richese/aeris/doc/presentations/presentation_q_learning.pdf

# Q learning - aproximácia funkcie ohodnotení neurónovou sieťou

# Michal CHOVANEC Fakulta riadenia a informatiky

# Jún 2015

Michal CHOVANEC Fakulta riadenia a informatiky | Q learning - aproximácia funkcie ohodnotení neurónovou sieťou

# Úvod

# Cieľom je nájsť optimálnu stratégiu - maximalizácia odmeny (účelovej funckie)

# - Vopred nie je známa hodnota odmeny vykonanej akcie

# - Vopred nie je známi ani stav do ktorého sa systém dostane

# - Je možné určiť v akom stave sa systém nachádza

# - Je presne daná množina akcií v každom stave

# - Aspoň pre cieľový stav je daná výška odmeny

# Úvod

# Aplikácie zo sveta robotických sytémov

# - Učenie sa pohybu, s ohľadom na techické prostriedky a terén - Multirobotické plánovanie - hľadanie optimálneho rozhodnutia pre celú skupinu

## - Mapovanie - Hľadanie cieľa - Robotický futbal - Capture the flag

# - Optimalizácia v automatických dopravných systémov

## - Dať prednosť, alebo predbehnúť - Kedy ísť zobrať náklad, predikcia

# - Všetky problémy kde : ako niečo urobiť je zložité popísať

## - Systém si učením sám nájde postup ako niečo robiť - Vyžaduje sa adativita a samostatnosť

# Q learning

# - Q(s, a) - funkcia ohodnotení

# - s - stav

# - a - akcia v stave s

# - R(s, a) - funkcia okamžitých odmien, za vykonanie a v stave s

s | ∈ S
as | ∈ As

# Q learning - prechod stavovým priestorom

# Markovov rozhodovací proces

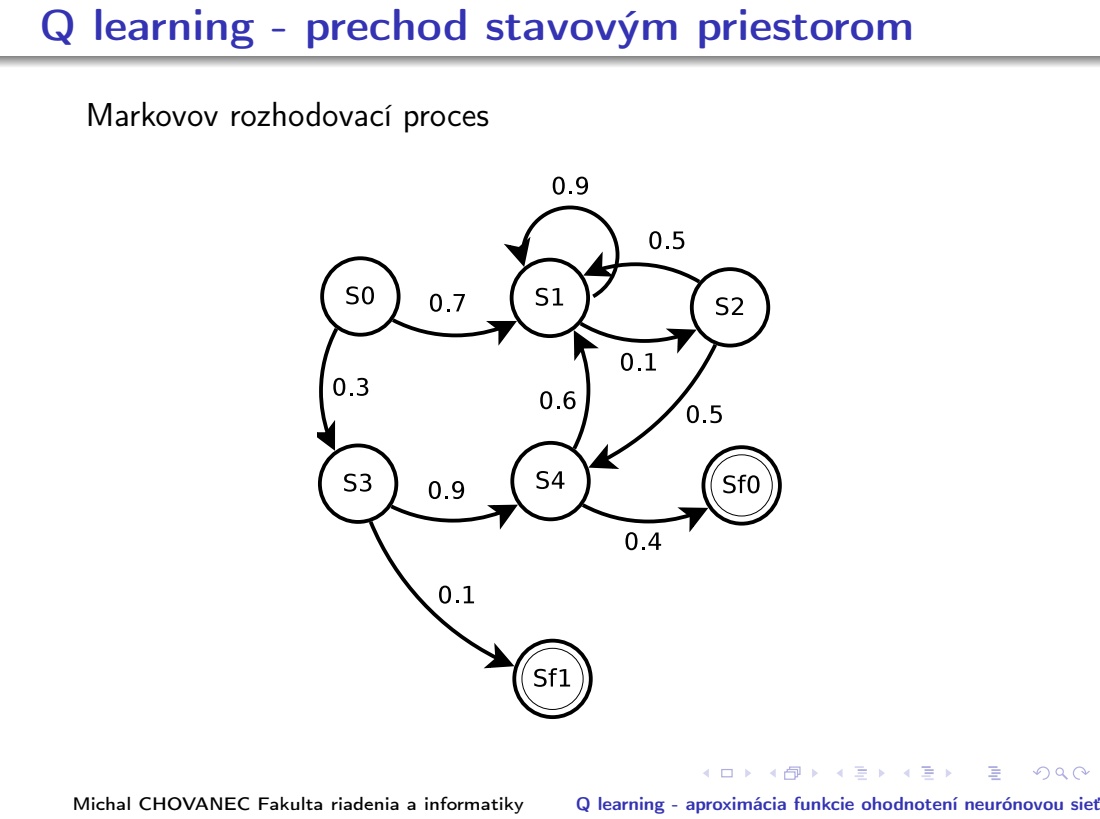
[picture p8: page 5]

# Q learning - ohodnotenie Q(s, a)

# Z Bellmanového princípu optimality

# Qn+1(s, a) = Rn+1(s, a) + γ max

a

0

# Qn(s

0
n+1

, a

0
) | (1)

# Kde Rn+1(s, a) je získaná odmena (reward) za vykonanie akcie a v stave s v čase n + 1

# maxa

# 0 Qn(s

0
n+1

, a

0

# ) je výber akcie v stave sn+1 ktorá má najväčšia odmenu

# γ je podiel z maximálnej odmeny v stave s

0
n+1

# pri vykonaní najlepšej možnej akcie v tomto stave

# Q learning - ohodnotenie Q(s, a)

# Varianty algoritmu Filtrovanie v stochastickom prostredí

# Qn+1(s, a) = αQn(s, a) + (1 − α)(Rn+1(s, a) + γ max

a

0

# Qn(s

0
n+1

, a

0
))

# SARSA algoritmus

# Qn+1(s, a) = αQn(s, a) + (1 − α)(Rn+1(s, a) + γQn(s

0
n+1

, a

0
))

# kde α ∈ h0, 1)

# Q learning - výber akcie

# Boltzmanové rozdelanie

# P(s|ai) = k

### Q(s,ai )

P
| j∈A

k

### Q(s,aj )

# Kde k ∈ h0, ∞) a určuje správanie sa agenta, pre Q(s, a) ∈ h−1, 1i možno pozorovať tieto druhy správania

# - k = 1 prieskumník

# - k = h2, 10i zlatý stred

# - k >> 10 pažravý (greedy) agent

# Q learning - problémy

# - Rosiahly stavový priestor, Q(s, a) je možné nájsť len približne

## - Interpolácia - Transformácia pomocou features a ich lineárna kombinácia - Aproximácia neurónovou sieťou

# - Výber akcie

## - Tak aby neboli prehľadávané akcie ktoré nemajú cenu

# - Zdieľanie a syntéza Q(s, a) medzi viacerími agentami

# Experiment

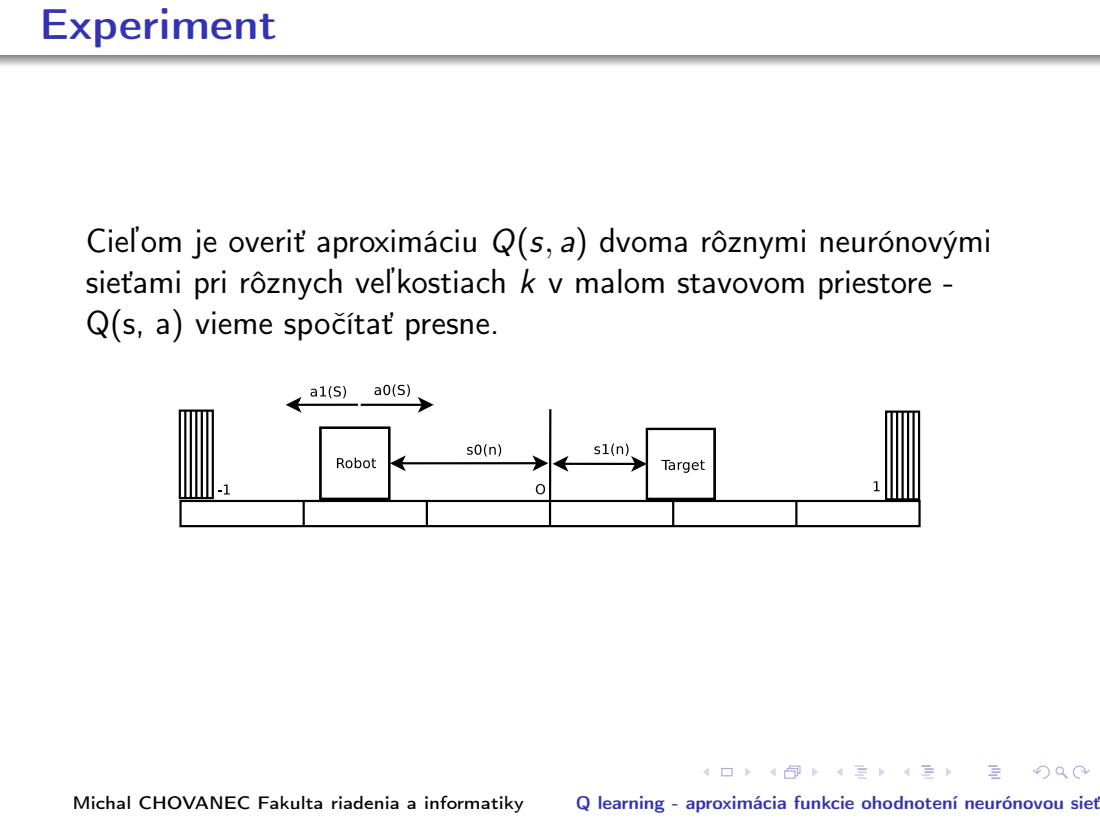
[picture p9: page 10]

Cieľom je overiť aproximáciu Q(s, a) dvoma rôznymi neurónovými
sieťami pri rôznych veľkostiach k v malom stavovom priestore -
Q(s, a) vieme spočítať presne.

# Experiment

# Boli porovnávané dva modely neurónov s optimálnym riešením

# y(n) = ϕ(

N

X⁻¹

i=0

xi(n)wi(n)) | (2)

# y(n) = X∞

j=1

N

X⁻¹

i=0

x

j
i

# (n)wji(n) +

N

X⁻¹

j=0

N

X⁻¹

i=j+1

# xi(n)xj(n)vji(n) (3)

# Prečo by 3 mal byt lepší? Kolmogorov teorém 3 skryté vrstvy !

# Experiment

# Hypotéza :

# Problém aproximácie q = Q(s, a) je pridelenie každému s, a práve jedno q. To vedie na formuláciu : AK je systém v stave s A bola vykonaná akcia a, POTOM výstup je

q.

# Pre jeden stav a dve akcie (ohodnotené ako a0, a1) možno napísať

q = va0 + (1 − v)a1 | (4)

# Kde v je výber akcie a platí v ∈ h0, 1i. Pozn. všetky veličiny sú

premenné. To je ale potom v súlade s 3.

# Experiment - parametre

## iterations = 10000000

## agent :

## state_density = 1/8.0 alpha = 0.98 gamma = 0.7

## neural network :

## hidden layers = 2 neurons in hidden layers = 10 weight range = 4.0 neuron order = 7 init weight range = 0.1 eta = 0.001

# Experiment, k = 1.1, optimálne riešenie

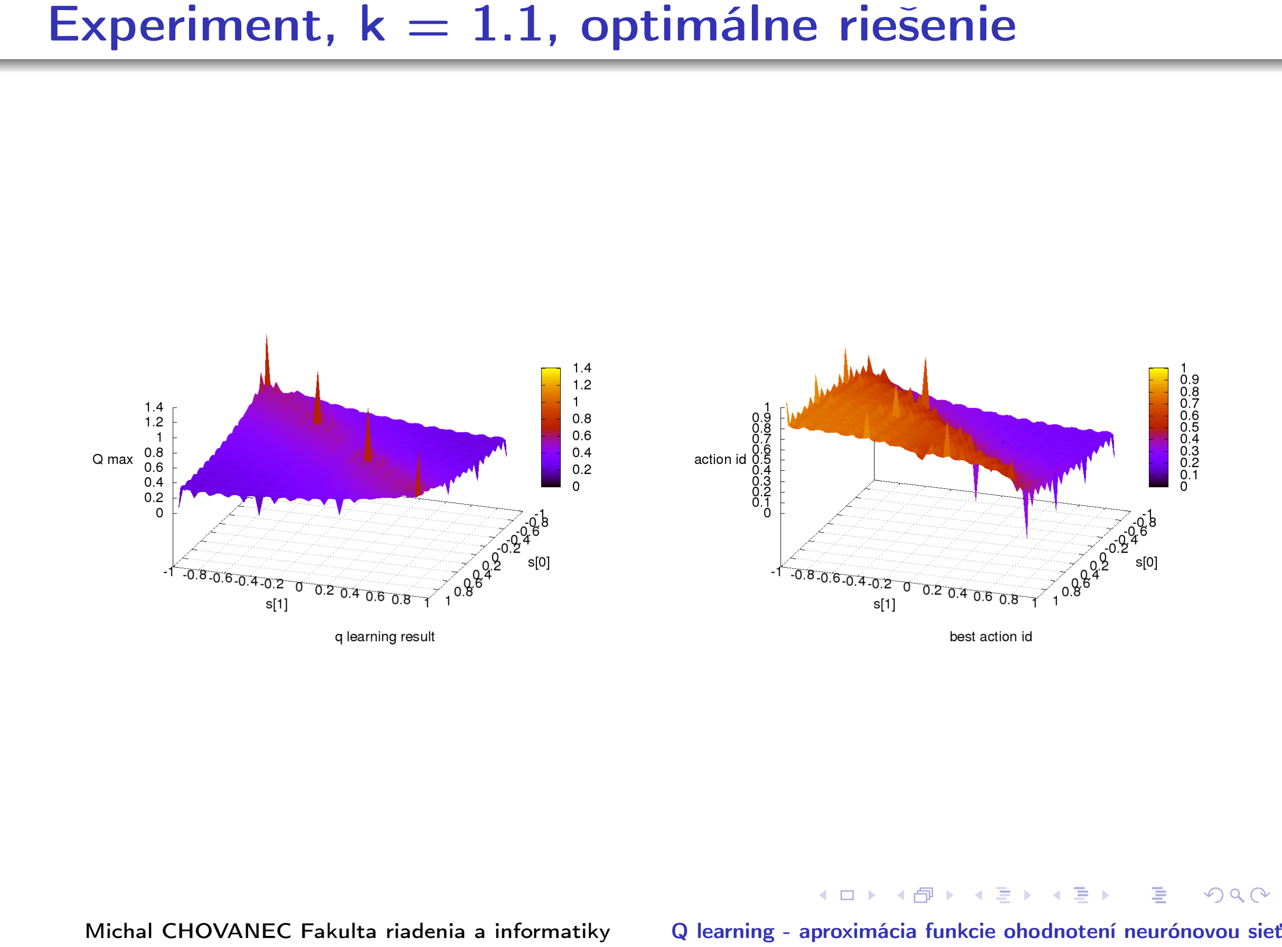
[picture p10: page 14]

# Experiment, k = 1.1, mcculloch pitts neurón

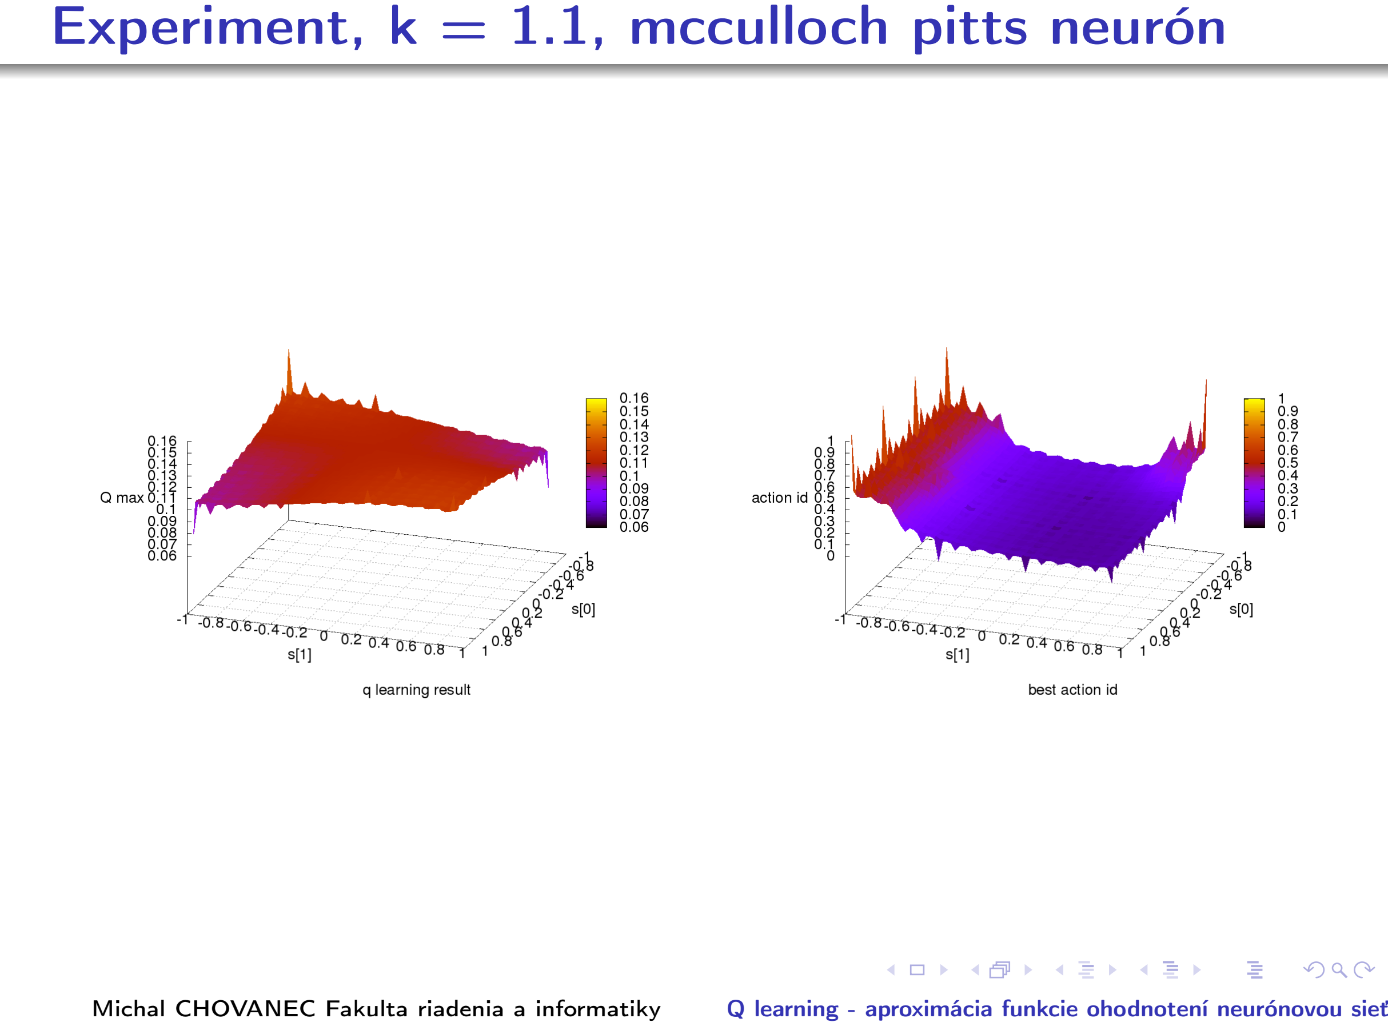
[picture p11: page 15]

# Experiment, k = 1.1, testovaný neurón

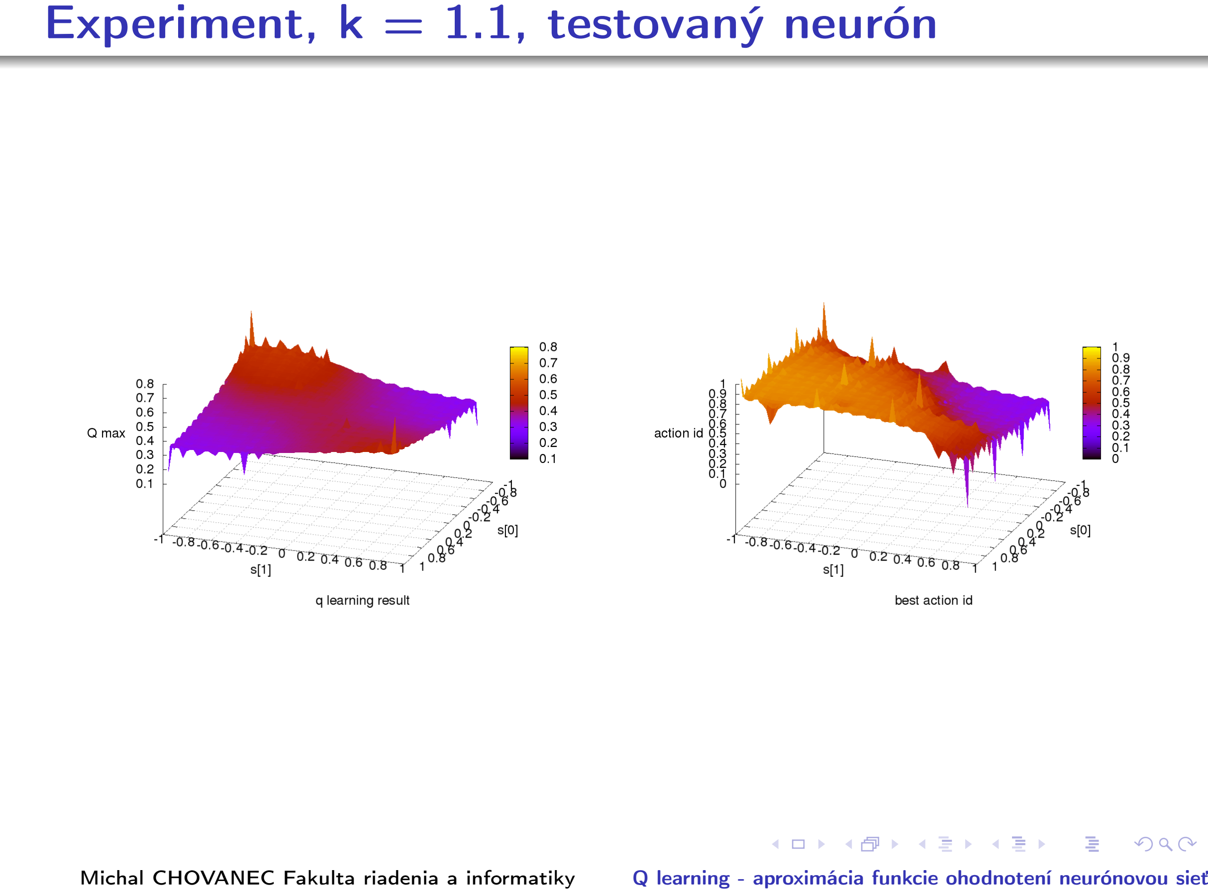
[picture p12: page 16]

# Experiment, k = 2.0, optimálne riešenie

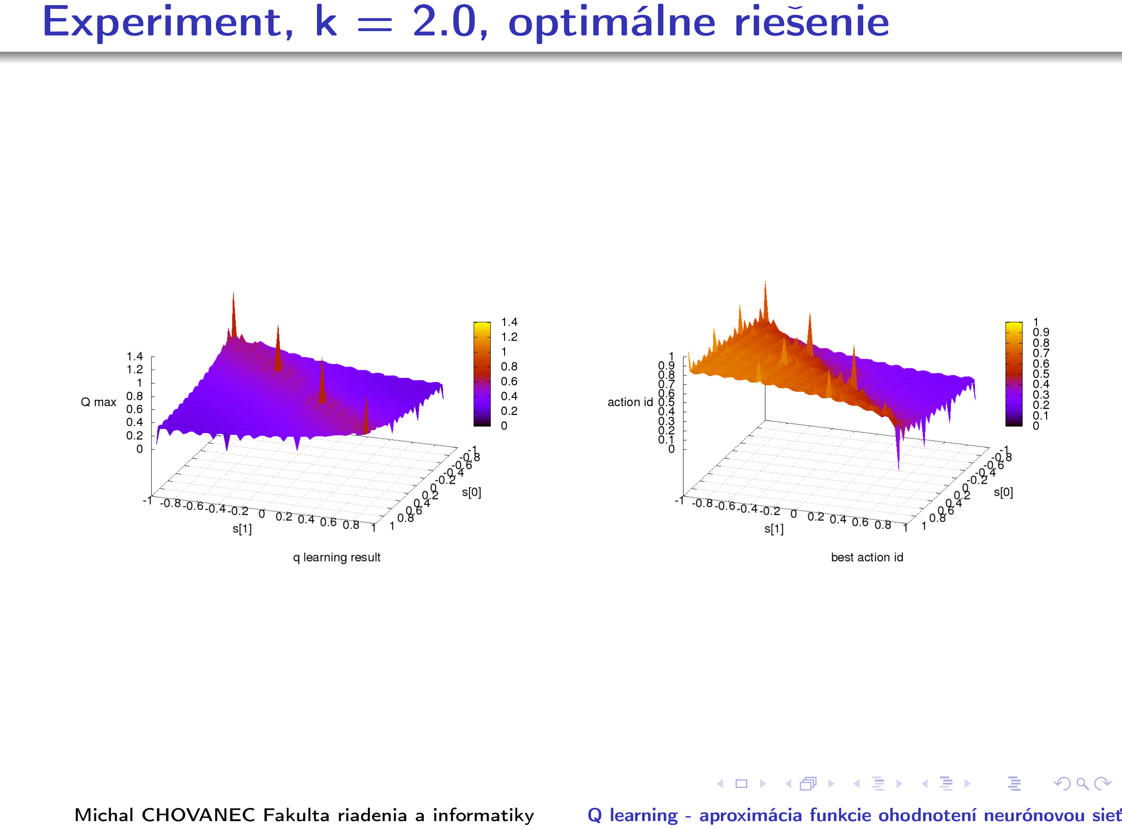
[picture p13: page 17]

# Experiment, k = 2.0, mcculloch pitts neurón

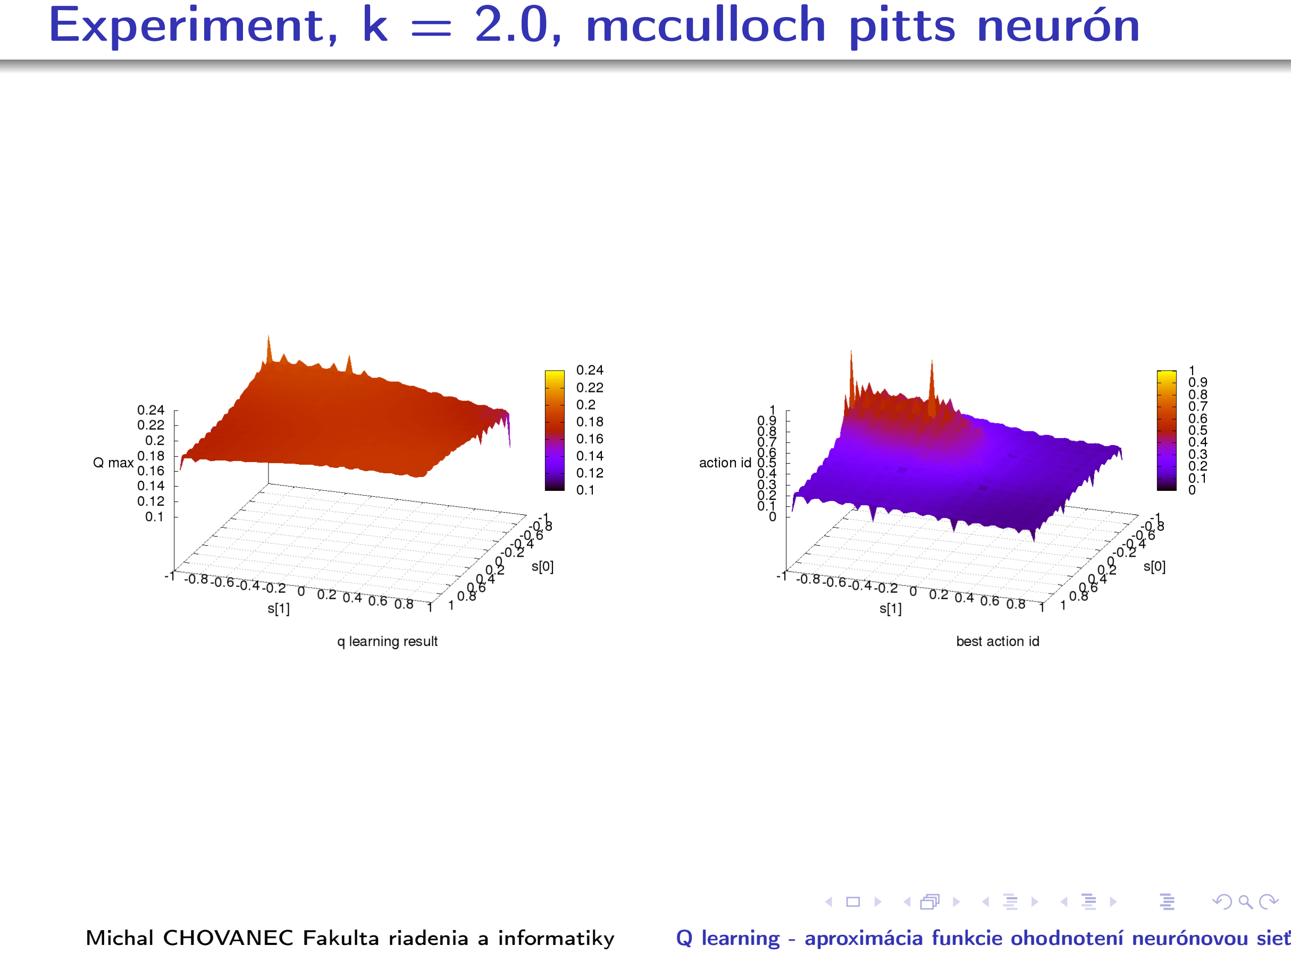
[picture p14: page 18]

# Experiment, k = 2.0, testovaný neurón

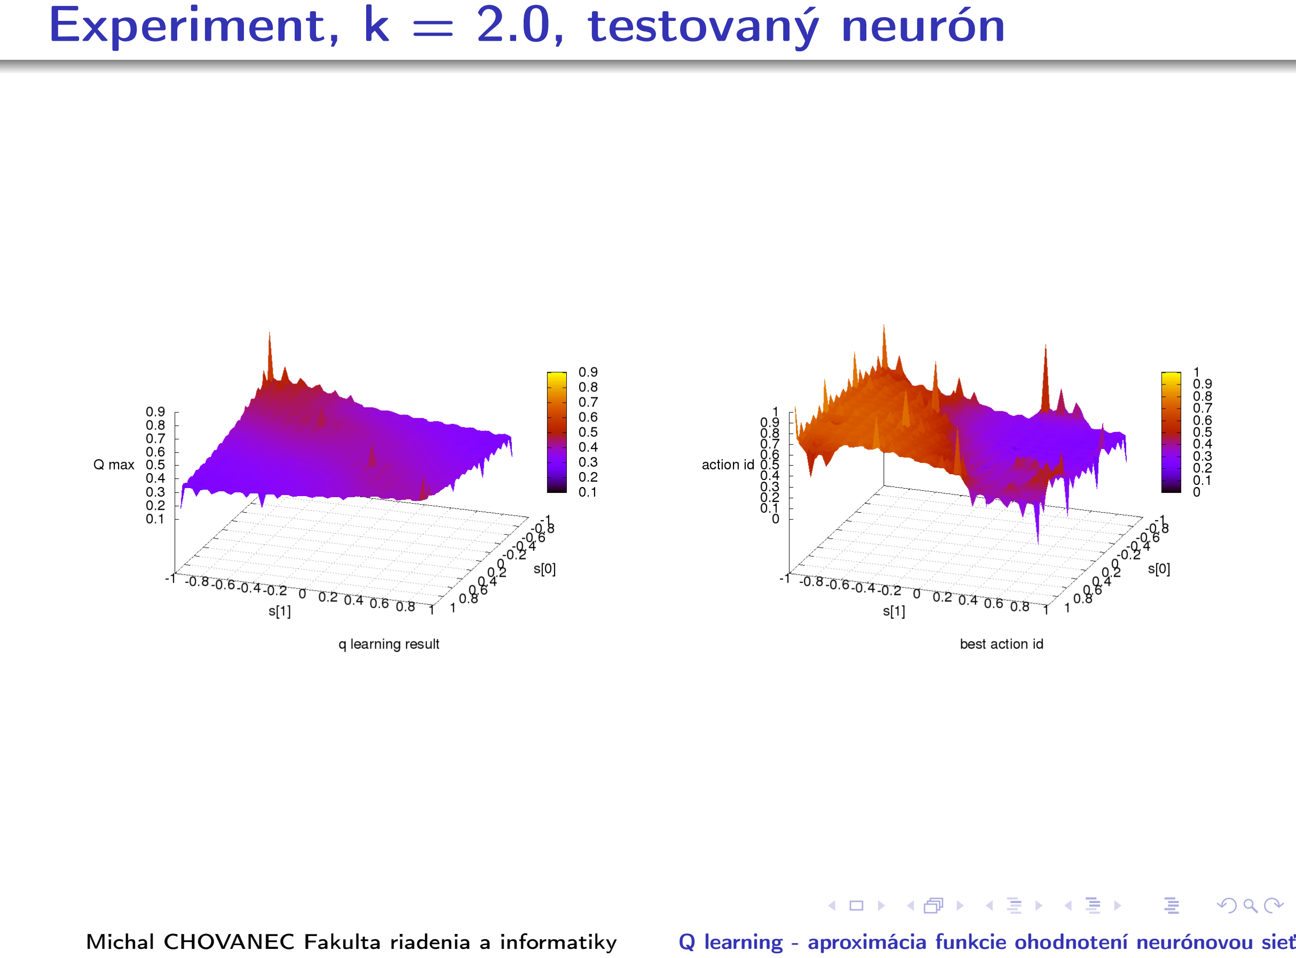
[picture p15: page 19]

# Experiment, k = 10.0, optimálne riešenie

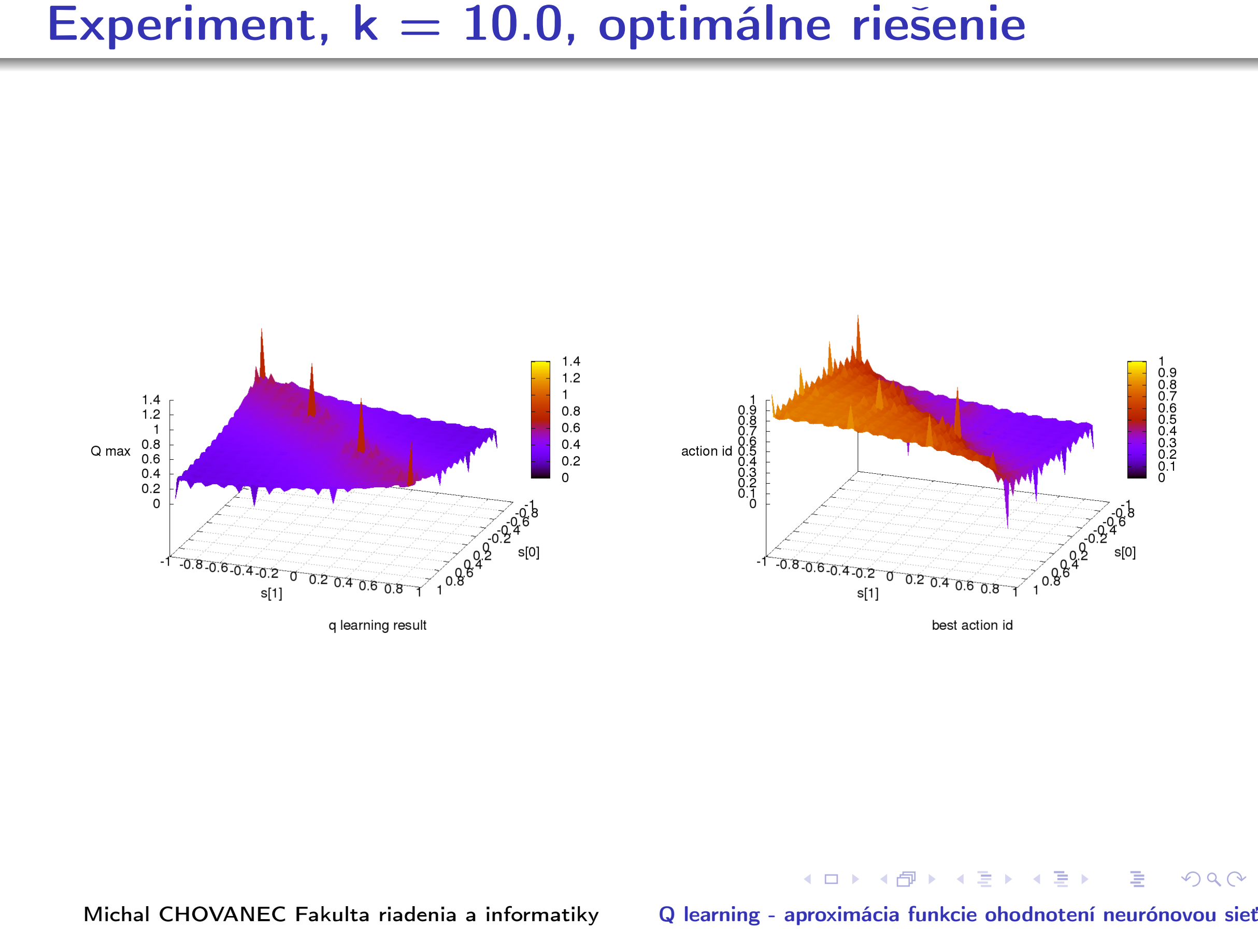
[picture p16: page 20]

# Experiment, k = 10.0, mcculloch pitts neurón

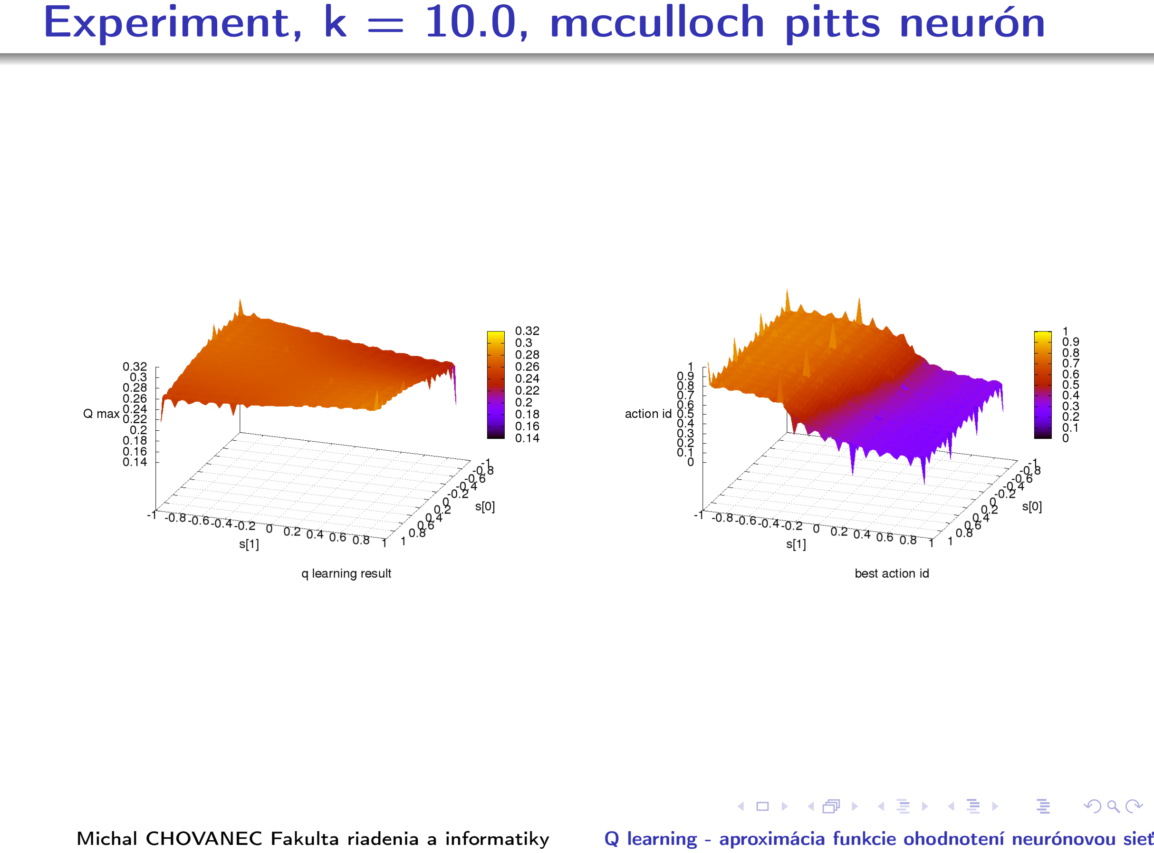
[picture p17: page 21]

# Experiment, k = 10.0, testovaný neurón

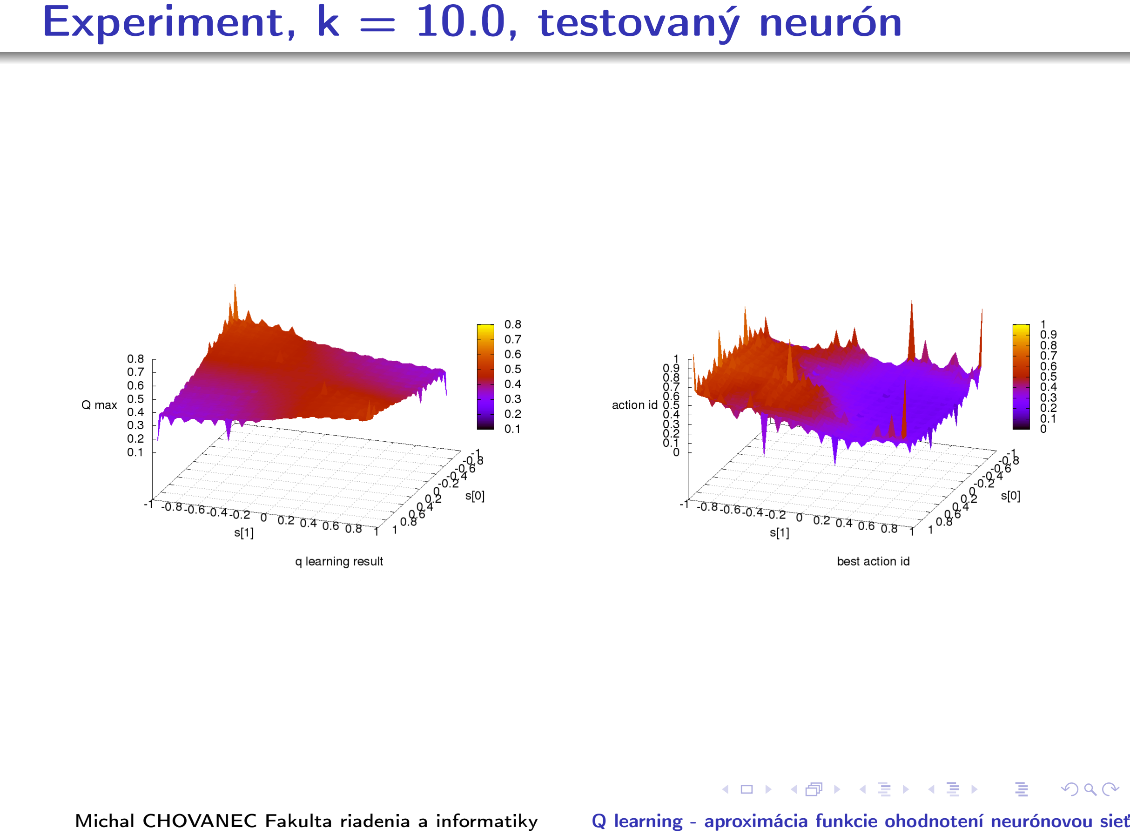
[picture p18: page 22]

# Experiment - zhrnutie

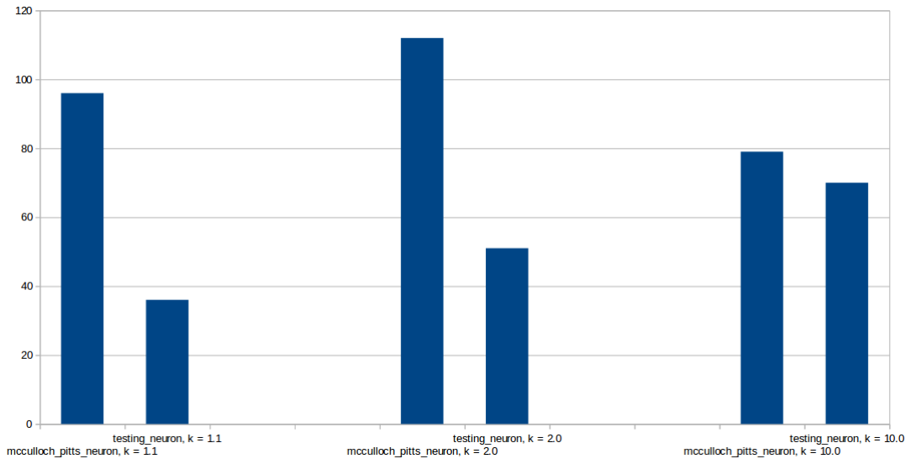
[picture p19: figure]

# Nevyriešené otázky

# ... ktorými sa momentálne zaoberám

# 1 Zrýchliť učenie neurónovej siete

# 2 Urobiť experiment vo veľkom stavovom priestore

# 3 Implementácia do vyvíjaného multirobotického frameworku

# Ďakujem za pozornosť

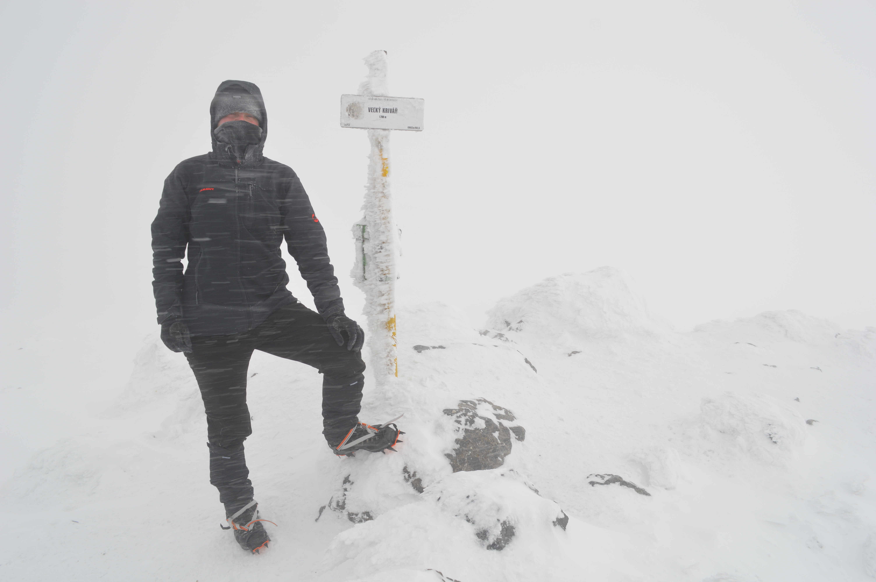
[picture p20: figure]

# michal.chovanec@yandex.com
