richese/aeris/doc/papers/q_learning/template.pdf

# Paper title

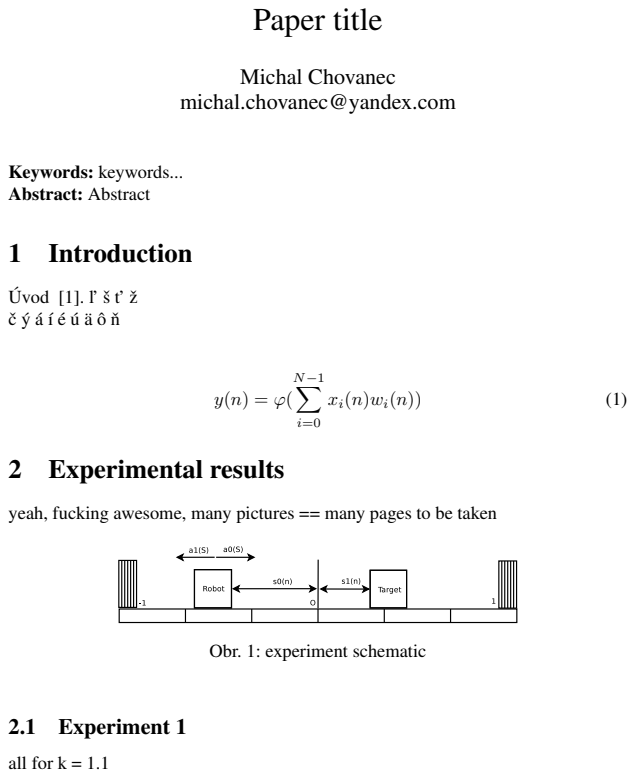
[picture p29: page 1]
Michal Chovanec; Keywords: keywords... Abstract: Abstract; 1 Introduction; Úvod [1]. l’ š t’ ž; 2 Experimental results; 2.1 Experiment 1; all for k = 1.1

michal.chovanec@yandex.com

yeah, fucking awesome, many pictures == many pages to be taken

Obr. 1: experiment schematic

Obr. 2: table Q max value

Obr. 3: table action id

Obr. 4: table action value

Obr. 5: mcculloch pitts neuron Q max value

Obr. 6: mcculloch pitts neuron best action id

Obr. 7: mcculloch pitts neuron best action value

Obr. 8: testing neuron Q max value

Obr. 9: testing neuron best action id

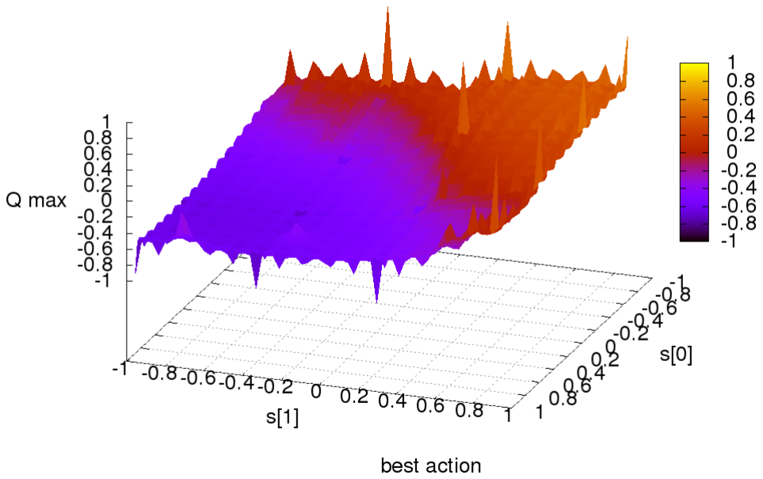
[picture p30: figure]

Obr. 10: testing neuron best action value

### 2.2 Experiment 2

all for k = 2.0

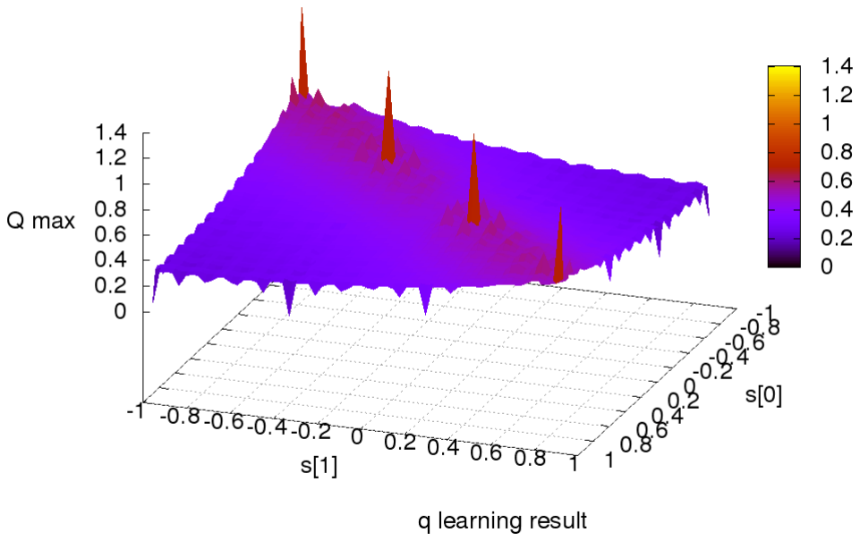
[picture p31: figure]

Obr. 11: table Q max value

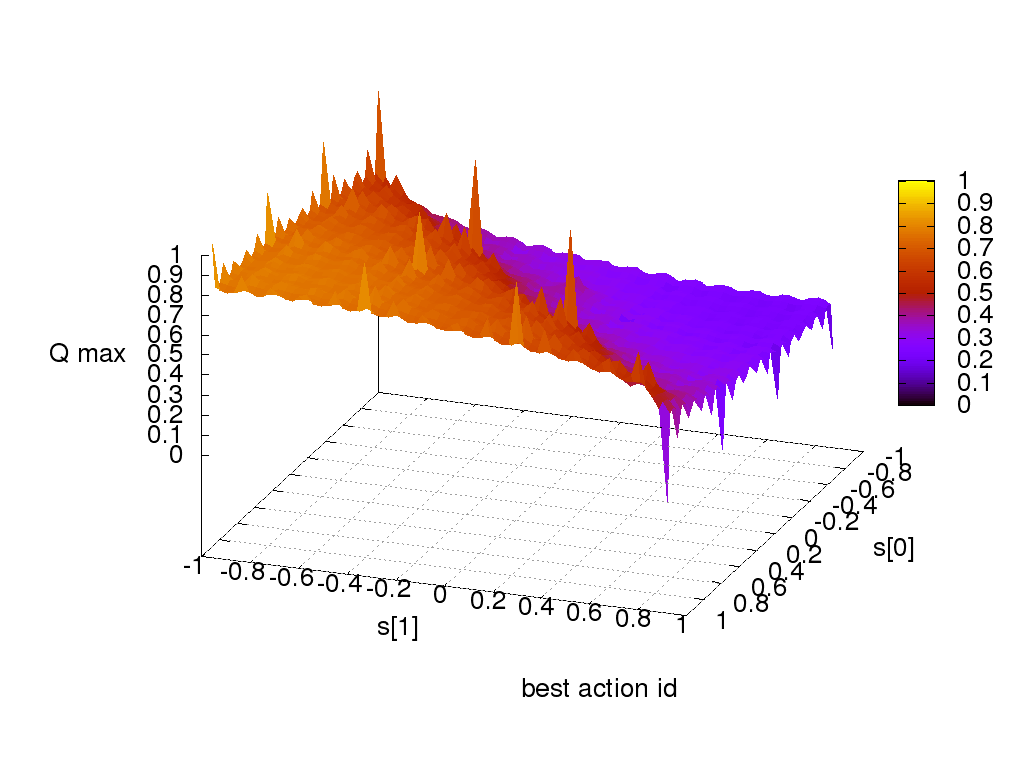
[picture p32: figure]

Obr. 12: table action id

Obr. 13: table action value

Obr. 14: mcculloch pitts neuron Q max value

Obr. 15: mcculloch pitts neuron best action id

Obr. 16: mcculloch pitts neuron best action value

Obr. 17: testing neuron Q max value

Obr. 18: testing neuron best action id

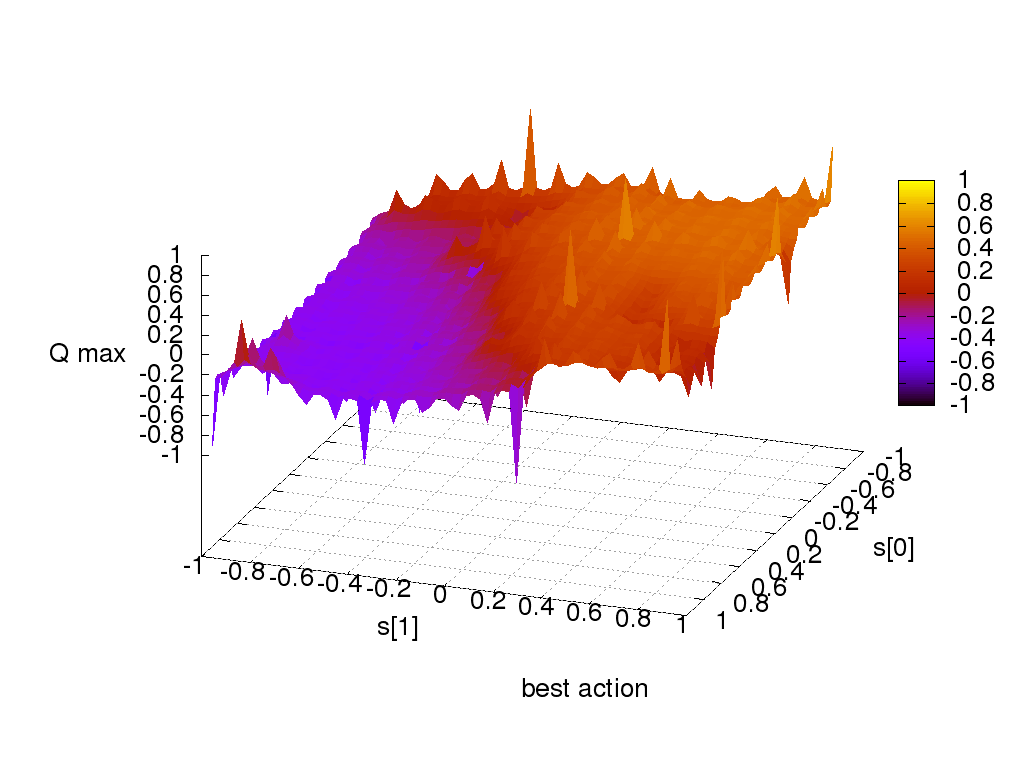
[picture p33: figure]

Obr. 19: testing neuron best action value

### 2.3 Experiment 3

all for k = 10.0

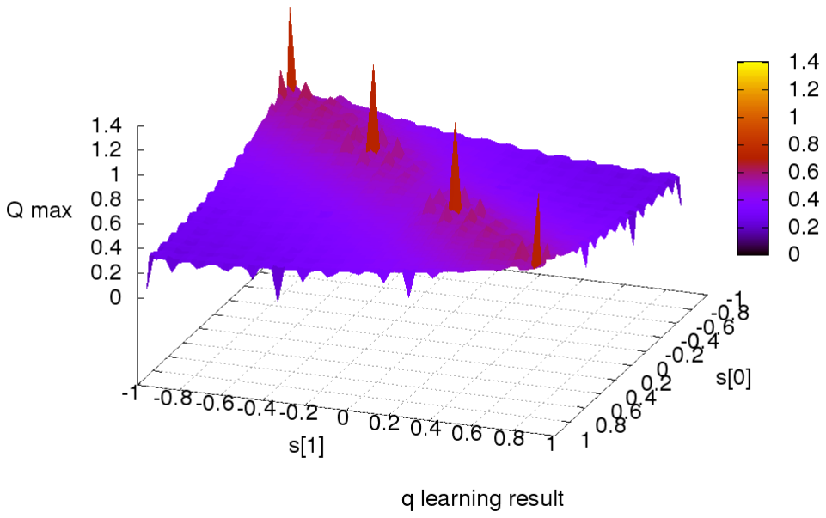
[picture p34: figure]

Obr. 20: table Q max value

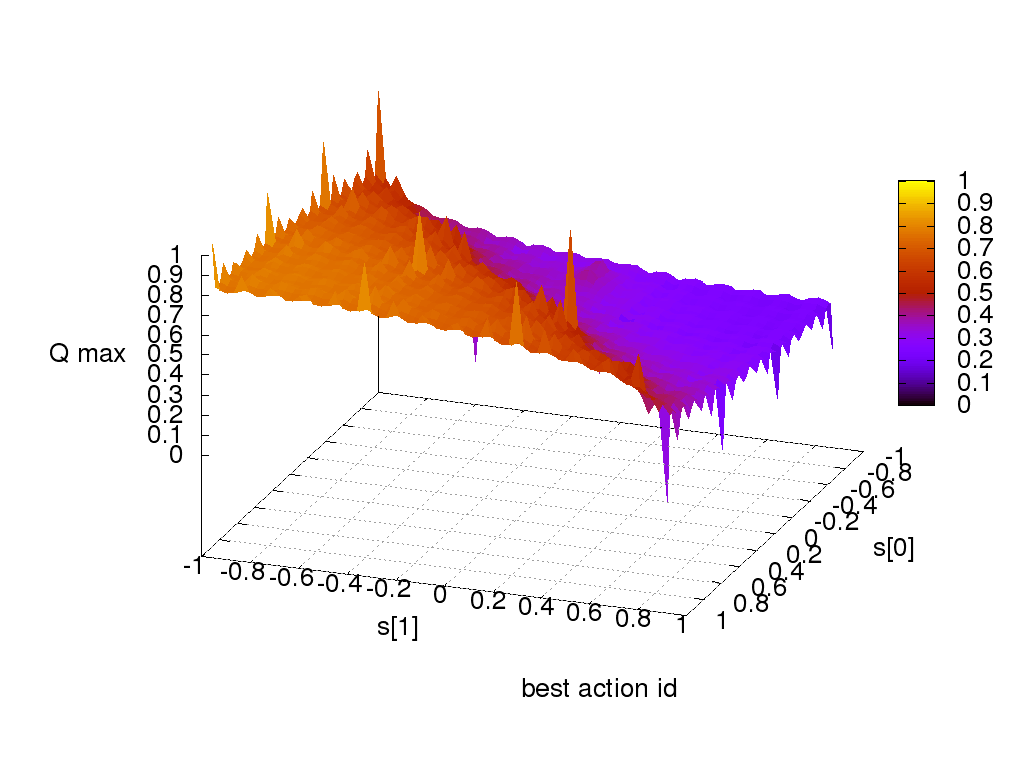
[picture p35: figure]

Obr. 21: table action id

Obr. 22: table action value

Obr. 23: mcculloch pitts neuron Q max value

Obr. 24: mcculloch pitts neuron best action id

Obr. 25: mcculloch pitts neuron best action value

Obr. 26: testing neuron Q max value

Obr. 27: testing neuron best action id

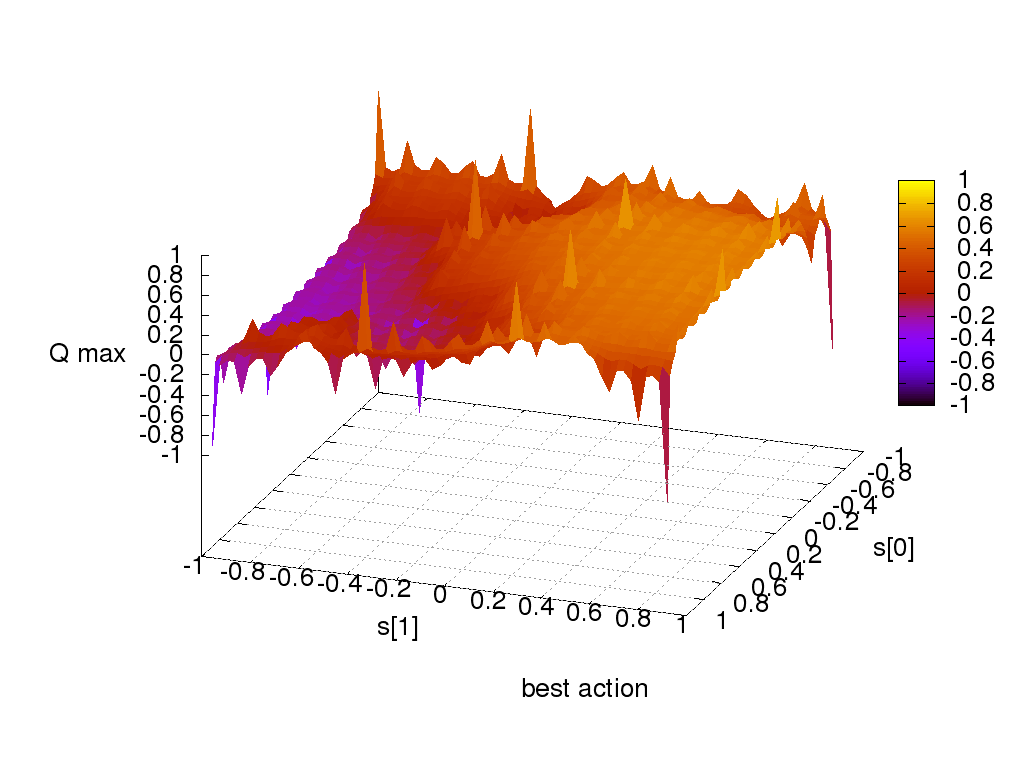
[picture p36: figure]

Obr. 28: testing neuron best action value

## 3 Zaver

## Literatúra

[1] Kolmogorov’s Theorem, http://neuron.eng.wayne.edu/tarek/MITbook/chap2/2_3.html
