richese/aeris/doc/diagrams/aeris_idea.png

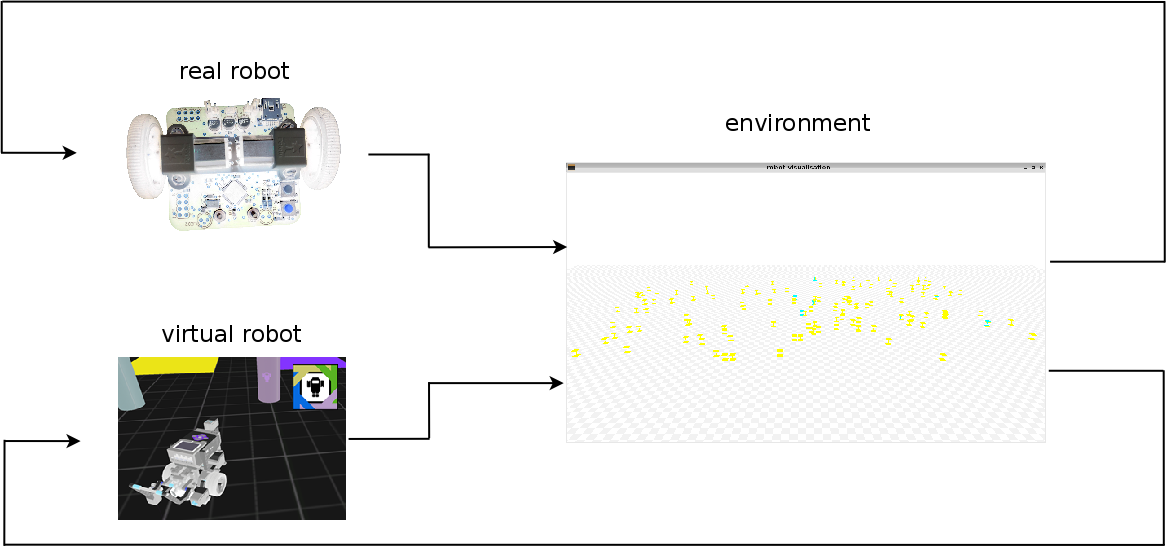
doc/diagrams/aeris_idea.png
