richese/aeris/doc/pictures/aeris_photo_02.png

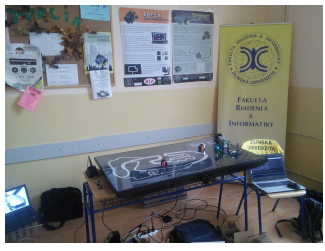
doc/pictures/aeris_photo_02.png
