richese/aeris/doc/pictures/aeris_static_linefollower_2.png

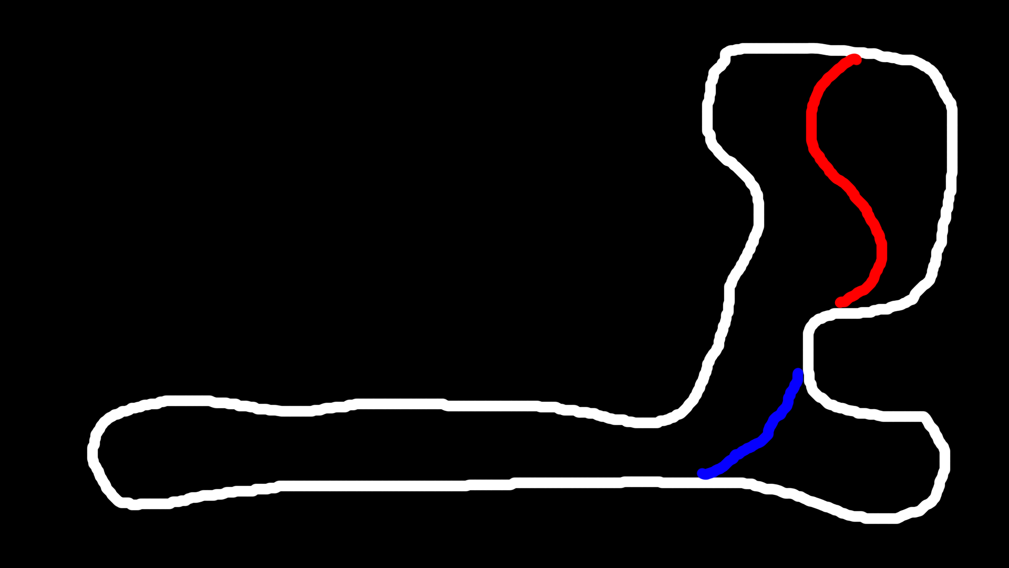
doc/pictures/aeris_static_linefollower_2.png
