richese/aeris/doc/pictures/desc_bottom.jpg

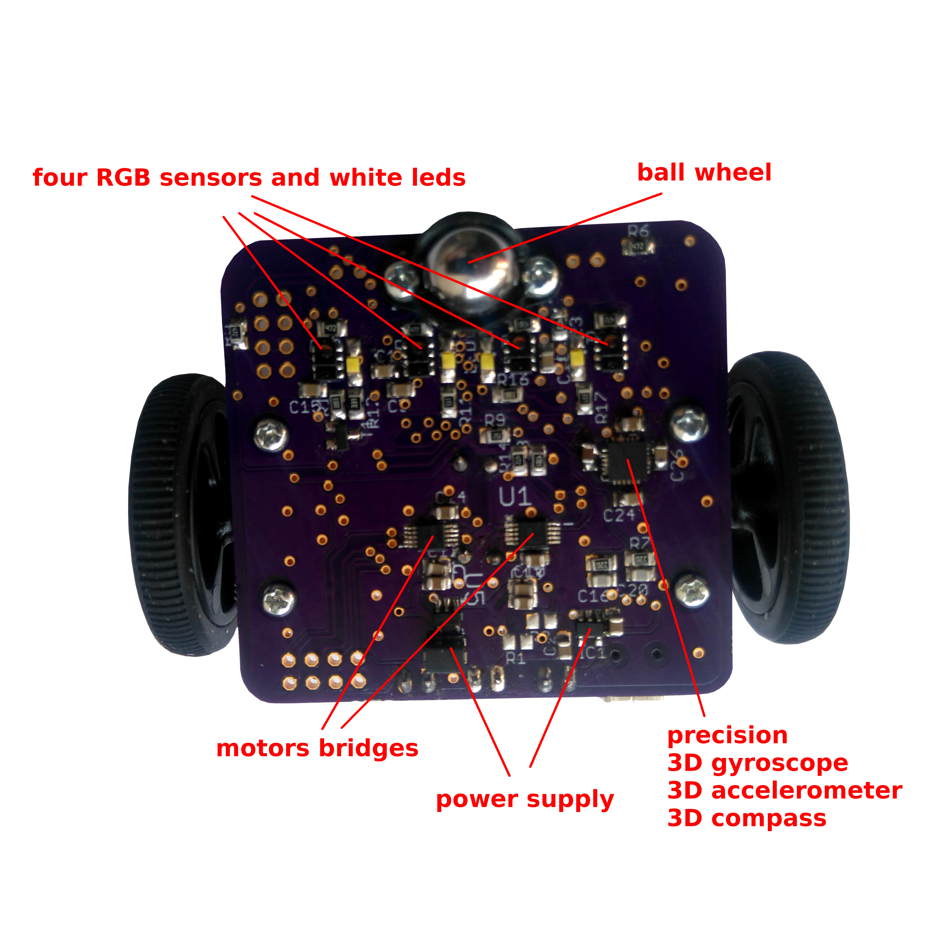
doc/pictures/desc_bottom.jpg
