richese/aeris/doc/pictures/desc_top.jpg

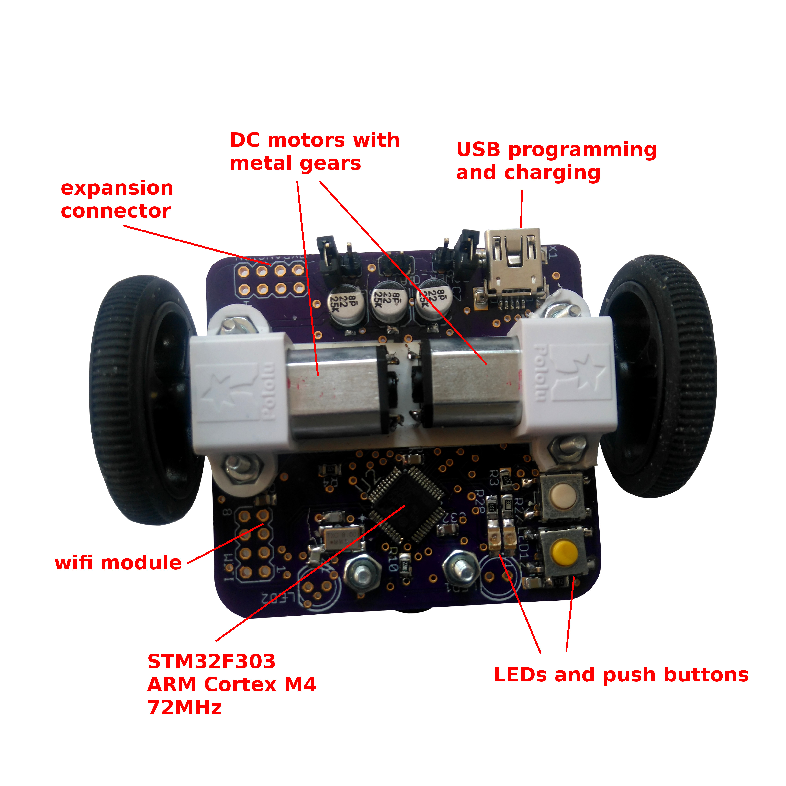
doc/pictures/desc_top.jpg
