richese/aeris/doc/pictures/virtual_env.png

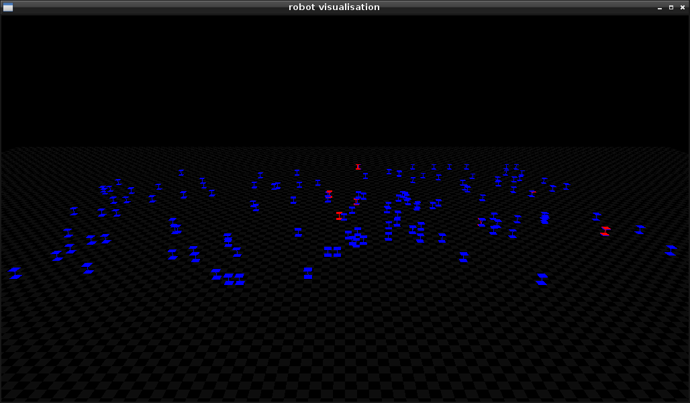
doc/pictures/virtual_env.png
