richese/aeris/doc/pictures/virtual_env_inv.png

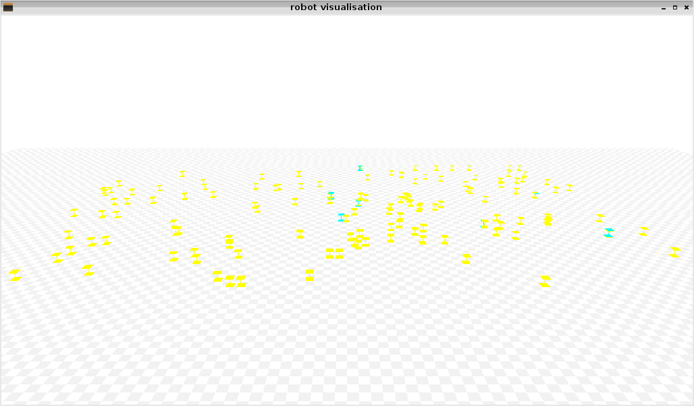
doc/pictures/virtual_env_inv.png
