richese/aeris/doc/pictures/virtual_robot.png

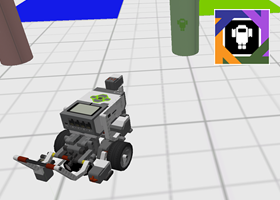
doc/pictures/virtual_robot.png
