richese/aeris/doc/pictures/virtual_robot_inv.png

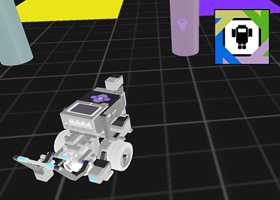
doc/pictures/virtual_robot_inv.png
