richese/aeris/embedded/hardware_2.0/rev_1.0/main_board/png_export/schem.png

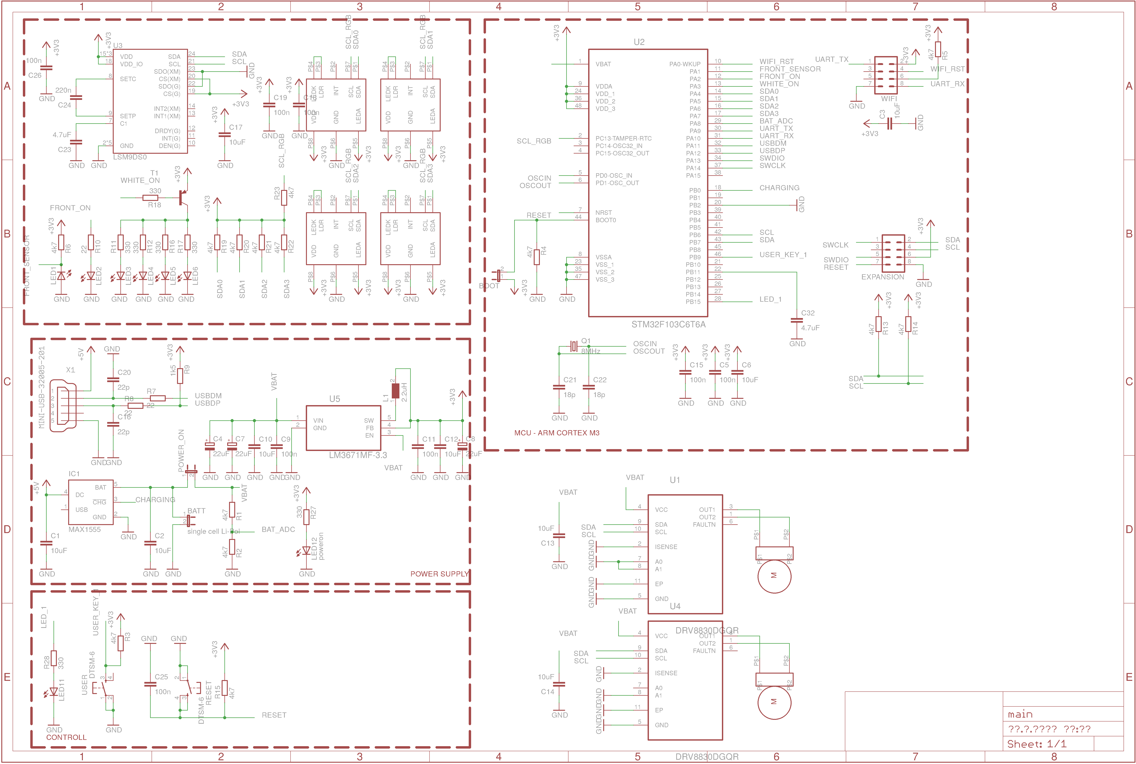
embedded/hardware_2.0/rev_1.0/main_board/png_export/schem.png
