richese/aeris/embedded/hardware_current/rev_1.0/main_board/schematic/main_board.png

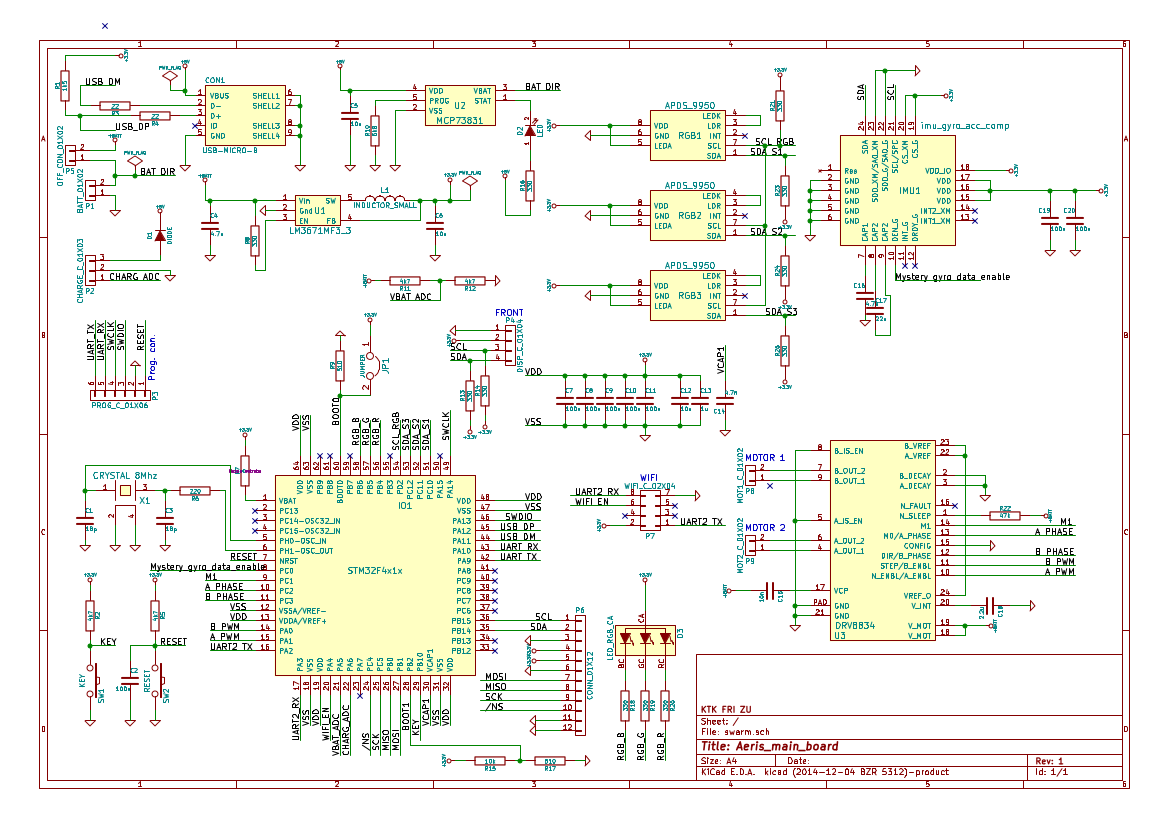
embedded/hardware_current/rev_1.0/main_board/schematic/main_board.png
