richese/aeris/src/tmp/ilc/bin/maneuvers_error.png

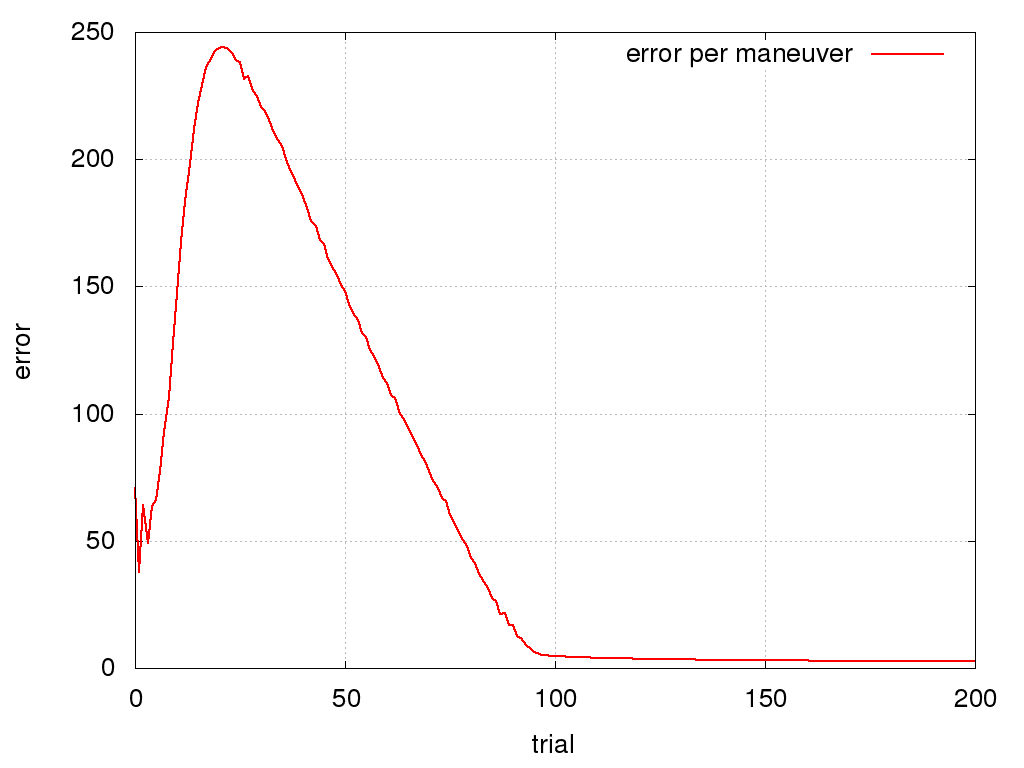
src/tmp/ilc/bin/maneuvers_error.png
