richese/aeris/src/tmp/ilc/bin/oscilating/maneuvers_error.png

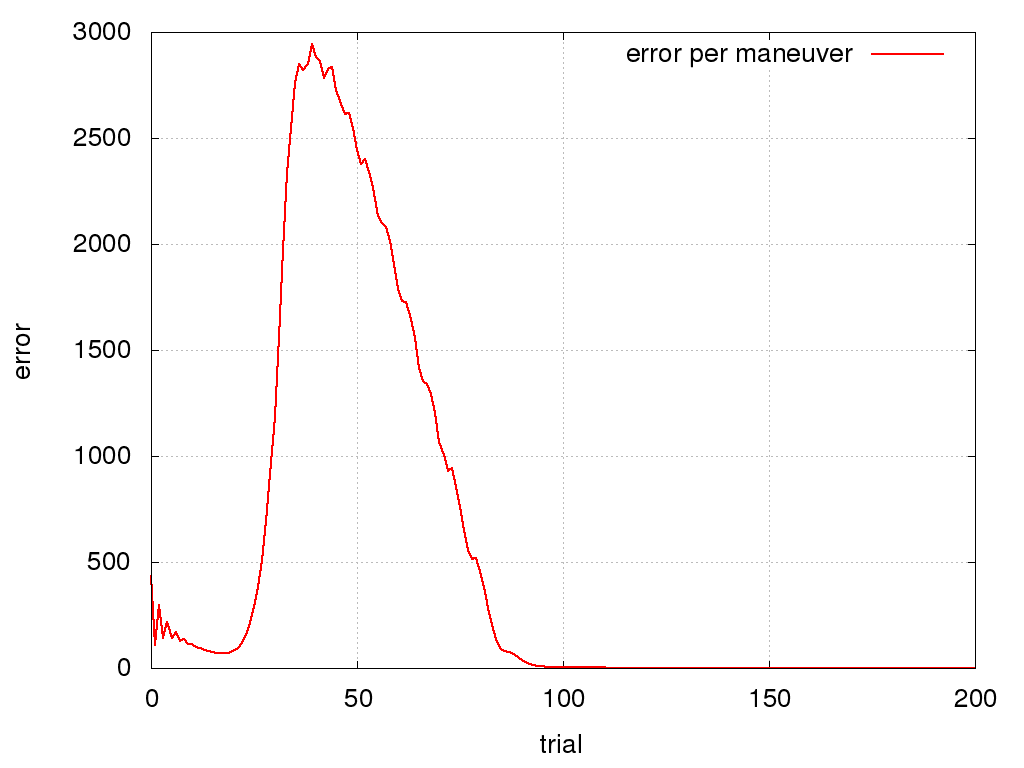
src/tmp/ilc/bin/oscilating/maneuvers_error.png
