richese/aeris/src/tmp/ilc/bin/servo_plant/maneuvers_error.png

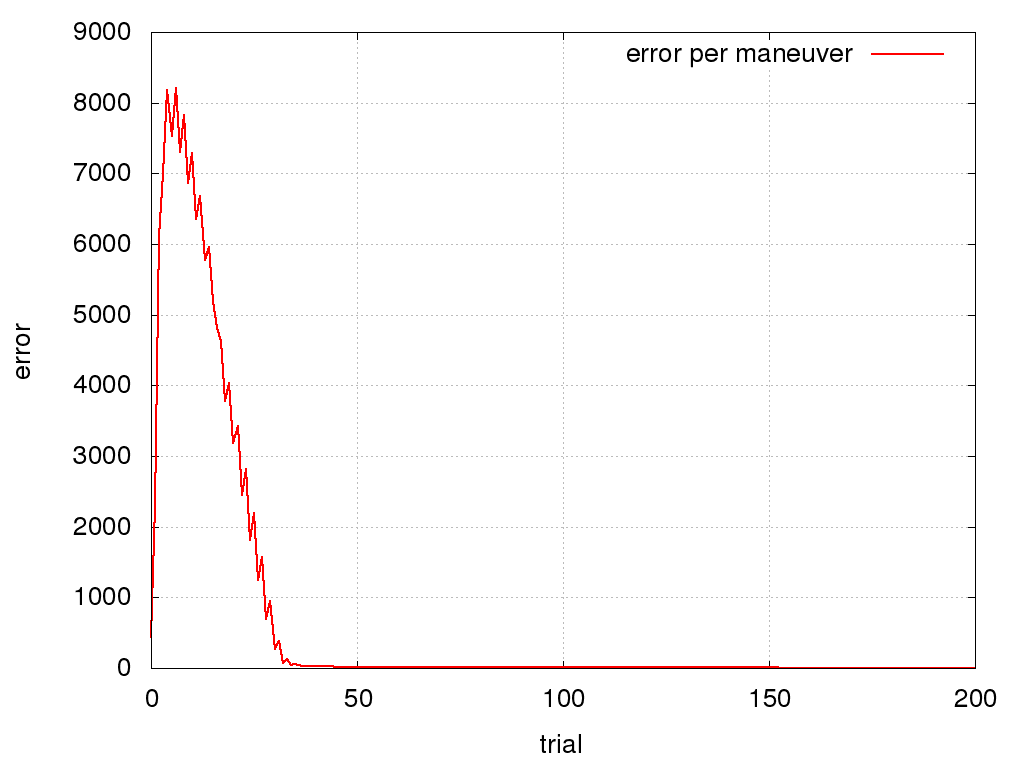
src/tmp/ilc/bin/servo_plant/maneuvers_error.png
