richese/aeris/src/tmp/ilc/bin/2nd_order/maneuvers_error.png

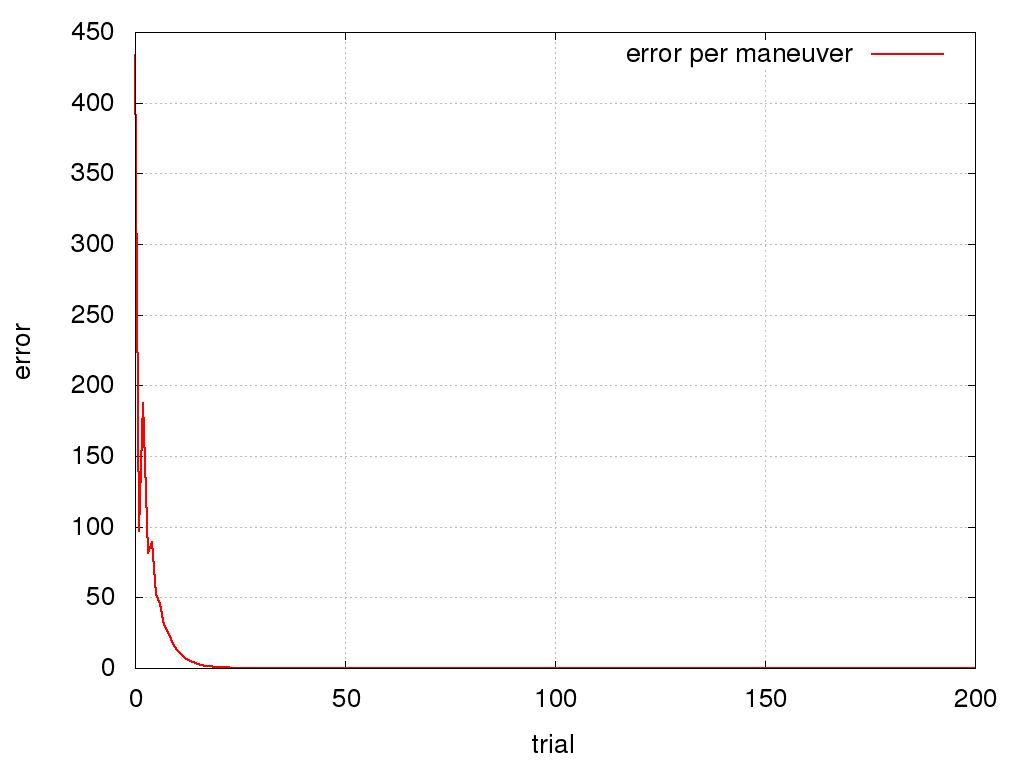
src/tmp/ilc/bin/2nd_order/maneuvers_error.png
