richese/aeris/src/tmp/ilc/bin/3rd_order/maneuvers_error.png

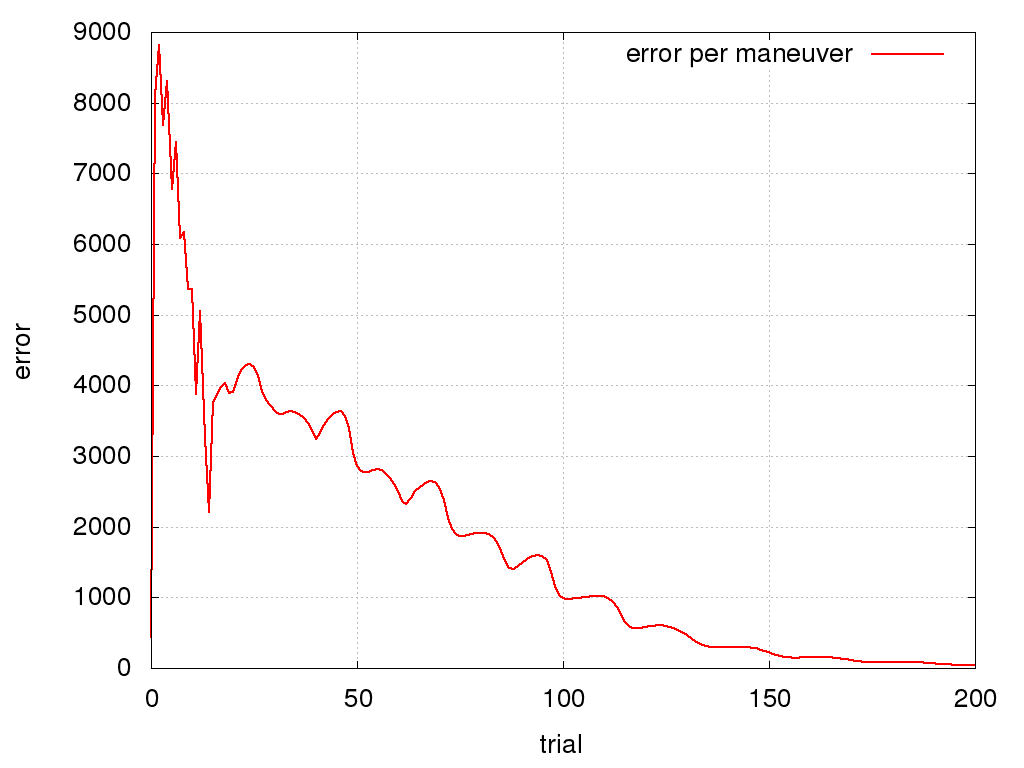
src/tmp/ilc/bin/3rd_order/maneuvers_error.png
