richese/aeris/doc/experiments_results/q_learning_test/comparsion.ods

Sheet: Sheet1
Experiment 01
mcculloch_pitts_neuron |  |  | error | testing_neuron |  |  | error | table
-1 | -1 | 1 | 1 | -1 | -1 | 1 | 1 | -1 | -1 | 0
-0.875 | -1 | 1 | 0 | -0.875 | -1 | 1 | 0 | -0.875 | -1 | 1
-0.75 | -1 | 1 | 0 | -0.75 | -1 | 1 | 0 | -0.75 | -1 | 1
-0.625 | -1 | 1 | 0 | -0.625 | -1 | 1 | 0 | -0.625 | -1 | 1
-0.5 | -1 | 1 | 0 | -0.5 | -1 | 1 | 0 | -0.5 | -1 | 1
-0.375 | -1 | 1 | 0 | -0.375 | -1 | 1 | 0 | -0.375 | -1 | 1
-0.25 | -1 | 1 | 0 | -0.25 | -1 | 1 | 0 | -0.25 | -1 | 1
-0.125 | -1 | 1 | 0 | -0.125 | -1 | 1 | 0 | -0.125 | -1 | 1
0 | -1 | 1 | 0 | 0 | -1 | 1 | 0 | 0 | -1 | 1
0.125 | -1 | 1 | 0 | 0.125 | -1 | 1 | 0 | 0.125 | -1 | 1
0.25 | -1 | 1 | 0 | 0.25 | -1 | 1 | 0 | 0.25 | -1 | 1
0.375 | -1 | 1 | 0 | 0.375 | -1 | 1 | 0 | 0.375 | -1 | 1
0.5 | -1 | 1 | 0 | 0.5 | -1 | 1 | 0 | 0.5 | -1 | 1
0.625 | -1 | 1 | 0 | 0.625 | -1 | 1 | 0 | 0.625 | -1 | 1
0.75 | -1 | 1 | 0 | 0.75 | -1 | 1 | 0 | 0.75 | -1 | 1
0.875 | -1 | 1 | 0 | 0.875 | -1 | 1 | 0 | 0.875 | -1 | 1
-1 | -0.875 | 1 | 1 | -1 | -0.875 | 0 | 0 | -1 | -0.875 | 0
-0.875 | -0.875 | 1 | 0 | -0.875 | -0.875 | 1 | 0 | -0.875 | -0.875 | 1
-0.75 | -0.875 | 1 | 0 | -0.75 | -0.875 | 1 | 0 | -0.75 | -0.875 | 1
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
