richese/aeris/src (copy)/old/tmp/curve/bin/result.txt

0.000000	2.000000	0.000000	0.000000	0.000000	
0.035257	2.016709	0.000000	0.000000	0.000000	
0.078960	2.026845	0.000000	0.000000	0.000000	
0.130943	2.030440	0.000000	0.000000	0.000000	
0.190946	2.027552	0.000000	0.000000	0.000000	
0.258623	2.018267	0.000000	0.000000	0.000000	
0.333541	2.002695	0.000000	0.000000	0.000000	
0.415187	1.980973	0.000000	0.000000	0.000000	
0.502972	1.953262	0.000000	0.000000	0.000000	
0.596234	1.919746	0.000000	0.000000	0.000000	
0.694250	1.880632	0.000000	0.000000	0.000000	
0.796234	1.836152	0.000000	0.000000	0.000000	
0.901355	1.786555	0.000000	0.000000	0.000000	
1.008737	1.732113	0.000000	0.000000	0.000000	
1.117469	1.673114	0.000000	0.000000	0.000000	
1.226616	1.609865	0.000000	0.000000	0.000000	
1.335227	1.542687	0.000000	0.000000	0.000000	
1.442344	1.471918	0.000000	0.000000	0.000000	
1.547009	1.397907	0.000000	0.000000	0.000000	
1.648277	1.321013	0.000000	0.000000	0.000000	
1.745223	1.241607	0.000000	0.000000	0.000000	
1.836951	1.160065	0.000000	0.000000	0.000000	
1.922603	1.076773	0.000000	0.000000	0.000000	
2.001369	0.992117	0.000000	0.000000	0.000000	
2.072490	0.906489	0.000000	0.000000	0.000000	
2.135271	0.820278	0.000000	0.000000	0.000000	
2.189083	0.733877	0.000000	0.000000	0.000000	
2.233376	0.647672	0.000000	0.000000	0.000000	
2.267674	0.562047	0.000000	0.000000	0.000000	
2.291590	0.477378	0.000000	0.000000	0.000000	
2.304824	0.394034	0.000000	0.000000	0.000000	
2.307166	0.312376	0.000000	-0.000000	0.000000	
2.298502	0.232751	0.000000	-0.000000	0.000000	
2.278812	0.155496	0.000000	-0.000000	0.000000	
2.248171	0.080932	0.000000	-0.000000	0.000000	
2.206748	0.009366	0.000000	-0.000000	0.000000	
2.154807	-0.058913	0.000000	-0.000000	0.000000	
2.092701	-0.123633	0.000000	-0.000000	0.000000	
2.020871	-0.184541	0.000000	-0.000000	0.000000	
1.939842	-0.241405	0.000000	-0.000000	0.000000	
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
