richese/aeris/src (copy)/old/tmp/ilc/bin/maneuvers_result.txt

0.000000	0.000000	0.000000	0.000000	0.000000	0.000000	
0.000000	1.000000	0.000000	0.000000	0.000000	0.000000	
0.000000	2.000000	0.000000	0.000000	0.000000	0.000000	
0.000000	3.000000	0.000000	0.000000	0.000000	0.000000	
0.000000	4.000000	0.000000	0.000000	0.000000	0.000000	
0.000000	5.000000	0.000000	0.000000	0.000000	0.000000	
0.000000	6.000000	0.000000	0.000000	0.000000	0.000000	
0.000000	7.000000	0.000000	0.000000	0.000000	0.000000	
0.000000	8.000000	0.000000	0.000000	0.000000	0.000000	
0.000000	9.000000	0.000000	0.000000	0.000000	0.000000	
0.000000	10.000000	0.000000	0.600000	2.000000	0.000000	
0.000000	11.000000	1.000000	1.000000	0.529152	0.400000	
0.000000	12.000000	1.000000	1.000000	-0.060302	-0.000000	
0.000000	13.000000	1.000000	1.000000	0.793031	0.000000	
0.000000	14.000000	1.000000	1.000000	0.793031	-0.000000	
0.000000	15.000000	1.000000	1.000000	0.793031	0.000000	
0.000000	16.000000	1.000000	1.000000	0.793031	-0.000000	
0.000000	17.000000	1.000000	1.000000	0.793031	0.000000	
0.000000	18.000000	1.000000	1.000000	0.793030	-0.000000	
0.000000	19.000000	1.000000	1.000000	0.793033	0.000000	
0.000000	20.000000	1.000000	0.162091	-2.000000	-0.000000	
0.000000	21.000000	0.000000	0.000000	1.375780	-0.162091	
0.000000	22.000000	0.000000	-0.000001	0.345788	-0.000000	
0.000000	23.000000	0.000000	0.000004	0.000020	0.000001	
0.000000	24.000000	0.000000	-0.000005	-0.000036	-0.000004	
0.000000	25.000000	0.000000	0.000001	0.000032	0.000005	
0.000000	26.000000	0.000000	0.000007	0.000007	-0.000001	
0.000000	27.000000	0.000000	-0.000010	-0.000061	-0.000007	
0.000000	28.000000	0.000000	0.000001	0.000064	0.000010	
0.000000	29.000000	0.000000	0.000009	0.000003	-0.000001	
0.000000	30.000000	0.000000	-0.000000	-0.000040	-0.000009	
0.000000	31.000000	0.000000	0.599994	2.000000	0.000000	
0.000000	32.000000	1.000000	0.999978	0.529106	0.400006	
0.000000	33.000000	1.000000	1.000026	-0.060124	0.000022	
0.000000	34.000000	1.000000	1.000020	0.792926	-0.000026	
0.000000	35.000000	1.000000	0.999946	0.792815	-0.000020	
0.000000	36.000000	1.000000	1.000002	0.793331	0.000054	
0.000000	37.000000	1.000000	1.000072	0.793148	-0.000002	
0.000000	38.000000	1.000000	0.999972	0.792604	-0.000072	
0.000000	39.000000	1.000000	0.999919	0.793047	0.000028	
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
