richese/aeris/src/q_learning_test_02/bin/q_action.png

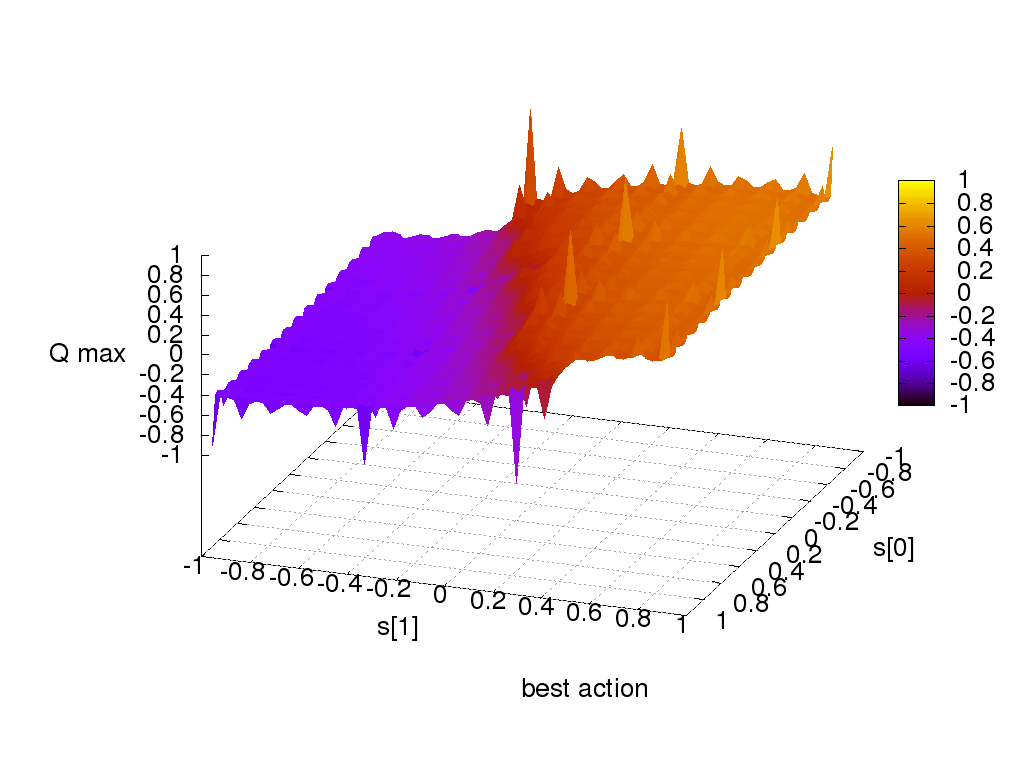
src/q_learning_test_02/bin/q_action.png
