richese/aeris/src/q_learning_test_02/bin/q_map.png

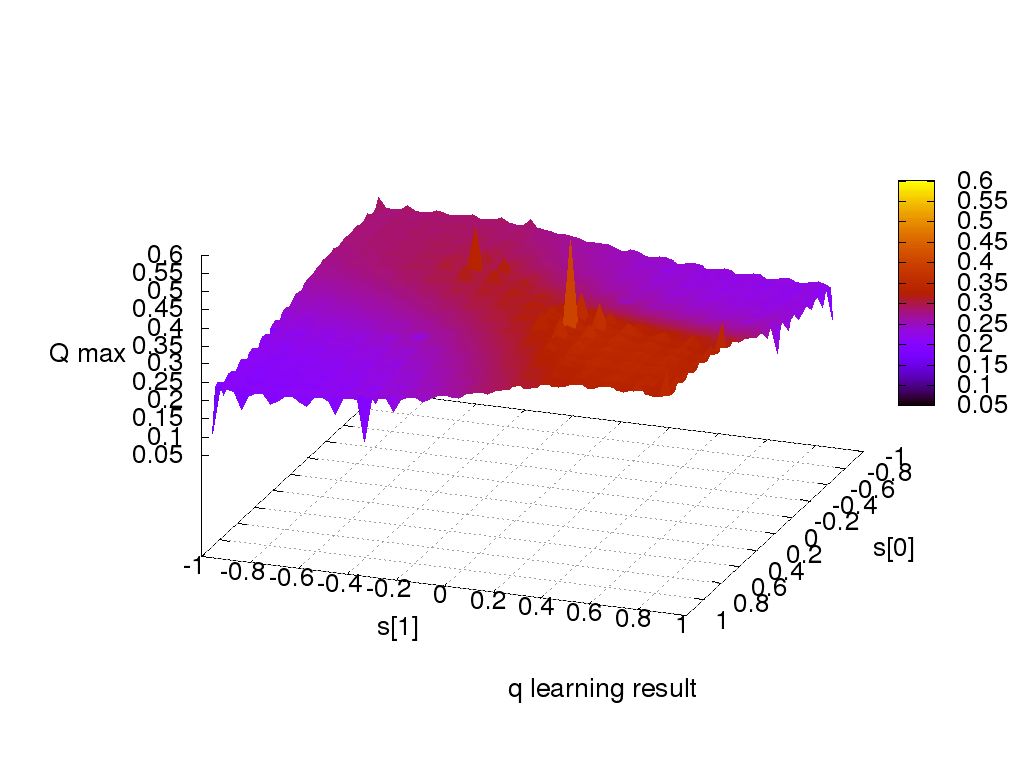
src/q_learning_test_02/bin/q_map.png
