richese/aeris/src/tmp/curve (copy)/bin/result.png

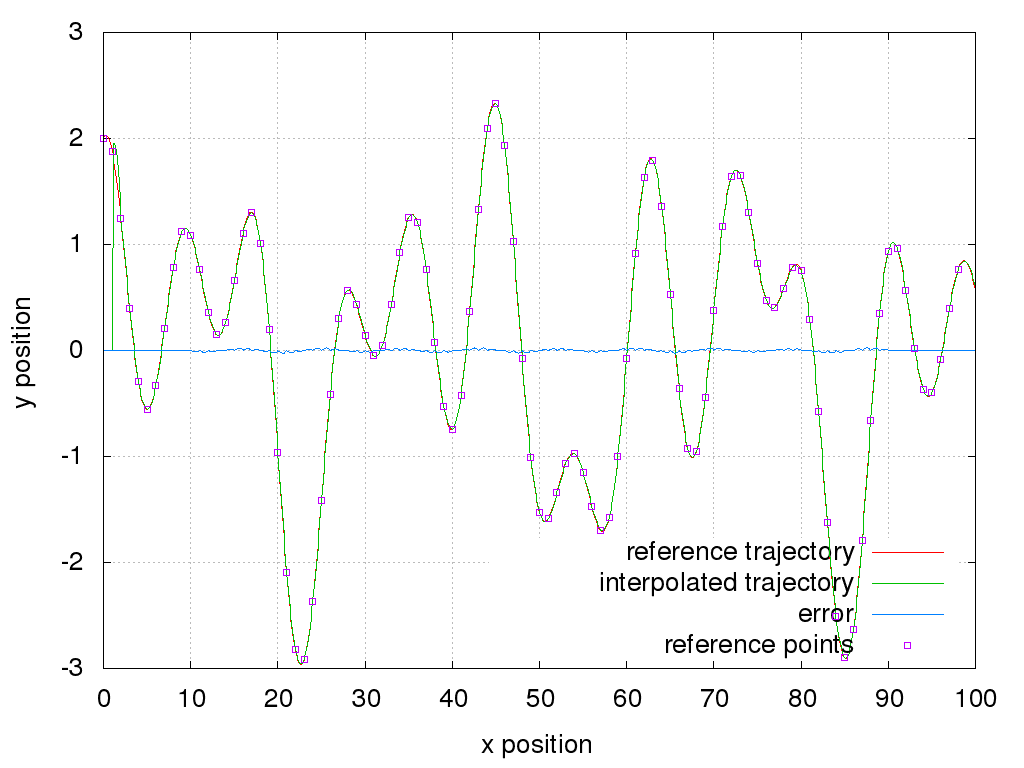
src/tmp/curve (copy)/bin/result.png
