richese/aeris/src/tmp/curve/bin/result.png

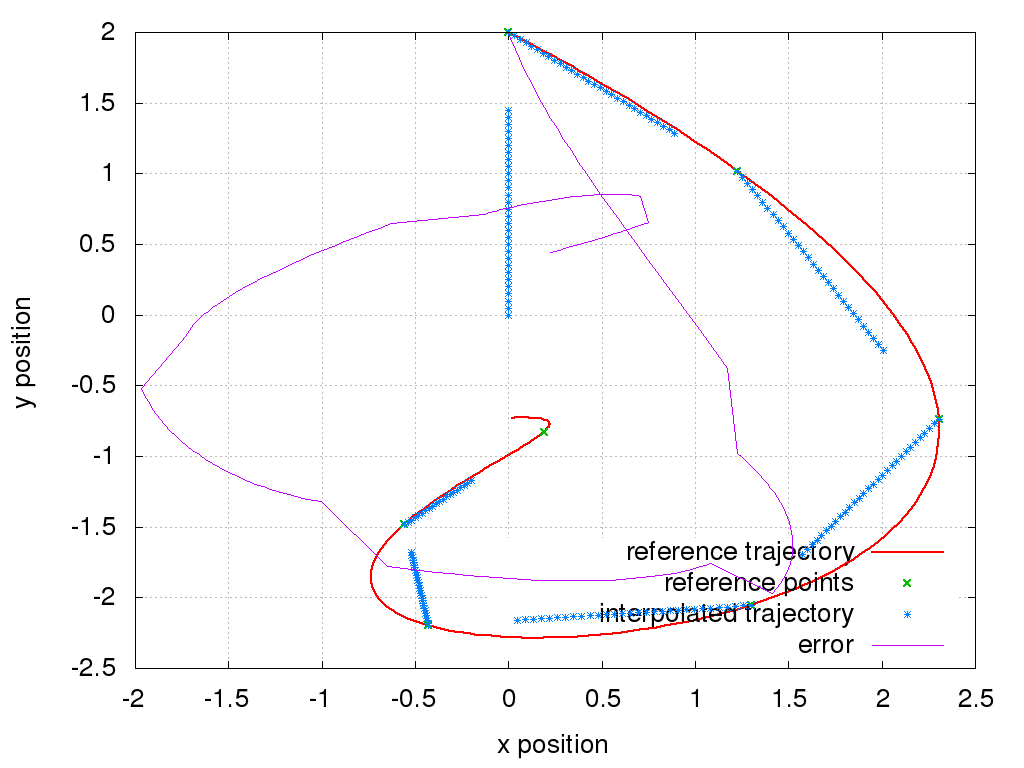
src/tmp/curve/bin/result.png
