richese/aeris/src/tmp/ilc/bin/1st_order_plant/maneuvers_result_controller_output.png

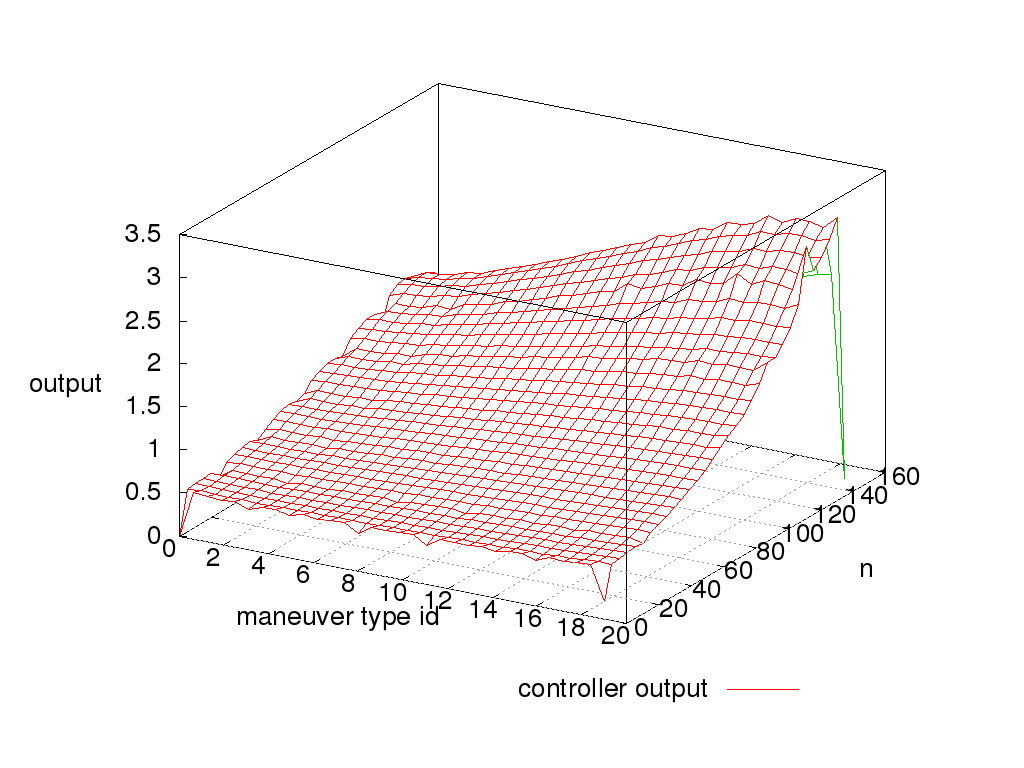
src/tmp/ilc/bin/1st_order_plant/maneuvers_result_controller_output.png
