richese/aeris/src/tmp/ilc/bin/1st_order_plant/maneuvers_result_error.png

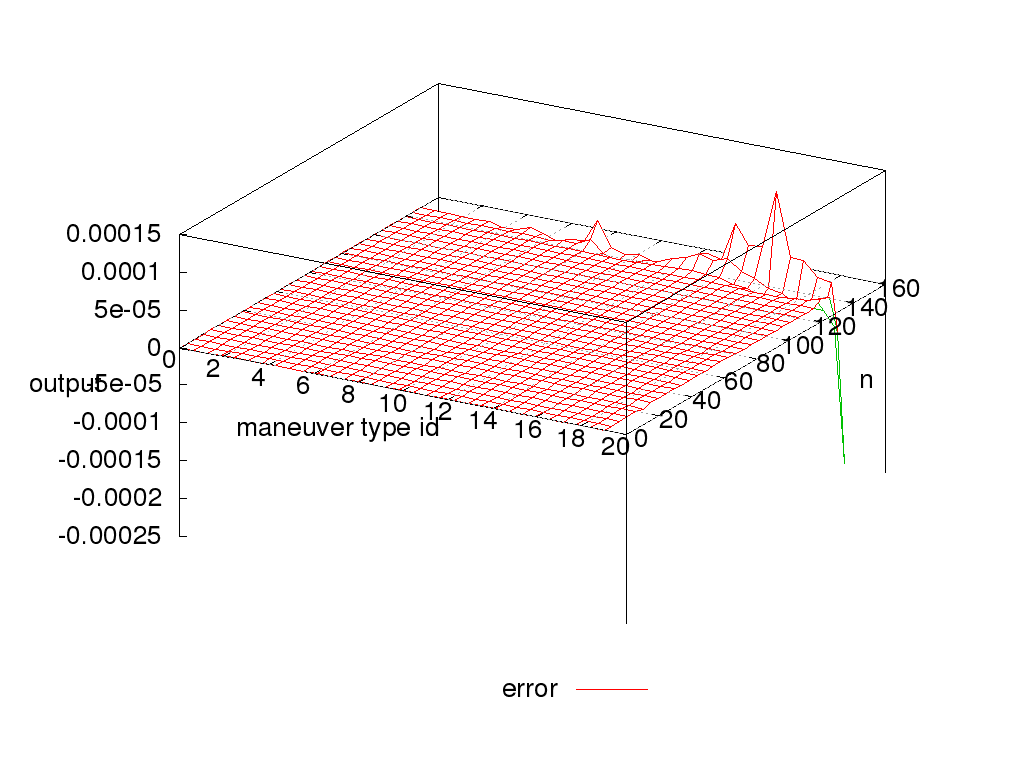
src/tmp/ilc/bin/1st_order_plant/maneuvers_result_error.png
