richese/aeris/src/tmp/ilc/bin/1st_order_plant/maneuvers_result_error_pm3d.png

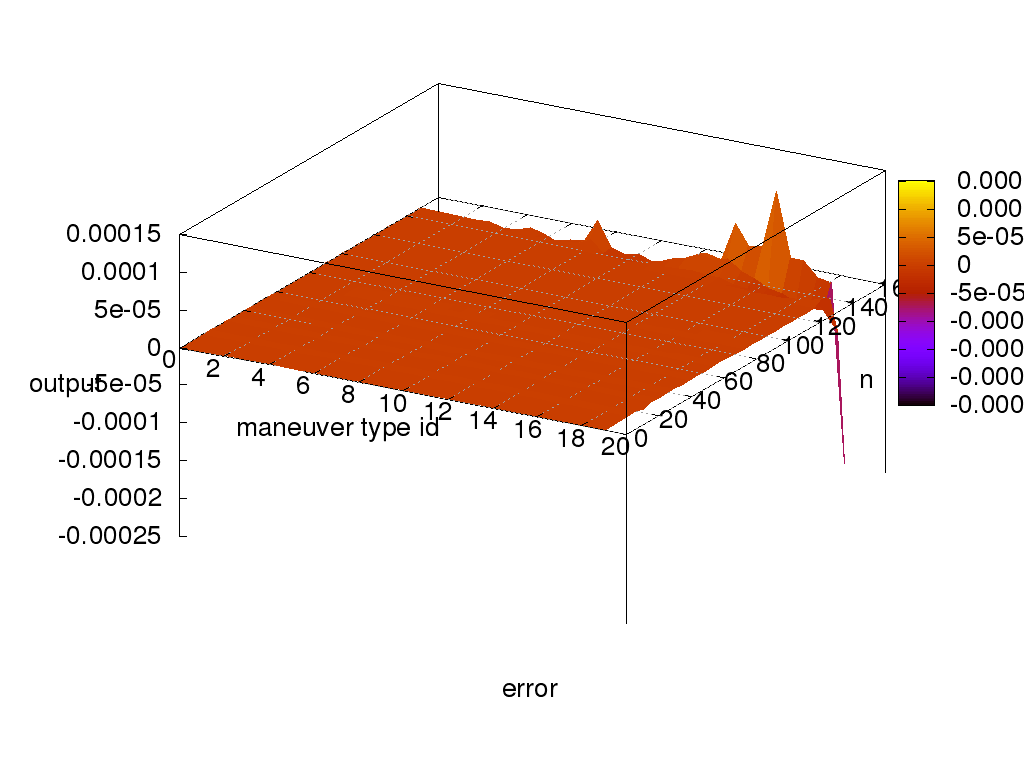
src/tmp/ilc/bin/1st_order_plant/maneuvers_result_error_pm3d.png
