richese/aeris/src/tmp/ilc/bin/2nd_order/result.png

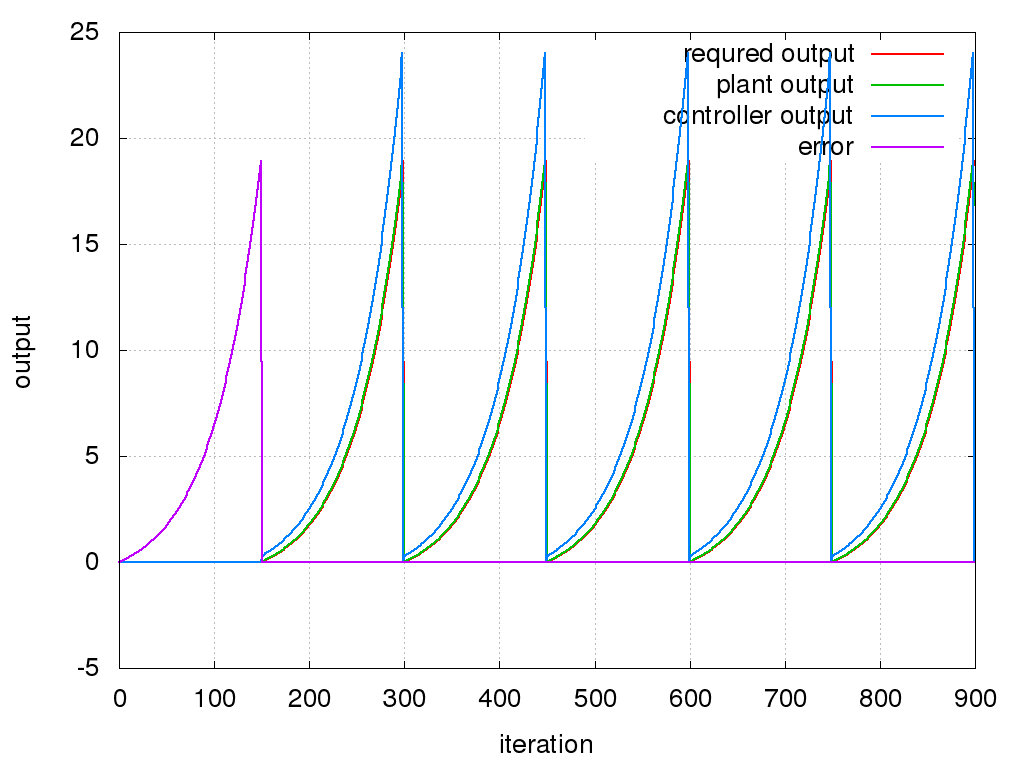
src/tmp/ilc/bin/2nd_order/result.png
