richese/aeris/src/tmp/ilc/bin/3rd_order/maneuvers_result_controller_output.png

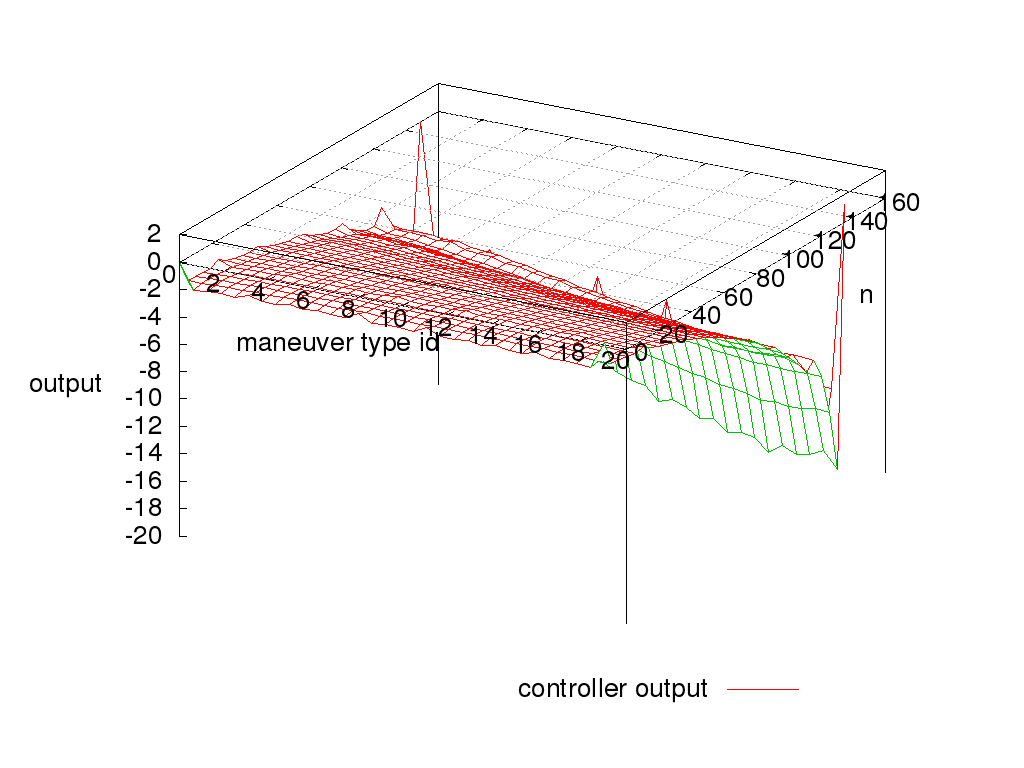
src/tmp/ilc/bin/3rd_order/maneuvers_result_controller_output.png
