richese/aeris/src/tmp/ilc/bin/3rd_order/maneuvers_result_error_pm3d.png

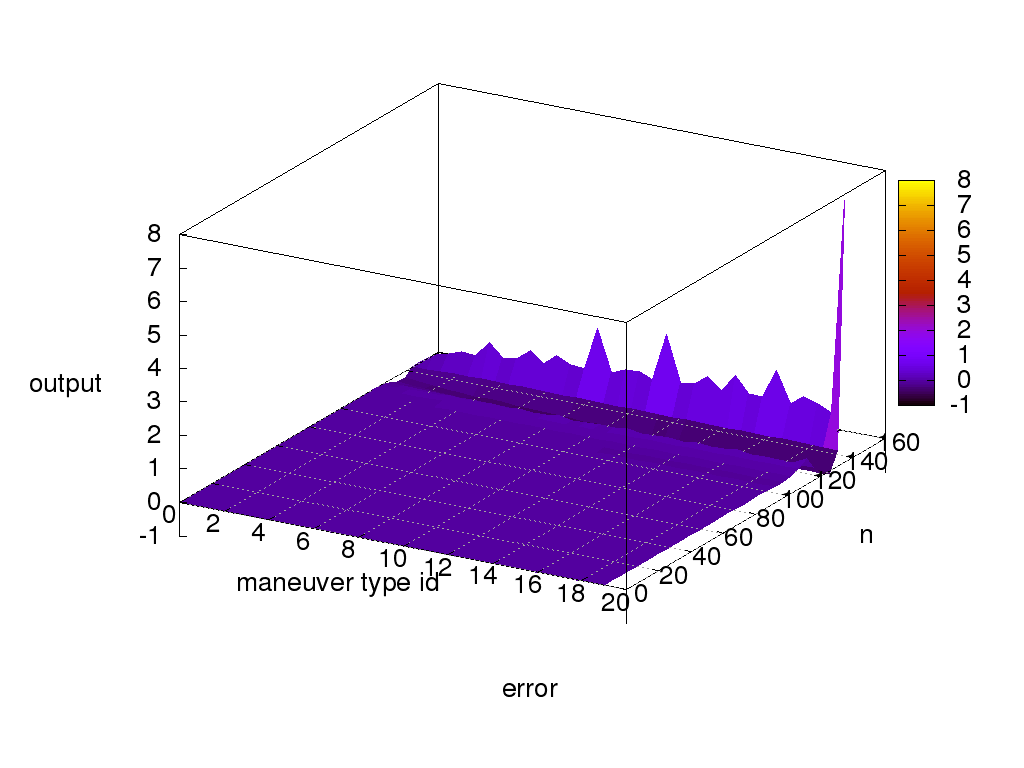
src/tmp/ilc/bin/3rd_order/maneuvers_result_error_pm3d.png
