richese/aeris/src/tmp/ilc/bin/3rd_order/result.png

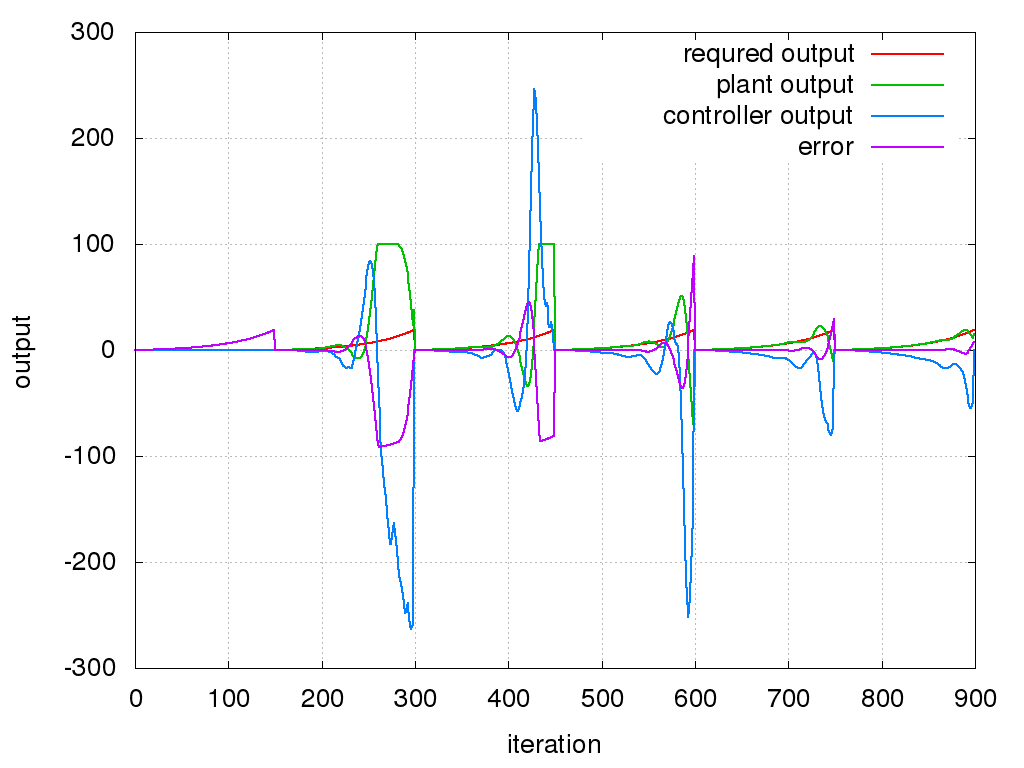
src/tmp/ilc/bin/3rd_order/result.png
