richese/aeris/src/tmp/ilc/bin/maneuvers_result.png

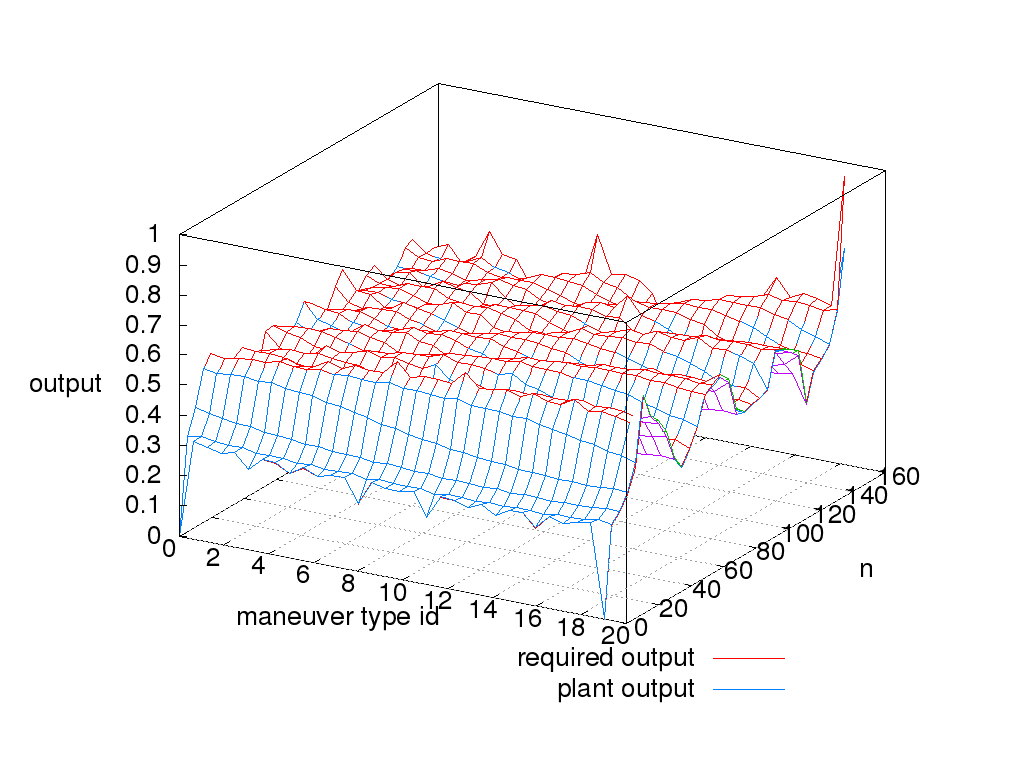
src/tmp/ilc/bin/maneuvers_result.png
