richese/aeris/src/tmp/ilc/bin/maneuvers_result_controller_output.png

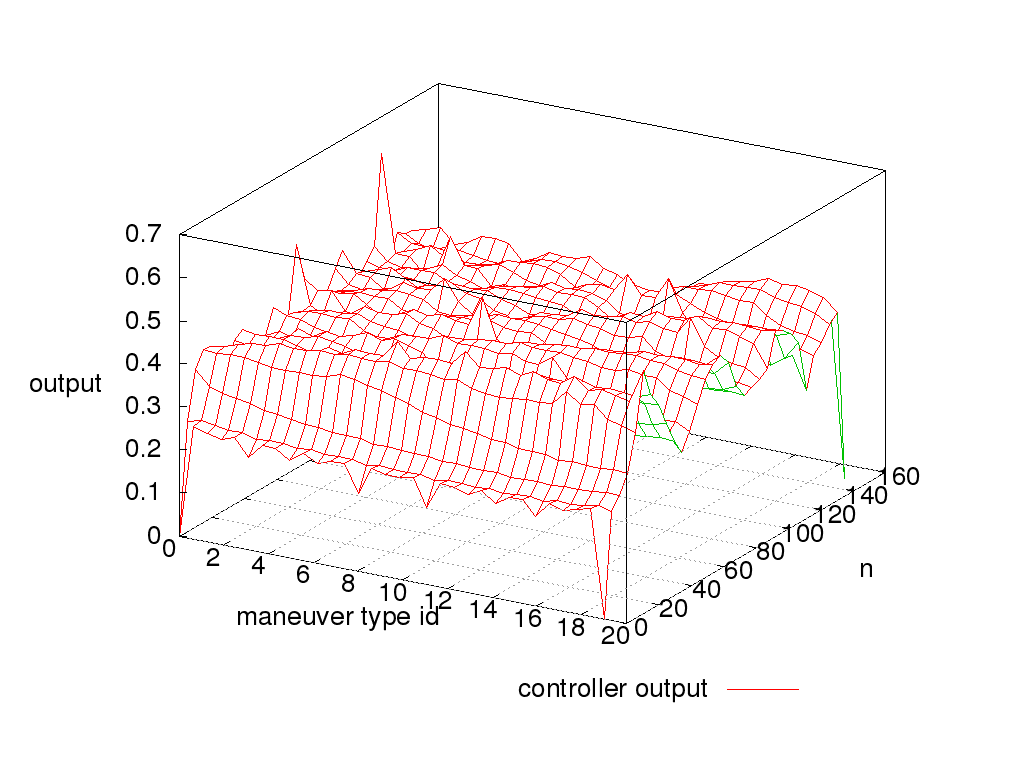
src/tmp/ilc/bin/maneuvers_result_controller_output.png
