richese/aeris/src/tmp/ilc/bin/maneuvers_result_controller_output_pm3d.png

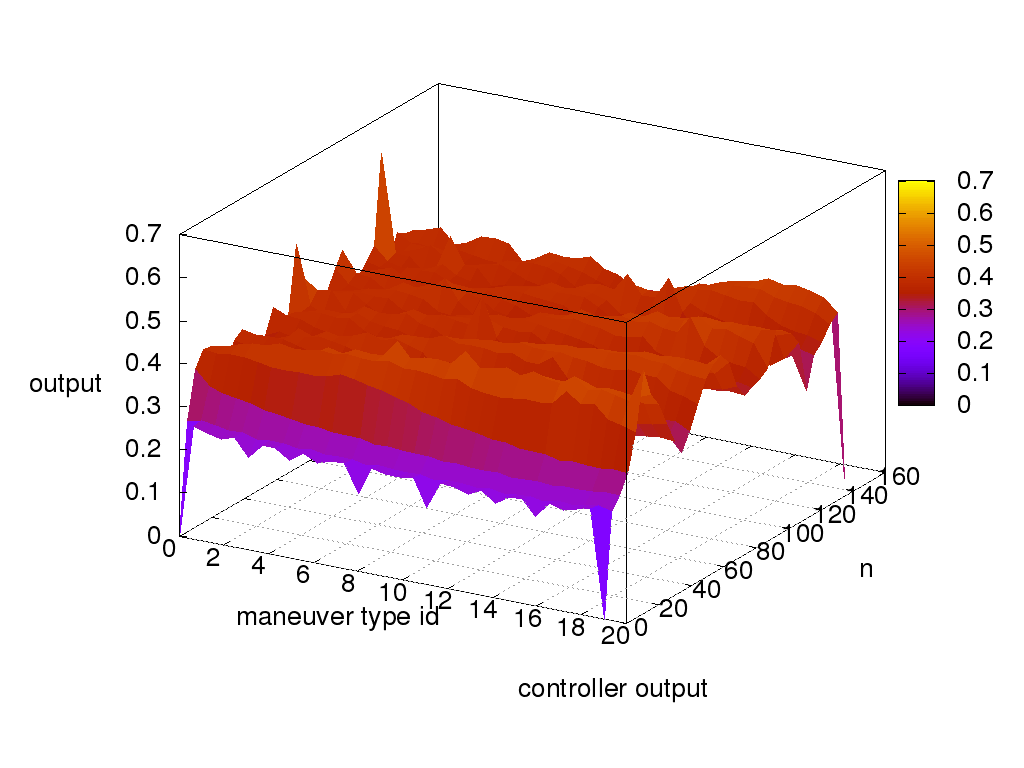
src/tmp/ilc/bin/maneuvers_result_controller_output_pm3d.png
