richese/aeris/src/tmp/ilc/bin/oscilating/maneuvers_result_error.png

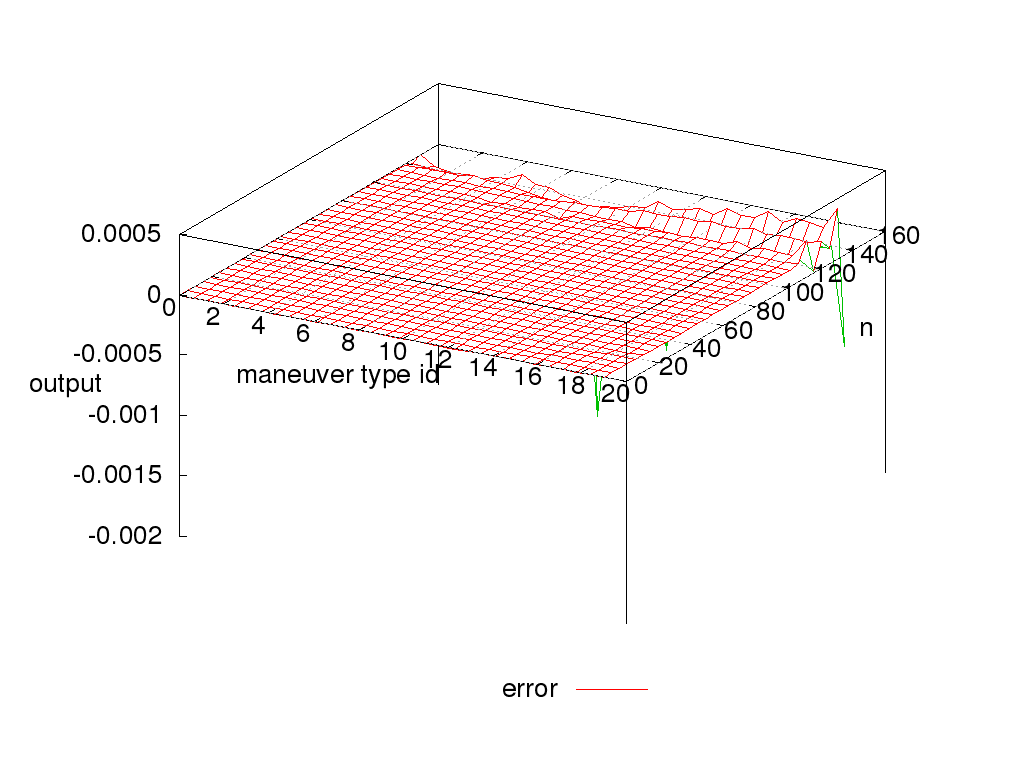
src/tmp/ilc/bin/oscilating/maneuvers_result_error.png
