richese/aeris/src/tmp/ilc/bin/oscilating/maneuvers_result_error_pm3d.png

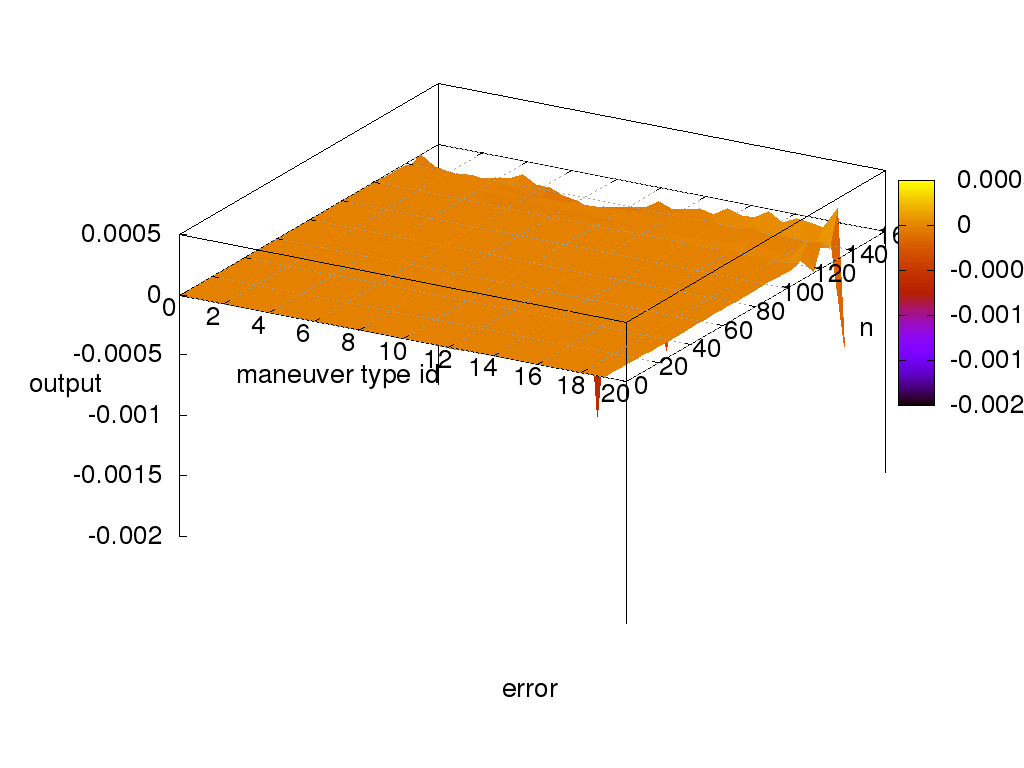
src/tmp/ilc/bin/oscilating/maneuvers_result_error_pm3d.png
