richese/aeris/src/tmp/ilc/bin/oscilating/result.png

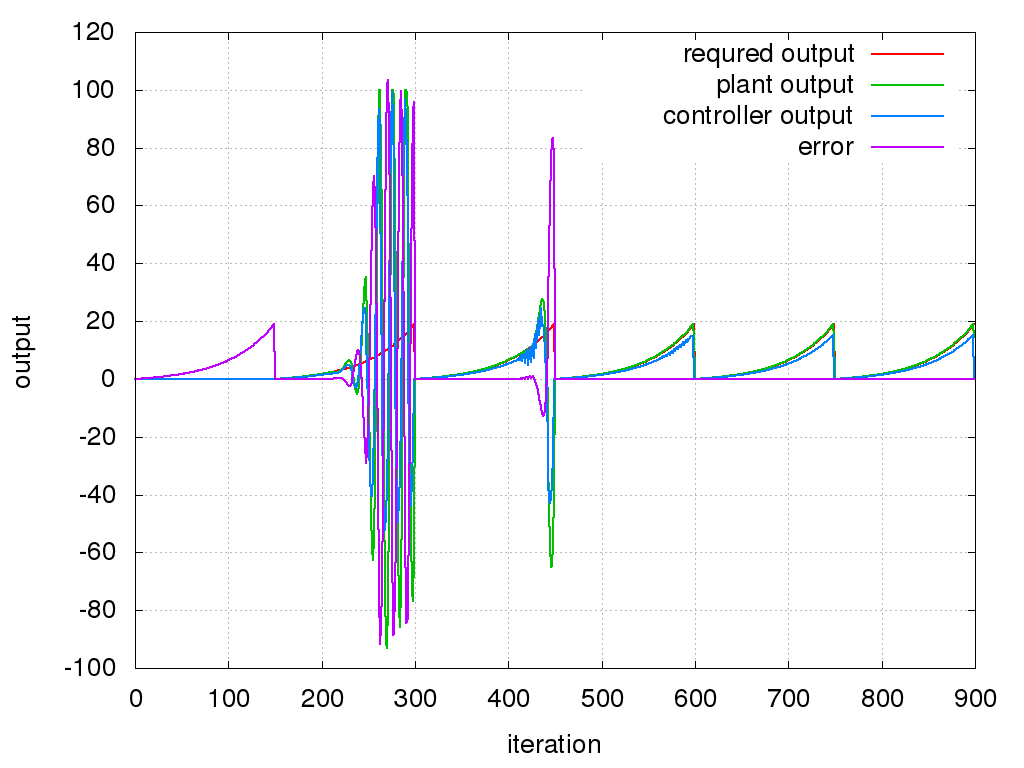
src/tmp/ilc/bin/oscilating/result.png
