richese/aeris/src/tmp/ilc/bin/result.png

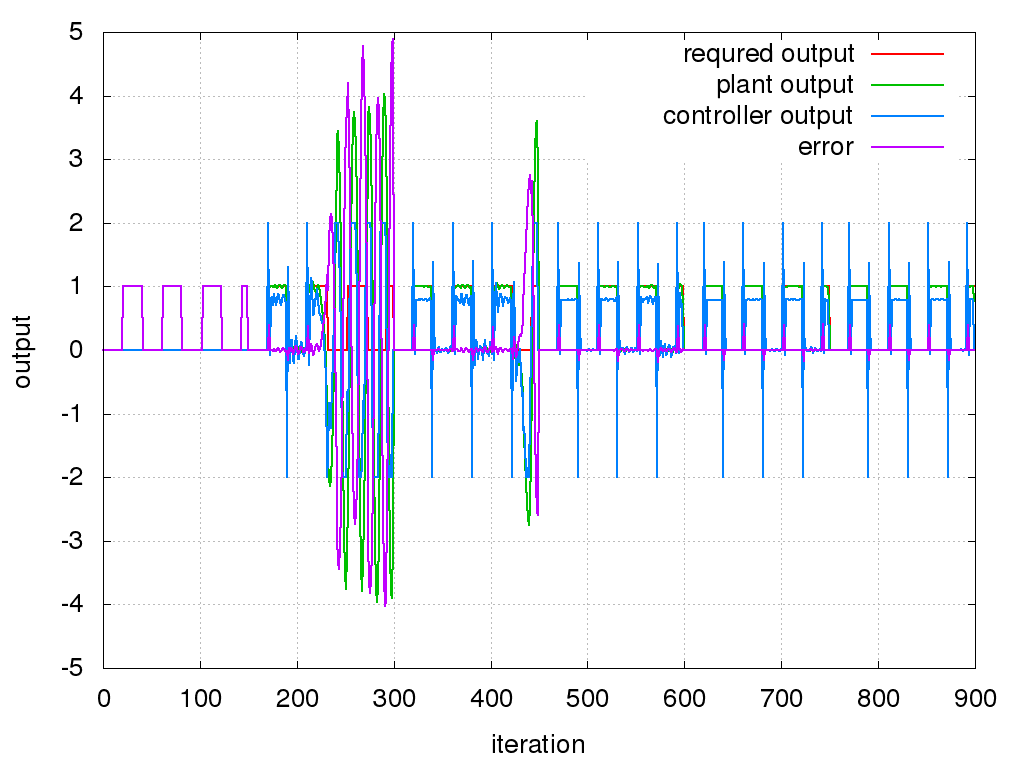
src/tmp/ilc/bin/result.png
