richese/aeris/src/tmp/ilc/bin/servo_plant/maneuvers_result_error.png

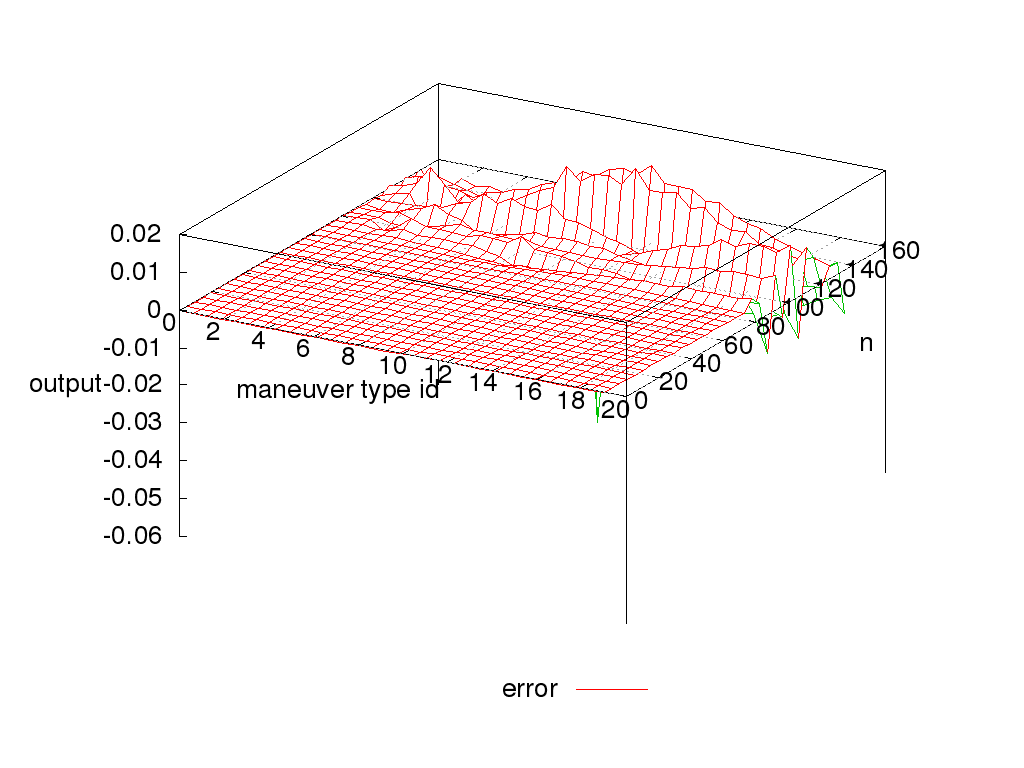
src/tmp/ilc/bin/servo_plant/maneuvers_result_error.png
