richese/aeris/src/tmp/ilc/bin/servo_plant/maneuvers_result_error_pm3d.png

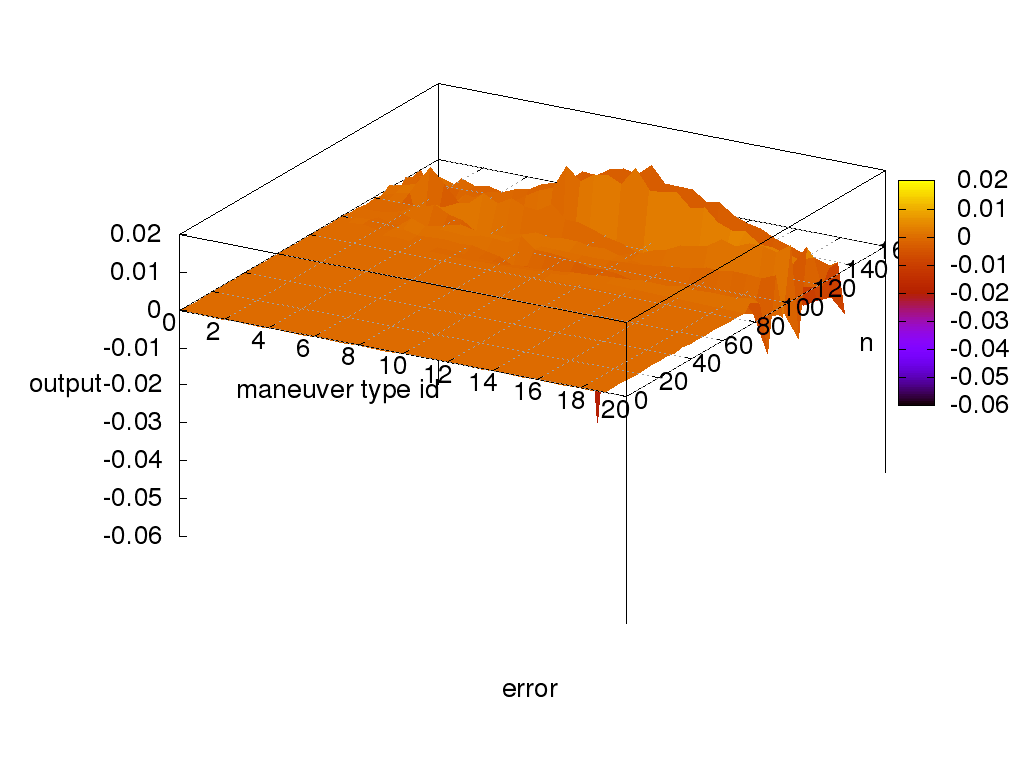
src/tmp/ilc/bin/servo_plant/maneuvers_result_error_pm3d.png
