richese/aeris/src/tmp/ilc/bin/servo_plant/result.png

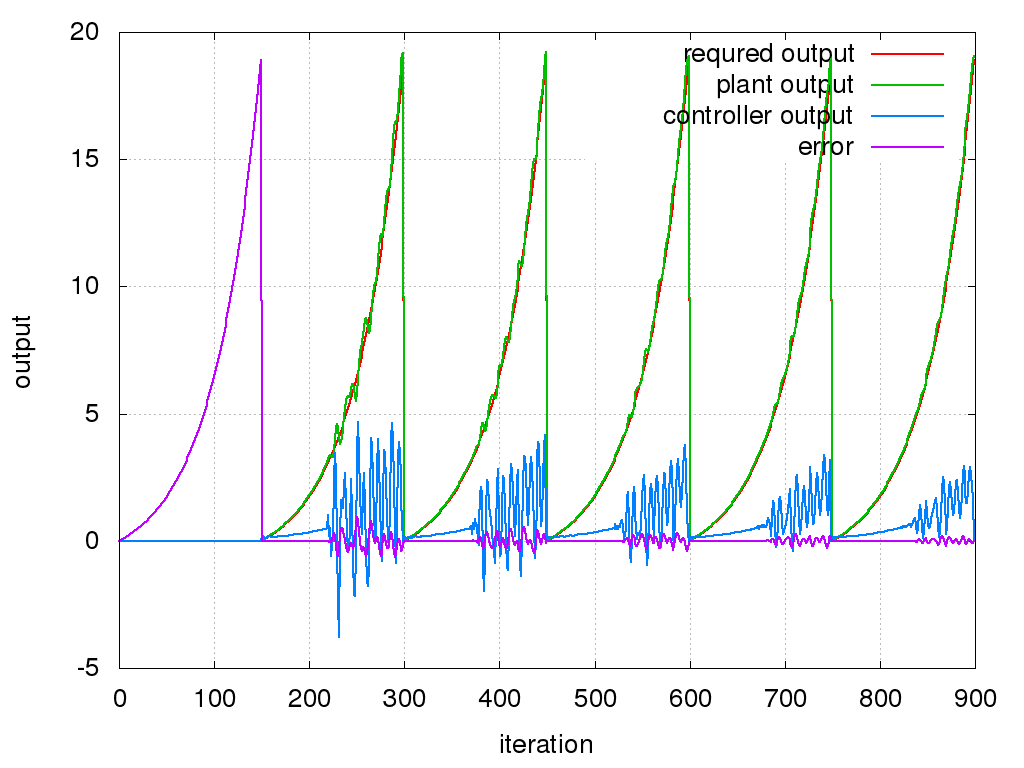
src/tmp/ilc/bin/servo_plant/result.png
