richese/aeris/src (copy)/main (another copy)/robot_visualisation/bin/debug_log.txt

main > 1457016240152.500000 > program done
