richese/aeris/embedded/hardware_current/rev_1.0/main_board/schematic/main_board.pdf

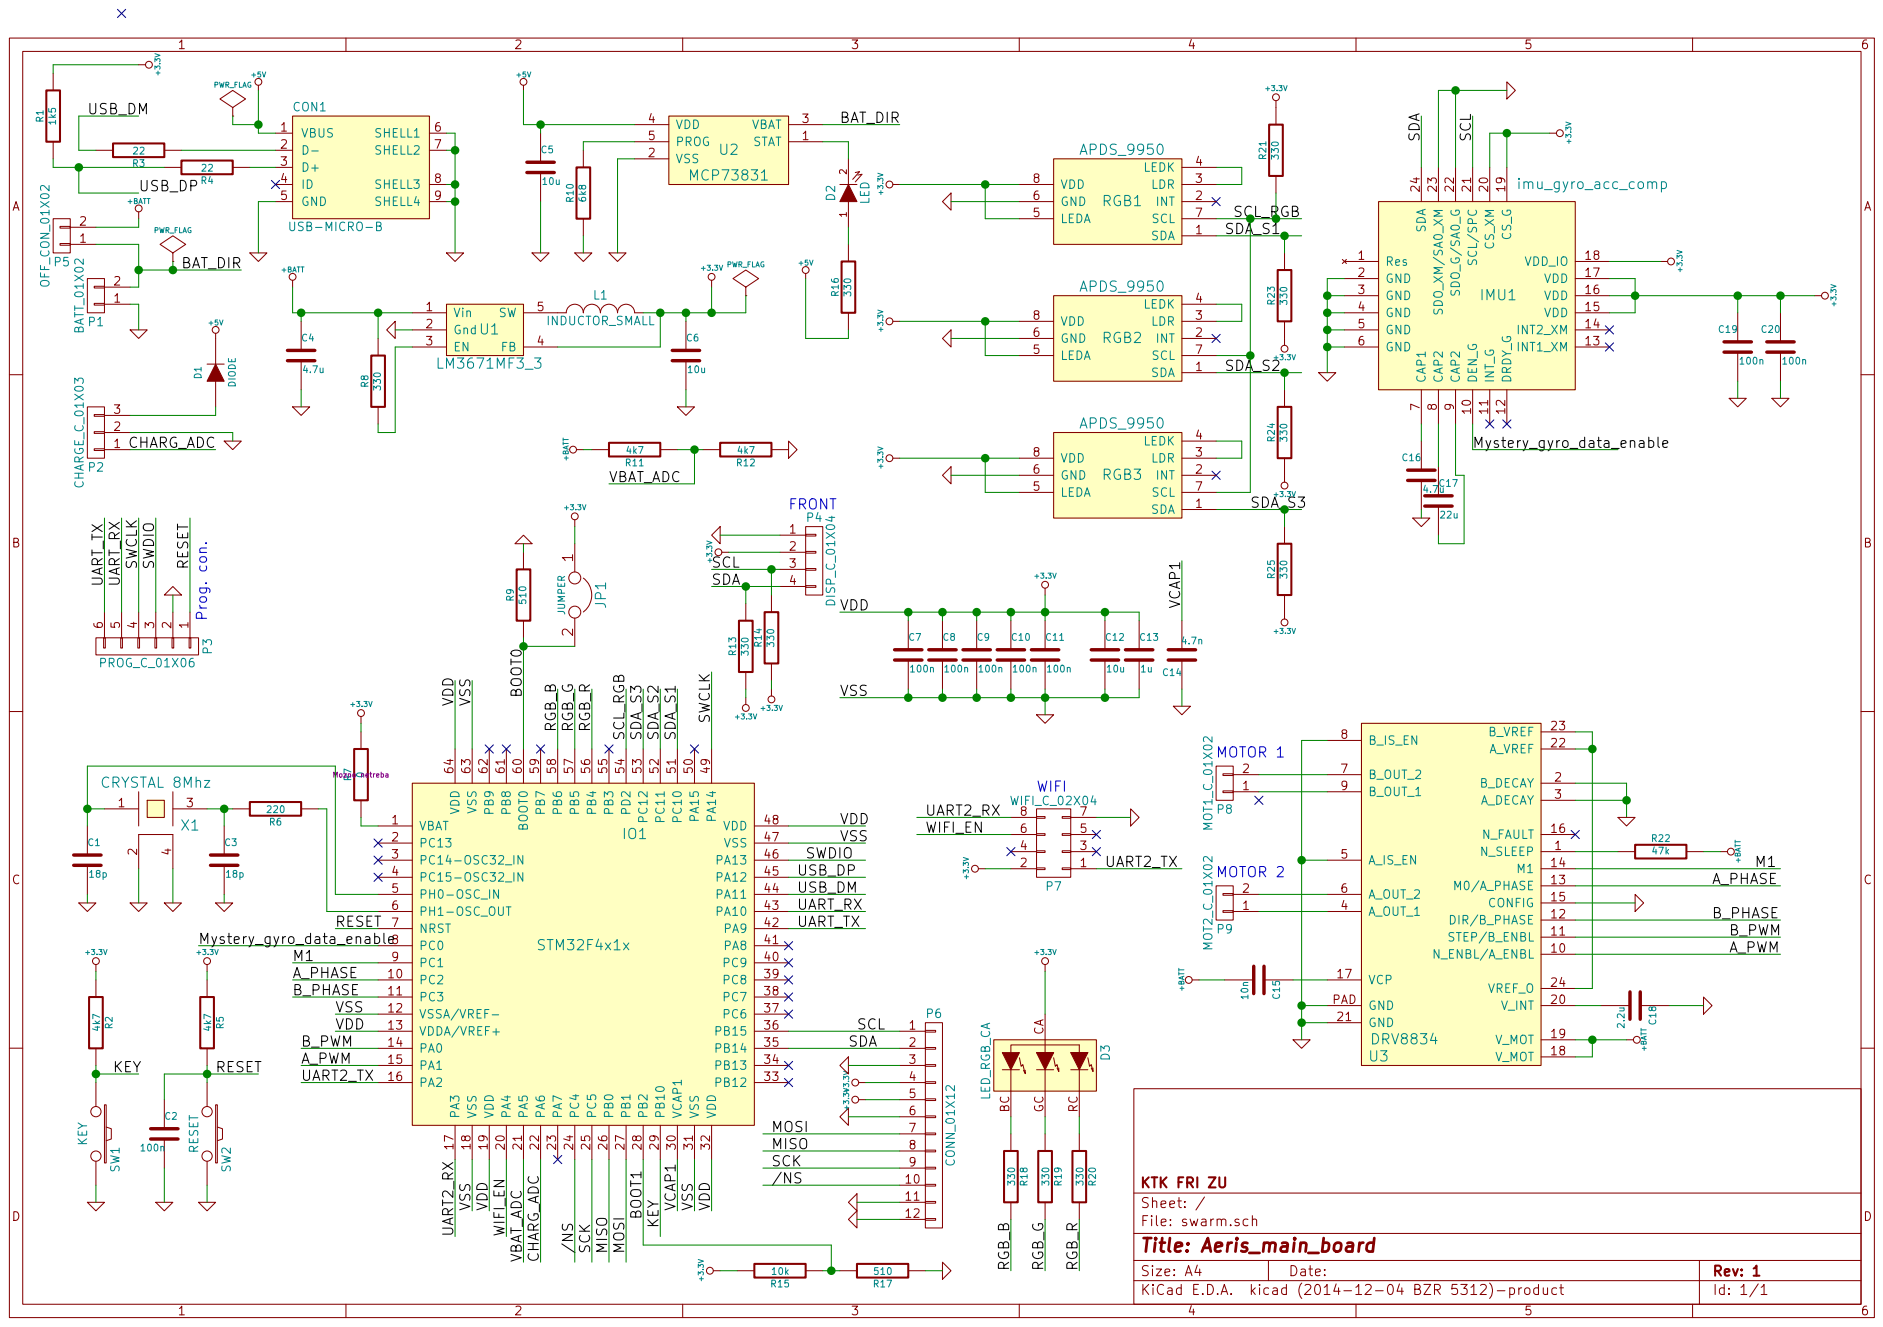
[picture p82: page 1]

4 X1 CRYSTAL 8Mhz Res 1 GND 2 GND 3 GND 4 GND 5 GND 6 CAP1

MOSI /NS SCK MISO MOSI

File: swarm.sch Sheet: / KTK FRI ZU
