richese/aeris/embedded/hardware_current/rev_1.0/sensor_board/schematic/sensor_board.pdf

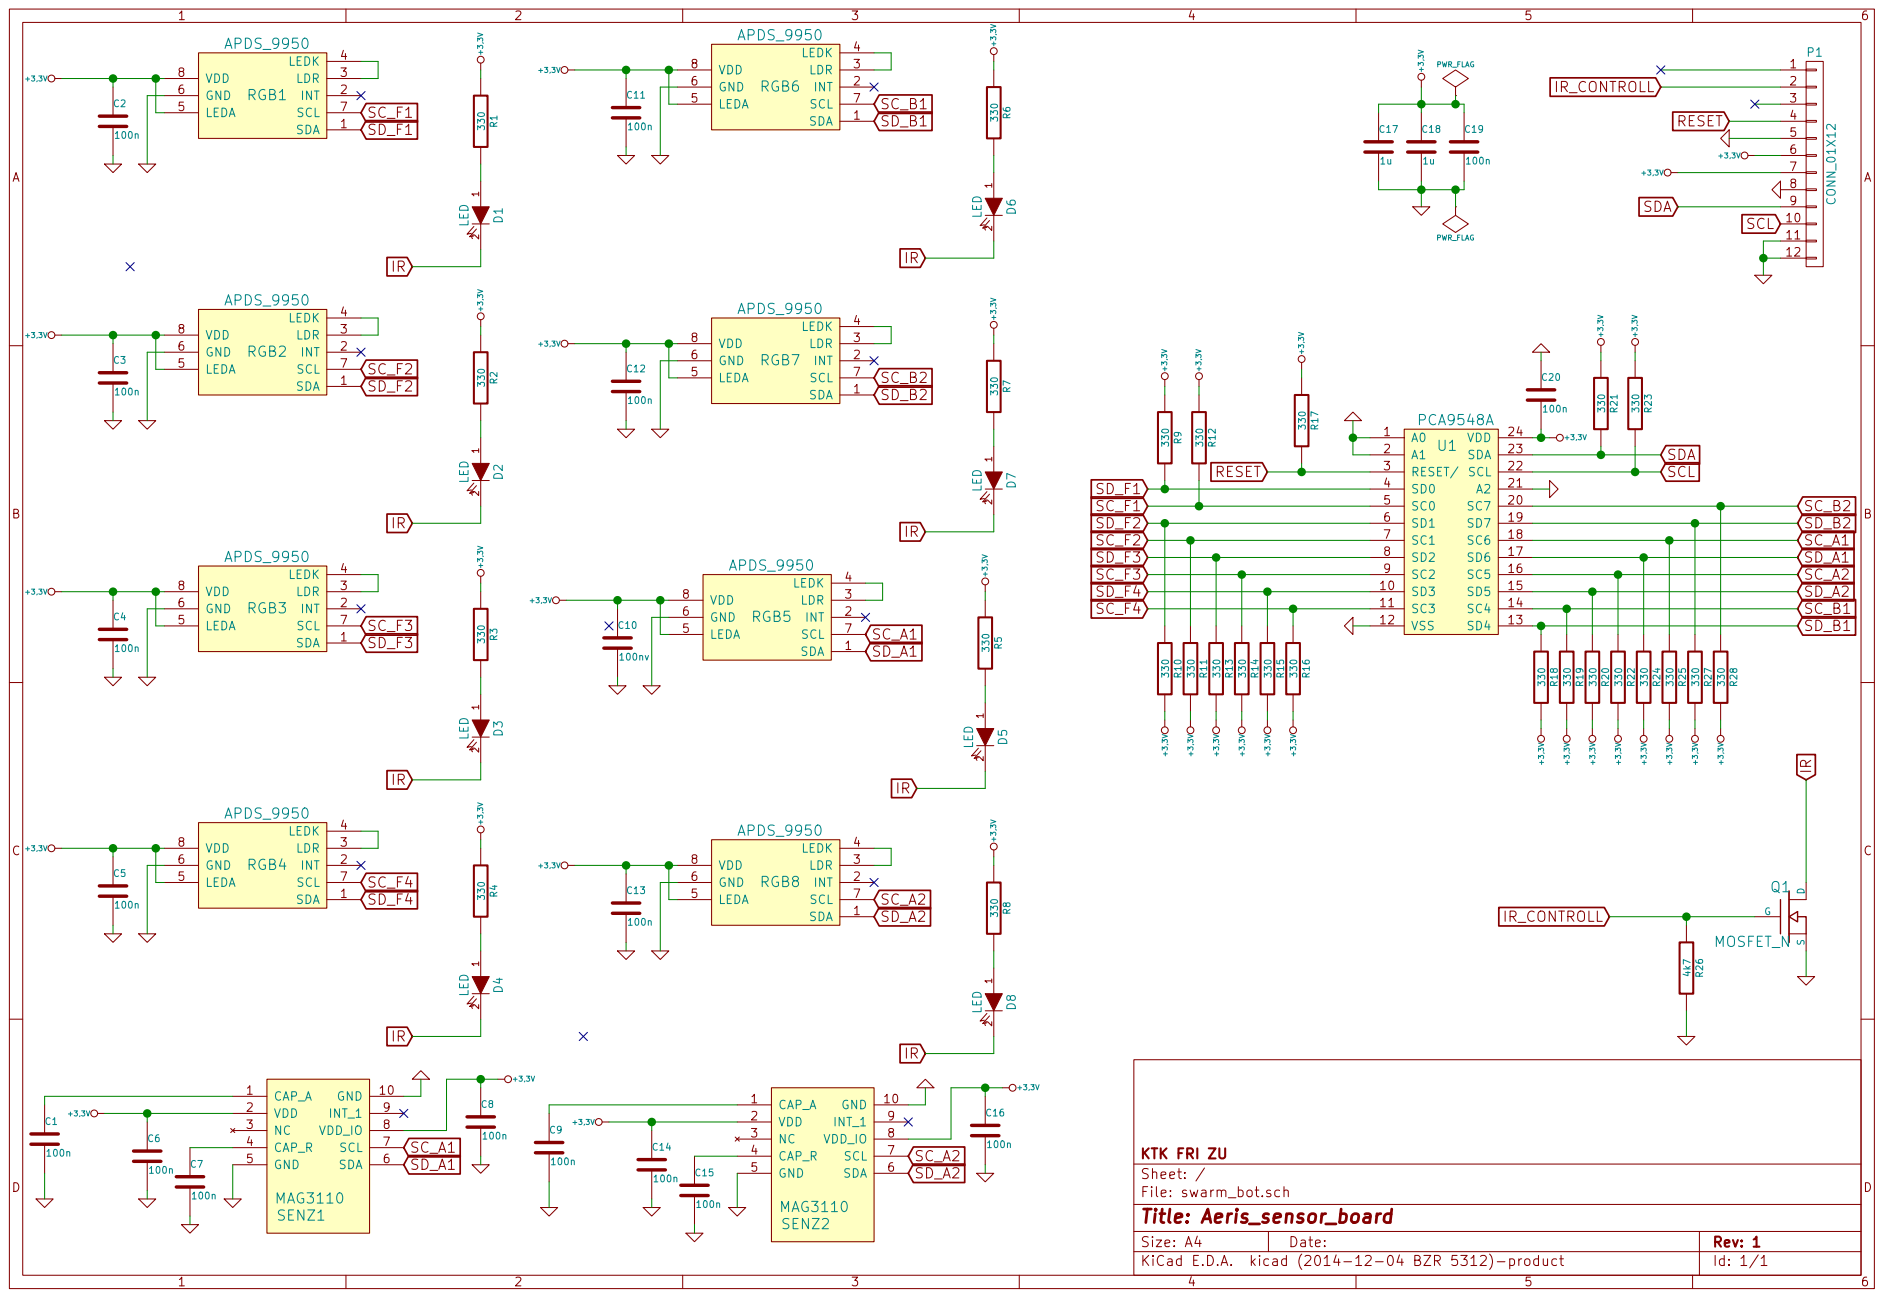
[picture p83: page 1]

File: swarm_bot.sch Sheet: / KTK FRI ZU
