richese/aeris/doc/diagrams/common_lab-eps-converted-to.pdf

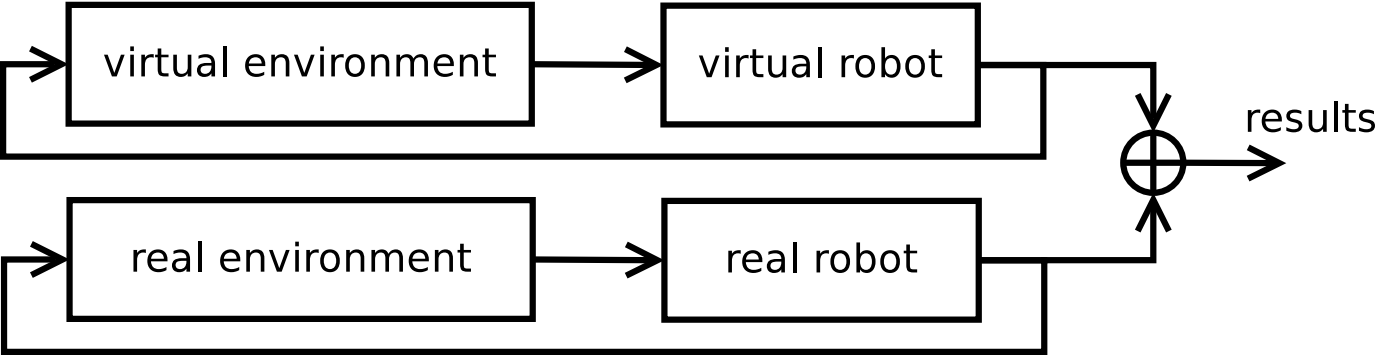
[picture p84: page 1]
