richese/aeris/doc/diagrams/hybrid_lab-eps-converted-to.pdf

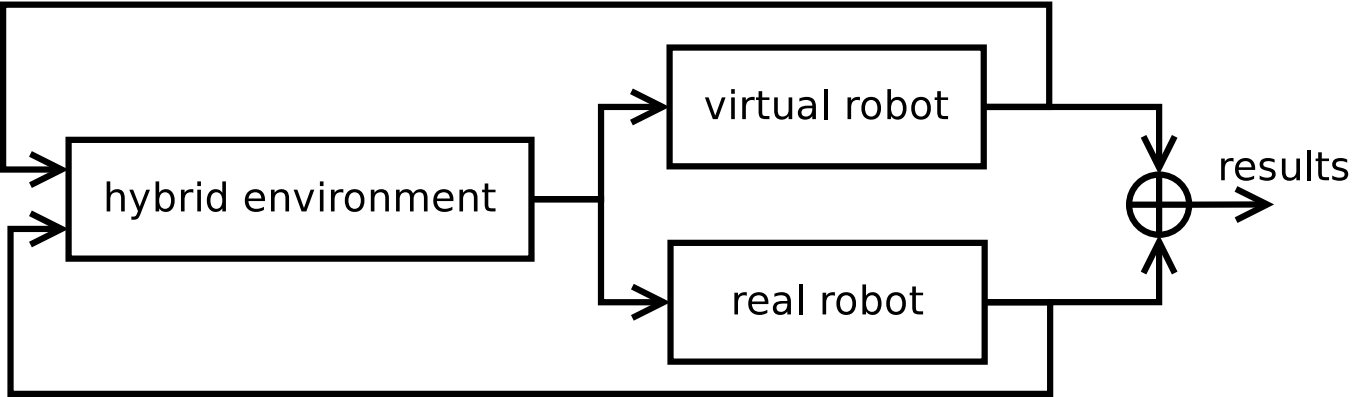
[picture p85: page 1]
