richese/aeris/embedded/hardware_current/rev_1.0/main_board/kicad_source/aeris_main_board.kicad_pcb

## KiCad design embedded/hardware_current/rev_1.0/main_board/kicad_source/aeris_main_board.kicad_pcb (2015-04-29)

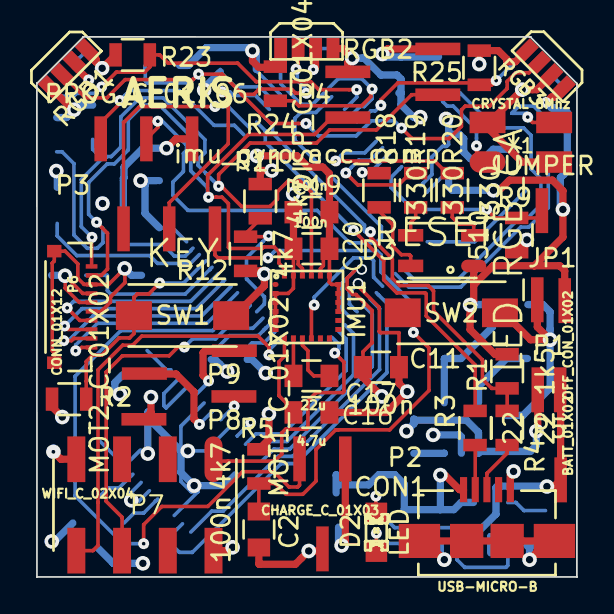
[picture p86: board aeris_main_board.kicad_pcb from above]

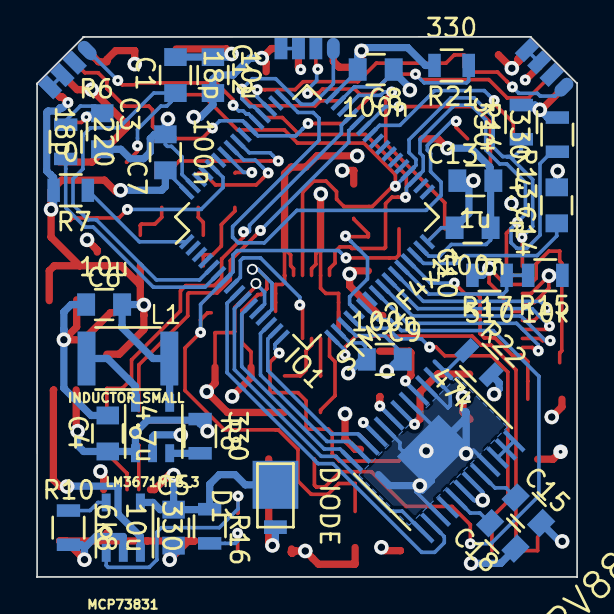
[picture p87: board aeris_main_board.kicad_pcb from below]

Board: 4 copper layers, 30.0 x 30.0 mm, 71 parts (31 on the bottom side), 69 nets.

Parts:
C1, C3: 18p; C_0805
C2, C7, C8, C9, C10, C11, C19, C20: 100n; C_0805
C4, C16: 4.7u; C_0805
C5, C6, C12: 10u; C_0805
C13: 1u; C_0805
C14: 4.7n; C_0805
C15: 10n; C_0805
C17: 22u; C_0805
C18: 2.2u; C_0805
CON1: USB-MICRO-B; Micro_USB_B
D1: DIODE; DO-220
D2: LED; LED-0805
D3: LED_RGB_CA; PLCC-4
IMU1: imu_gyro_acc_comp; LGA_24_max_pads
IO1: STM32F4x1x; LQFP-64_10x10mm_Pitch0.5mm
JP1: JUMPER; Header_2x1way_1_27mm
L1: INDUCTOR_SMALL; C_1812
P1: BATT_01X02; Header_2x1way_1_27mm
P2: CHARGE_C_01X03; Header_3x1way_1_27mm
P3: PROG_C_01X06; Header_6x1way_1_27_mm
P4: DISP_C_01X04; Header_4x1way_1_27_mm
P5: OFF_CON_01X02; Header_2x1way_1_27mm
P6: CONN_01X12; FFC_10way
P7: WIFI_C_02X04; PIN_2x4way_SMD_2_54
P8: MOT1_C_01X02; Header_2x1way_1_27mm
P9: MOT2_C_01X02; Header_2x1way_1_27mm
R1: 1k5; R_0805
R2, R5, R11, R12: 4k7; R_0805
R3, R4: 22; R_0805
R6: 220; R_0805
R7: 0; R_0805
R8, R13, R14, R16, R18, R19, R20, R21, R23, R24, R25: 330; R_0805
R9, R17: 510; R_0805
R10: 6k8; R_0805
R15: 10k; R_0805
R22: 47k; R_0805
RGB1, RGB2, RGB3: APDS_9950; RGB_LED_EDGE
SW1: KEY; DTSM-32S-B
SW2: RESET; DTSM-32S-B
U1: LM3671MF3_3; TSOT-23-5
U2: MCP73831; TSOT-23-5
U3: DRV8834; HTSSOP-24
X1: CRYSTAL 8Mhz; 5x3.2_CRYSTAL

Connections:
+3.3V: C6.1, C7.1, C8.1, C9.1, C10.1, C11.1, C12.1, C13.1, C19.1, C20.1, D3.CA, IMU1.15, IMU1.16, IMU1.17, IMU1.18, IMU1.19, IMU1.20, IO1.13, IO1.19, IO1.32, IO1.48, IO1.64, JP1.1, L1.2, P4.2, P6.4, P6.5, P7.2, R1.2, R2.1, R5.1, R7.2, R13.1, R14.1, R15.2, R21.2, R23.1, R24.1, R25.1, RGB1.5, RGB1.8, RGB2.5, RGB2.8, RGB3.5, RGB3.8, U1.4
+5V: C5.1, CON1.1, D1.2, R16.1, U2.4
+BATT: C4.1, C15.2, P5.2, R8.2, R11.2, R22.2, U1.1, U3.18, U3.19
//NS: IO1.24, P6.10
/A_PHASE: IO1.10, U3.13
/A_PWM: IO1.15, U3.10
/BAT_DIR: P1.2, P5.1, U2.3
/BOOT0: IO1.60, JP1.2, R9.1
/BOOT1: IO1.28, R15.1, R17.2
/B_PHASE: IO1.11, U3.12
/B_PWM: IO1.14, U3.11
/CHARG_ADC: IO1.22, P2.1
/KEY: IO1.29, R2.2, SW1.1
/M1: IO1.9, U3.14
/MISO: IO1.26, P6.8
/MOSI: IO1.27, P6.7
/Mystery_gyro_data_enable: IMU1.10, IO1.8
/RESET: C2.1, IO1.7, P3.1, R5.2, SW2.1
/RGB_B: IO1.58, R18.2
/RGB_G: IO1.57, R19.2
/RGB_R: IO1.56, R20.2
/SCK: IO1.25, P6.9
/SCL: IMU1.21, IO1.36, P4.3, P6.1, R14.2
/SCL_RGB: IO1.54, R21.1, RGB1.7, RGB2.7, RGB3.7
/SDA: IMU1.24, IO1.35, P4.4, P6.2, R13.2
/SDA_S1: IO1.51, R23.2, RGB1.1
/SDA_S2: IO1.52, R24.2, RGB2.1
/SDA_S3: IO1.53, R25.2, RGB3.1
/SWCLK: IO1.49, P3.4
/SWDIO: IO1.46, P3.3
/UART2_RX: IO1.17, P7.8
/UART2_TX: IO1.16, P7.1
/UART_RX: IO1.43, P3.5
/UART_TX: IO1.42, P3.6
/USB_DM: IO1.44, R3.2
/USB_DP: IO1.45, R1.1, R4.2
/VBAT_ADC: IO1.21, R11.1, R12.2
/VCAP1: C14.2, IO1.30
/WIFI_EN: IO1.20, P7.6
GND: C1.2, C2.2, C3.2, C4.2, C5.2, C6.2, C7.2, C8.2, C9.2, C10.2, C11.2, C12.2, C13.2, C14.1, C16.2, C18.1, C19.2, C20.2, CON1.5, CON1.6, CON1.7, CON1.8, CON1.9, IMU1.2, IMU1.3, IMU1.4, IMU1.5, IMU1.6, IMU1.22, IMU1.23, IO1.12, IO1.18, IO1.31, IO1.47, IO1.63, P1.1, P2.2, P3.2, P4.1, P6.3, P6.6, P6.11, P6.12, P7.7, R9.2, R10.1, R12.1, R17.1, RGB1.6, RGB2.6, RGB3.6, SW1.2, SW2.2, U1.2, U2.2, U3.2, U3.3, U3.5, U3.8, U3.15, U3.21, U3.PAD, X1.2, X1.4
unnamed: C1.1, IO1.5, X1.1
unnamed: C3.1, R6.2, X1.3
unnamed: C15.1, U3.17
unnamed: C16.1, IMU1.7
unnamed: C17.1, IMU1.8
unnamed: C17.2, IMU1.9
unnamed: C18.2, U3.20
unnamed: CON1.2, R3.1
unnamed: CON1.3, R4.1
unnamed: D1.1, P2.3
unnamed: D2.1, R16.2
unnamed: D2.2, U2.1
unnamed: D3.BC, R18.1
unnamed: D3.GC, R19.1
unnamed: D3.RC, R20.1
unnamed: IO1.1, R7.1
unnamed: IO1.6, R6.1
unnamed: L1.1, U1.5
unnamed: P8.1, U3.9
unnamed: P8.2, U3.7
unnamed: P9.1, U3.4
unnamed: P9.2, U3.6
unnamed: R8.1, U1.3
unnamed: R10.2, U2.5
unnamed: R22.1, U3.1
unnamed: RGB1.3, RGB1.4
unnamed: RGB2.3, RGB2.4
unnamed: RGB3.3, RGB3.4
unnamed: U3.22, U3.23, U3.24
