richese/aeris/embedded/hardware_current/rev_1.0/sensor_board/kicad_source/aeris_sensor_board.kicad_pcb

## KiCad design embedded/hardware_current/rev_1.0/sensor_board/kicad_source/aeris_sensor_board.kicad_pcb (2015-04-29)

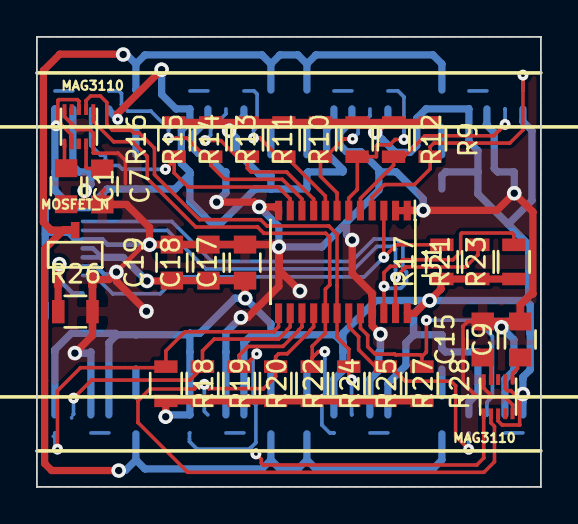
[picture p88: board aeris_sensor_board.kicad_pcb from above]

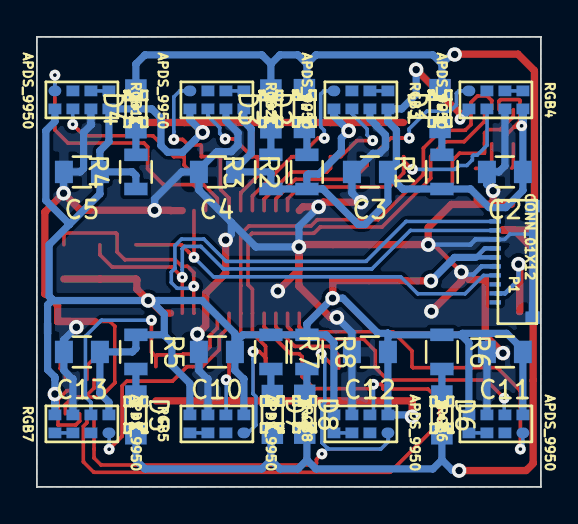
[picture p89: board aeris_sensor_board.kicad_pcb from below]

Board: 2 copper layers, 28.0 x 25.0 mm, 64 parts (33 on the bottom side), 43 nets.

Parts:
C1, C2, C3, C4, C5, C7, C9, C11, C12, C13, C15, C19: 100n; C_0805
C10: 100nv; C_0805
C17, C18: 1u; C_0805
D1, D2, D3, D4, D5, D6, D7, D8: LED; LED-0805
P1: CONN_01X12; FFC_10way
Q1: MOSFET_N; SOT-23
R1, R2, R3, R4, R5, R6, R7, R8, R9, R10, R11, R12, R13, R14, R15, R16, R17, R18, R19, R20, R21, R22, R23, R24, R25, R27, R28: 330; R_0805
R26: 4k7; R_0805
RGB1, RGB2, RGB3, RGB4, RGB5, RGB6, RGB7, RGB8: APDS_9950; RGB_LED
SENZ1, SENZ2: MAG3110; 2154-02
U1: PCA9548A; TSSOP-24_4.4x7.8mm_Pitch0.65mm

Connections:
+3.3V: C2.1, C3.1, C4.1, C5.1, C10.1, C11.1, C12.1, C13.1, C17.1, C18.1, C19.1, P1.6, P1.7, R1.1, R2.1, R3.1, R4.1, R5.1, R6.1, R7.1, R8.1, R9.1, R10.2, R11.2, R12.1, R13.2, R14.2, R15.2, R16.2, R17.1, R18.2, R19.2, R20.2, R21.1, R22.2, R23.1, R24.2, R25.2, R27.2, R28.2, RGB1.5, RGB1.8, RGB2.5, RGB2.8, RGB3.5, RGB3.8, RGB4.5, RGB4.8, RGB5.5, RGB5.8, RGB6.5, RGB6.8, RGB7.5, RGB7.8, RGB8.5, RGB8.8, SENZ1.2, SENZ1.8, SENZ2.2, SENZ2.8, U1.24
GND: C1.2, C2.2, C3.2, C4.2, C5.2, C7.2, C9.2, C10.2, C11.2, C12.2, C13.2, C15.2, C17.2, C18.2, C19.2, P1.5, P1.8, P1.11, P1.12, Q1.S, R26.2, RGB1.6, RGB2.6, RGB3.6, RGB4.6, RGB5.6, RGB6.6, RGB7.6, RGB8.6, SENZ1.5, SENZ1.10, SENZ2.5, SENZ2.10, U1.1, U1.2, U1.12, U1.21
IR: D1.2, D2.2, D3.2, D4.2, D5.2, D6.2, D7.2, D8.2, Q1.D
IR_CONTROLL: P1.2, Q1.G, R26.1
unnamed: C1.1, SENZ1.1
unnamed: C7.1, SENZ1.4
unnamed: C9.1, SENZ2.1
unnamed: C15.1, SENZ2.4
unnamed: D1.1, R1.2
unnamed: D2.1, R2.2
unnamed: D3.1, R3.2
unnamed: D4.1, R4.2
unnamed: D5.1, R5.2
unnamed: D6.1, R6.2
unnamed: D7.1, R7.2
unnamed: D8.1, R8.2
unnamed: RGB1.3, RGB1.4
unnamed: RGB2.3, RGB2.4
unnamed: RGB3.3, RGB3.4
unnamed: RGB4.3, RGB4.4
unnamed: RGB5.3, RGB5.4
unnamed: RGB6.3, RGB6.4
unnamed: RGB7.3, RGB7.4
unnamed: RGB8.3, RGB8.4
RESET: P1.4, R17.2, U1.3
SCL: P1.10, R23.2, U1.22
SC_A1: R25.1, RGB5.7, SENZ1.7, U1.18
SC_A2: R22.1, RGB8.7, SENZ2.7, U1.16
SC_B1: R19.1, RGB6.7, U1.14
SC_B2: R28.1, RGB7.7, U1.20
SC_F1: R12.2, RGB1.7, U1.5
SC_F2: R11.1, RGB2.7, U1.7
SC_F3: R14.1, RGB3.7, U1.9
SC_F4: R16.1, RGB4.7, U1.11
SDA: P1.9, R21.2, U1.23
SD_A1: R24.1, RGB5.1, SENZ1.6, U1.17
SD_A2: R20.1, RGB8.1, SENZ2.6, U1.15
SD_B1: R18.1, RGB6.1, U1.13
SD_B2: R27.1, RGB7.1, U1.19
SD_F1: R9.2, RGB1.1, U1.4
SD_F2: R10.1, RGB2.1, U1.6
SD_F3: R13.1, RGB3.1, U1.8
SD_F4: R15.1, RGB4.1, U1.10
