richese/aeris/embedded/micro_bot/main/main.brd

## EAGLE design embedded/micro_bot/main/main.brd (2016-04-06)

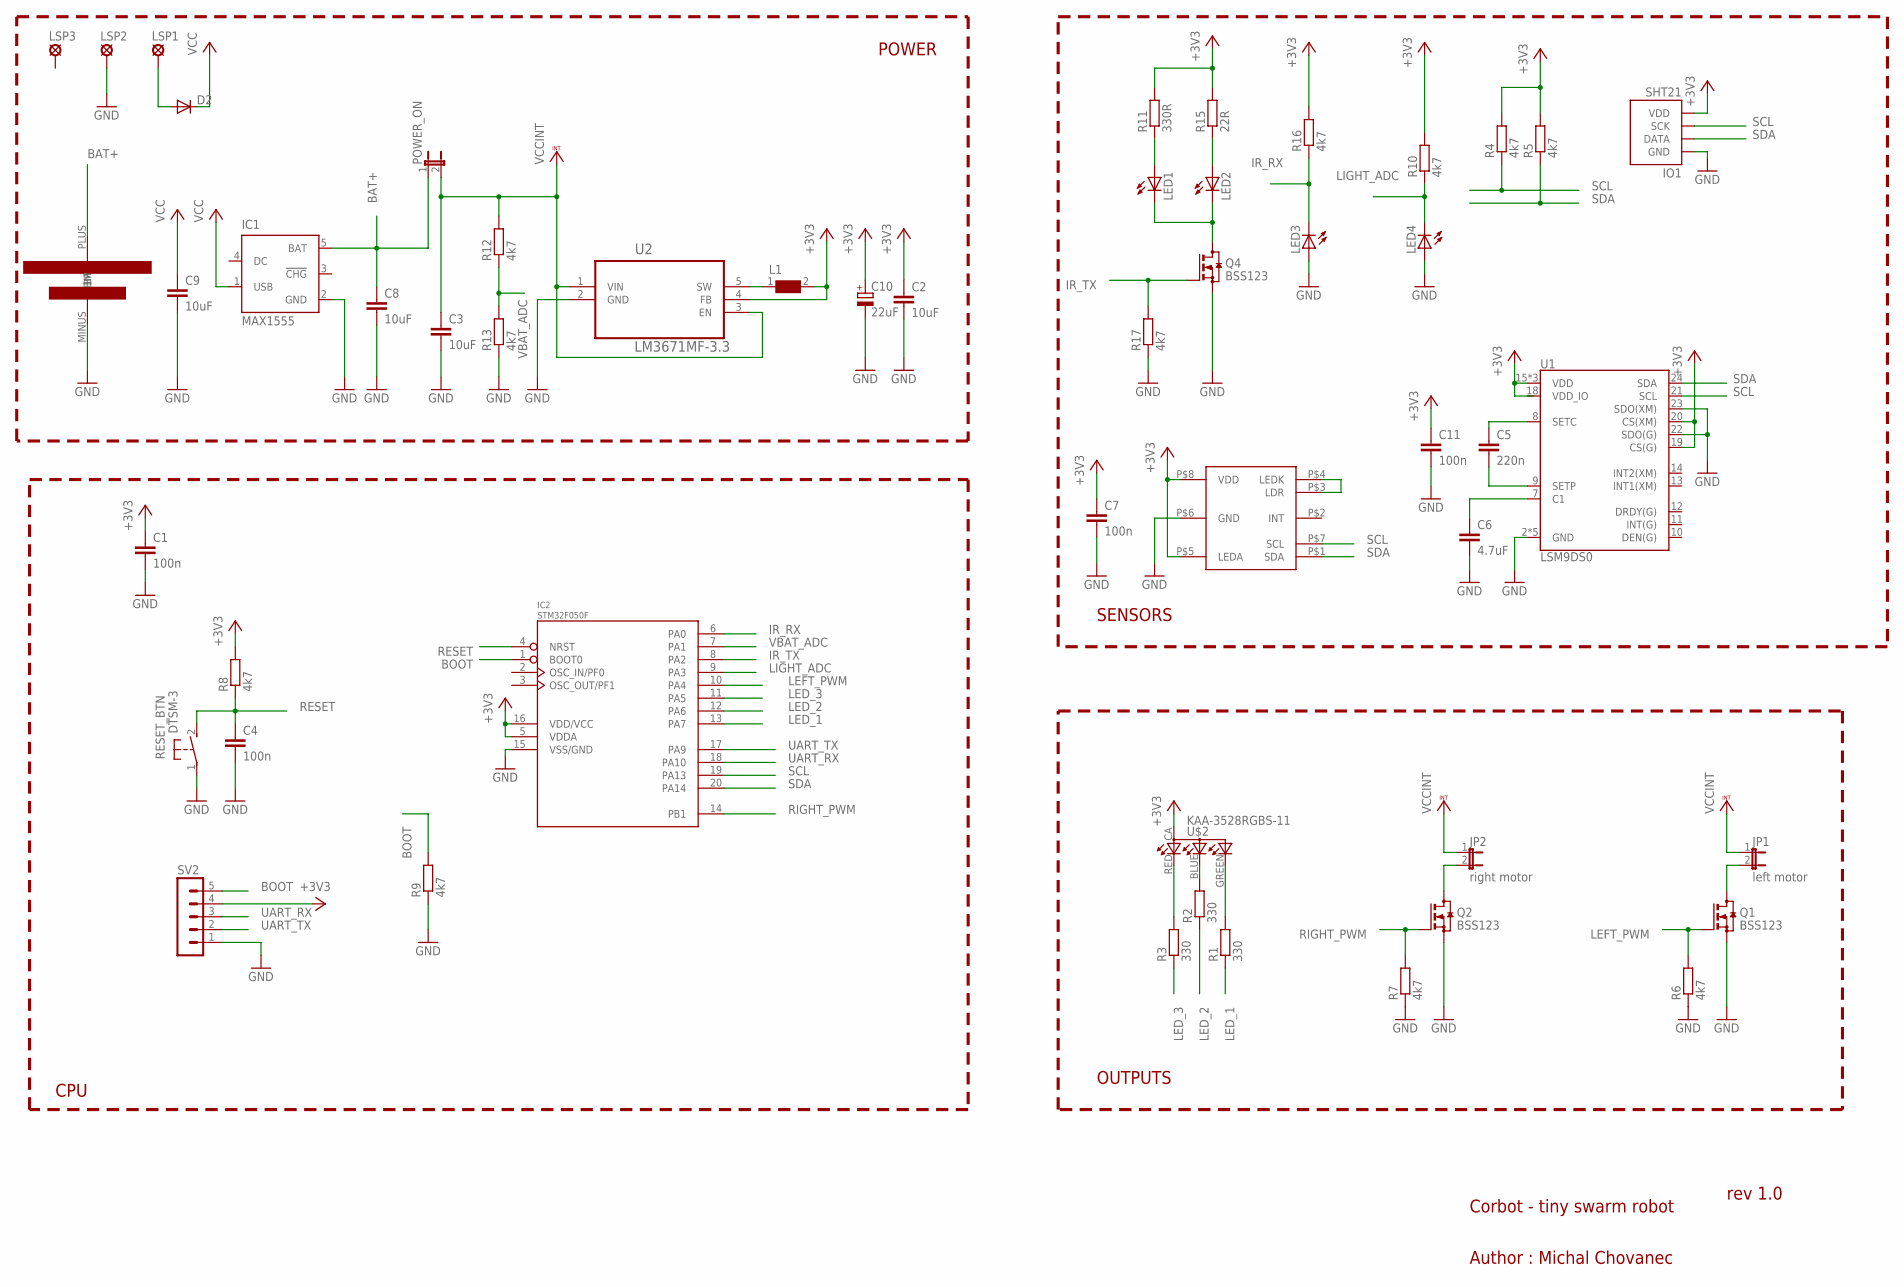
[picture p90: schematic main.sch]

Parts:
C1, C4, C7, C11: 100n; C0805
C2, C3, C8, C9: 10uF; C0805
C5: 220n; C0805
C6: 4.7uF; C0805
C10: 22uF; 153CLV-0505
D2: DIODE-DO-214AC; DO-214AC
IC1: MAX1555; SOT23-5L
IC2: STM32F050F; TSSOP20
IO1: SHT21; SHT2X
JP1: left motor; JP1
JP2: right motor; JP1
L1: WE-LQ-744032002_M; WE-LQ_M
LED1, LED2, LED3, LED4: LEDCHIPLED_1206; CHIPLED_1206
LSP1, LSP2, LSP3: LSP13
POWER_ON: JP1E; JP1
Q1, Q2, Q4: BSS123; SOT23
R1, R2, R3: 330; M0805
R4, R5, R6, R7, R8, R9, R10, R12, R13, R16, R17: 4k7; M0805
R11: 330R; M0805
R15: 22R; M0805
RESET_BTN: DTSM-3
SV2: MA05-1
U1: LSM9DS0; LGA-24
U2: LM3671MF-3.3; SOT95P284X122-5N
U$1: SMTU_2450N
U$2: KAA-3528RGBS-11; LED-RGB
U$3: APDS9950

Connections:
+3V3: C1.1, C2.1, C7.1, C10.+, C11.1, IC2.5 (VDDA), IC2.16 (VDD/VCC), IO1.5 (VDD), L1.2, R4.2, R5.2, R8.2, R10.2, R11.2, R15.2, R16.2, SV2.4, U1.15 (VDD), U1.16 (VDD), U1.17 (VDD), U1.19 (CS(G)), U1.20 (CS(XM)), U2.4 (FB), U$2.CA (A), U$3.P$5 (LEDA), U$3.P$8 (VDD)
BAT+: C8.1, IC1.5 (BAT), POWER_ON.1, U$1.PLUS (BP)
BOOT: IC2.1 (BOOT0), R9.2, SV2.5
GND: C1.2, C2.2, C3.2, C4.2, C6.2, C7.2, C8.2, C9.2, C10.-, C11.2, IC1.2 (GND), IC2.15 (VSS/GND), IO1.2 (GND), LED3.A, LED4.A, LSP2.MP, Q1.2 (S), Q2.2 (S), Q4.2 (S), R6.1, R7.1, R9.1, R13.1, R17.1, RESET_BTN.1, SV2.1, U1.2 (GND), U1.3 (GND), U1.4 (GND), U1.5 (GND), U1.6 (GND), U1.22 (SDO(G)), U1.23 (SDO(XM)), U2.2 (GND), U$1.MINUS (BM), U$3.P$6 (GND)
IR_RX: IC2.6 (PA0), LED3.C, R16.1
IR_TX: IC2.8 (PA2), Q4.1 (G), R17.2
LED_1: IC2.13 (PA7), R1.1
LED_2: IC2.12 (PA6), R2.1
LED_3: IC2.11 (PA5), R3.1
LEFT_PWM: IC2.10 (PA4), Q1.1 (G), R6.2
LIGHT_ADC: IC2.9 (PA3), LED4.C, R10.1
unnamed: R3.2, U$2.RED (CRED)
unnamed: R2.2, U$2.BLUE (CBLUE)
unnamed: R1.2, U$2.GREEN (CGREEN)
unnamed: U$3.P$3 (LDR), U$3.P$4 (LEDK)
unnamed: C6.1, U1.7 (C1)
unnamed: LED1.C, LED2.C, Q4.3 (D)
unnamed: L1.1, U2.5 (SW)
unnamed: C5.1, U1.8 (SETC)
unnamed: D2.A, LSP1.MP
unnamed: LED2.A, R15.1
unnamed: C5.2, U1.9 (SETP)
unnamed: JP1.2, Q1.3 (D)
unnamed: JP2.2, Q2.3 (D)
unnamed: LED1.A, R11.1
RESET: C4.1, IC2.4 (NRST), R8.1, RESET_BTN.2
RIGHT_PWM: IC2.14 (PB1), Q2.1 (G), R7.2
SCL: IC2.19 (PA13), IO1.4 (SCK), R4.1, U1.21 (SCL), U$3.P$7 (SCL)
SDA: IC2.20 (PA14), IO1.1 (DATA), R5.1, U1.24 (SDA), U$3.P$1 (SDA)
UART_RX: IC2.18 (PA10), SV2.3
UART_TX: IC2.17 (PA9), SV2.2
VBAT_ADC: IC2.7 (PA1), R12.1, R13.2
VCC: C9.1, D2.C, IC1.1 (USB)
VCCINT: C3.1, JP1.1, JP2.1, POWER_ON.2, R12.2, U2.1 (VIN), U2.3 (EN)

Notes on the sheet:
CPU
POWER
SENSORS
OUTPUTS
Corbot - tiny swarm robot
rev 1.0
Author : Michal Chovanec

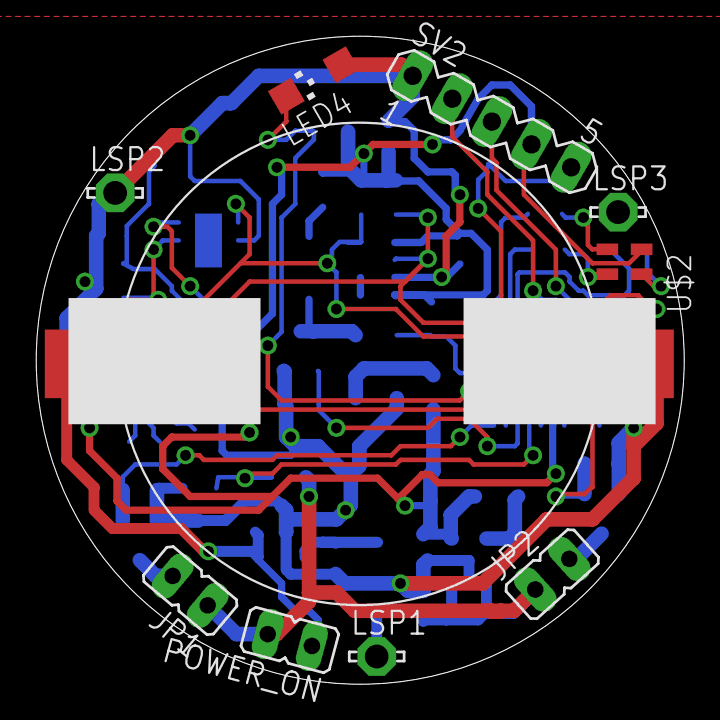
[picture p91: board embedded/micro_bot/main/main.brd from above]

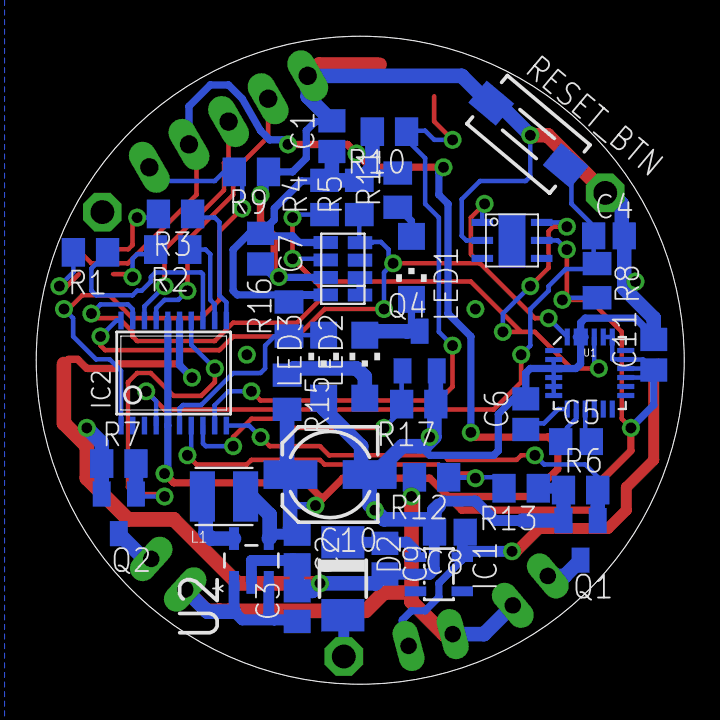
[picture p92: board embedded/micro_bot/main/main.brd from below]

Board: 2 copper layers, 36.0 x 36.0 mm, 52 parts (42 on the bottom side), 34 nets.
