richese/aeris/embedded/micro_bot/ir_comm/main.brd

## EAGLE design embedded/micro_bot/ir_comm/main.brd (2016-04-06)

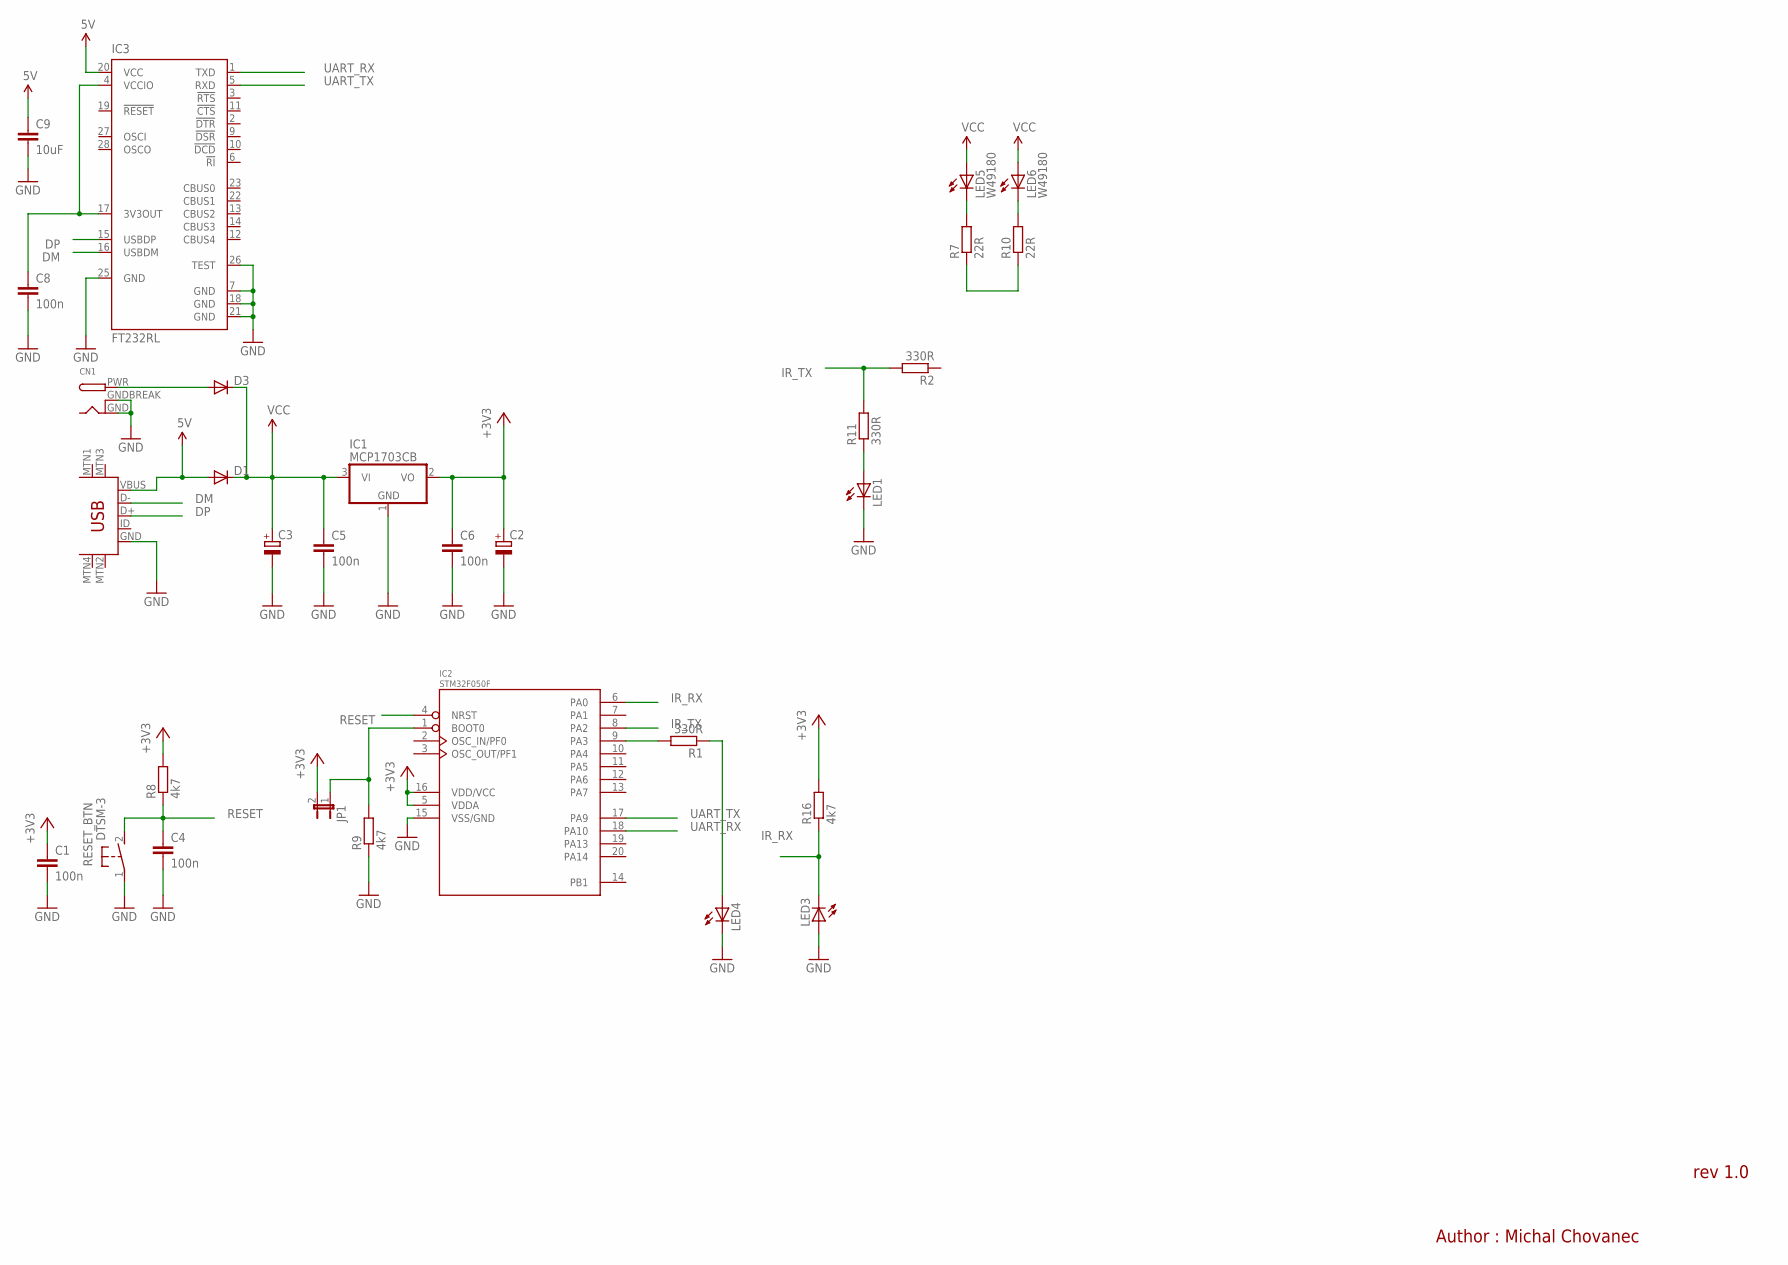
[picture p93: schematic main.sch]

Parts:
C1, C4, C5, C6, C8: 100n; C0805
C2: CPOL-EU153CLV-0405; 153CLV-0405
C3: CPOL-EU150CLZ-1010; 150CLZ-1010
C9: 10uF; C0805
CN1: DCBARRELPTH; DCJACK_2MM_PTH
D1, D3: DIODE-DO-214AC; DO-214AC
IC1: MCP1703CB; SOT23
IC2: STM32F050F; TSSOP20
IC3: FT232RL; SSOP28
JP1: JP1E; JP1
LED1, LED3, LED4: LEDCHIPLED_1206; CHIPLED_1206
LED5, LED6: W49180; Z-POWER-LED-DOME-TYPE
R1, R2, R11: 330R; M0805
R7, R10: 22R; M0805
R8, R9, R16: 4k7; M0805
RESET_BTN: DTSM-3
U$1: USB-MINIB-5PIN; USB-MINIB

Connections:
5V: C9.1, D1.A, IC3.20 (VCC), U$1.VBUS
+3V3: C1.1, C2.+, C6.1, IC1.2 (VO), IC2.5 (VDDA), IC2.16 (VDD/VCC), JP1.2, R8.2, R16.2
BOOT: IC2.1 (BOOT0), JP1.1, R9.2
DM: IC3.16 (USBDM), U$1.D-
DP: IC3.15 (USBDP), U$1.D+
GND: C1.2, C2.-, C3.-, C4.2, C5.2, C6.2, C8.2, C9.2, CN1.GND, CN1.GNDBREAK, IC1.1 (GND), IC2.15 (VSS/GND), IC3.7 (GND), IC3.18 (GND), IC3.21 (GND), IC3.25 (GND), IC3.26 (TEST), LED1.C, LED3.A, LED4.C, R9.1, RESET_BTN.1, U$1.GND
IR_RX: IC2.6 (PA0), LED3.C, R16.1
IR_TX: IC2.8 (PA2), R2.2, R11.2
unnamed: IC2.9 (PA3), R1.2
unnamed: C8.1, IC3.4 (VCCIO), IC3.17 (3V3OUT)
unnamed: LED1.A, R11.1
unnamed: CN1.PWR, D3.A
unnamed: LED4.A, R1.1
unnamed: LED5.C, R7.2
unnamed: LED6.C, R10.2
unnamed: R7.1, R10.1
RESET: C4.1, IC2.4 (NRST), R8.1, RESET_BTN.2
UART_RX: IC2.18 (PA10), IC3.1 (TXD)
UART_TX: IC2.17 (PA9), IC3.5 (RXD)
VCC: C3.+, C5.1, D1.C, D3.C, IC1.3 (VI), LED5.A, LED6.A

Notes on the sheet:
rev 1.0
Author : Michal Chovanec

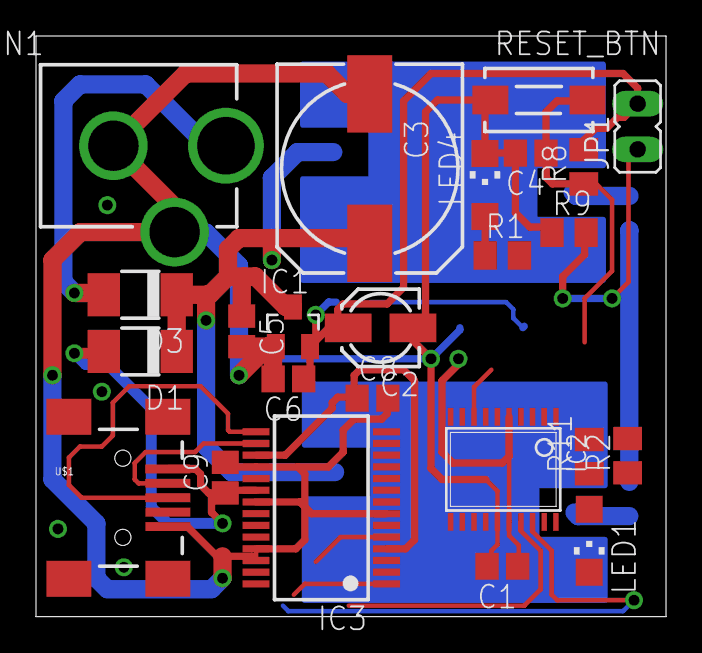
[picture p94: board embedded/micro_bot/ir_comm/main.brd from above]

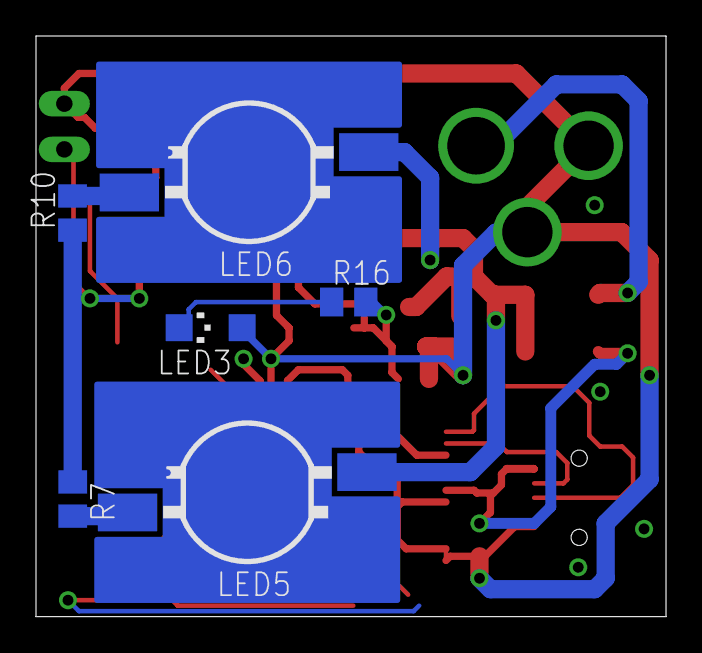
[picture p95: board embedded/micro_bot/ir_comm/main.brd from below]

Board: 2 copper layers, 35.0 x 32.3 mm, 30 parts (6 on the bottom side), 20 nets.
