richese/aeris/embedded/micro_bot/uart_programmer/main.brd

## EAGLE design embedded/micro_bot/uart_programmer/main.brd (2016-04-06)

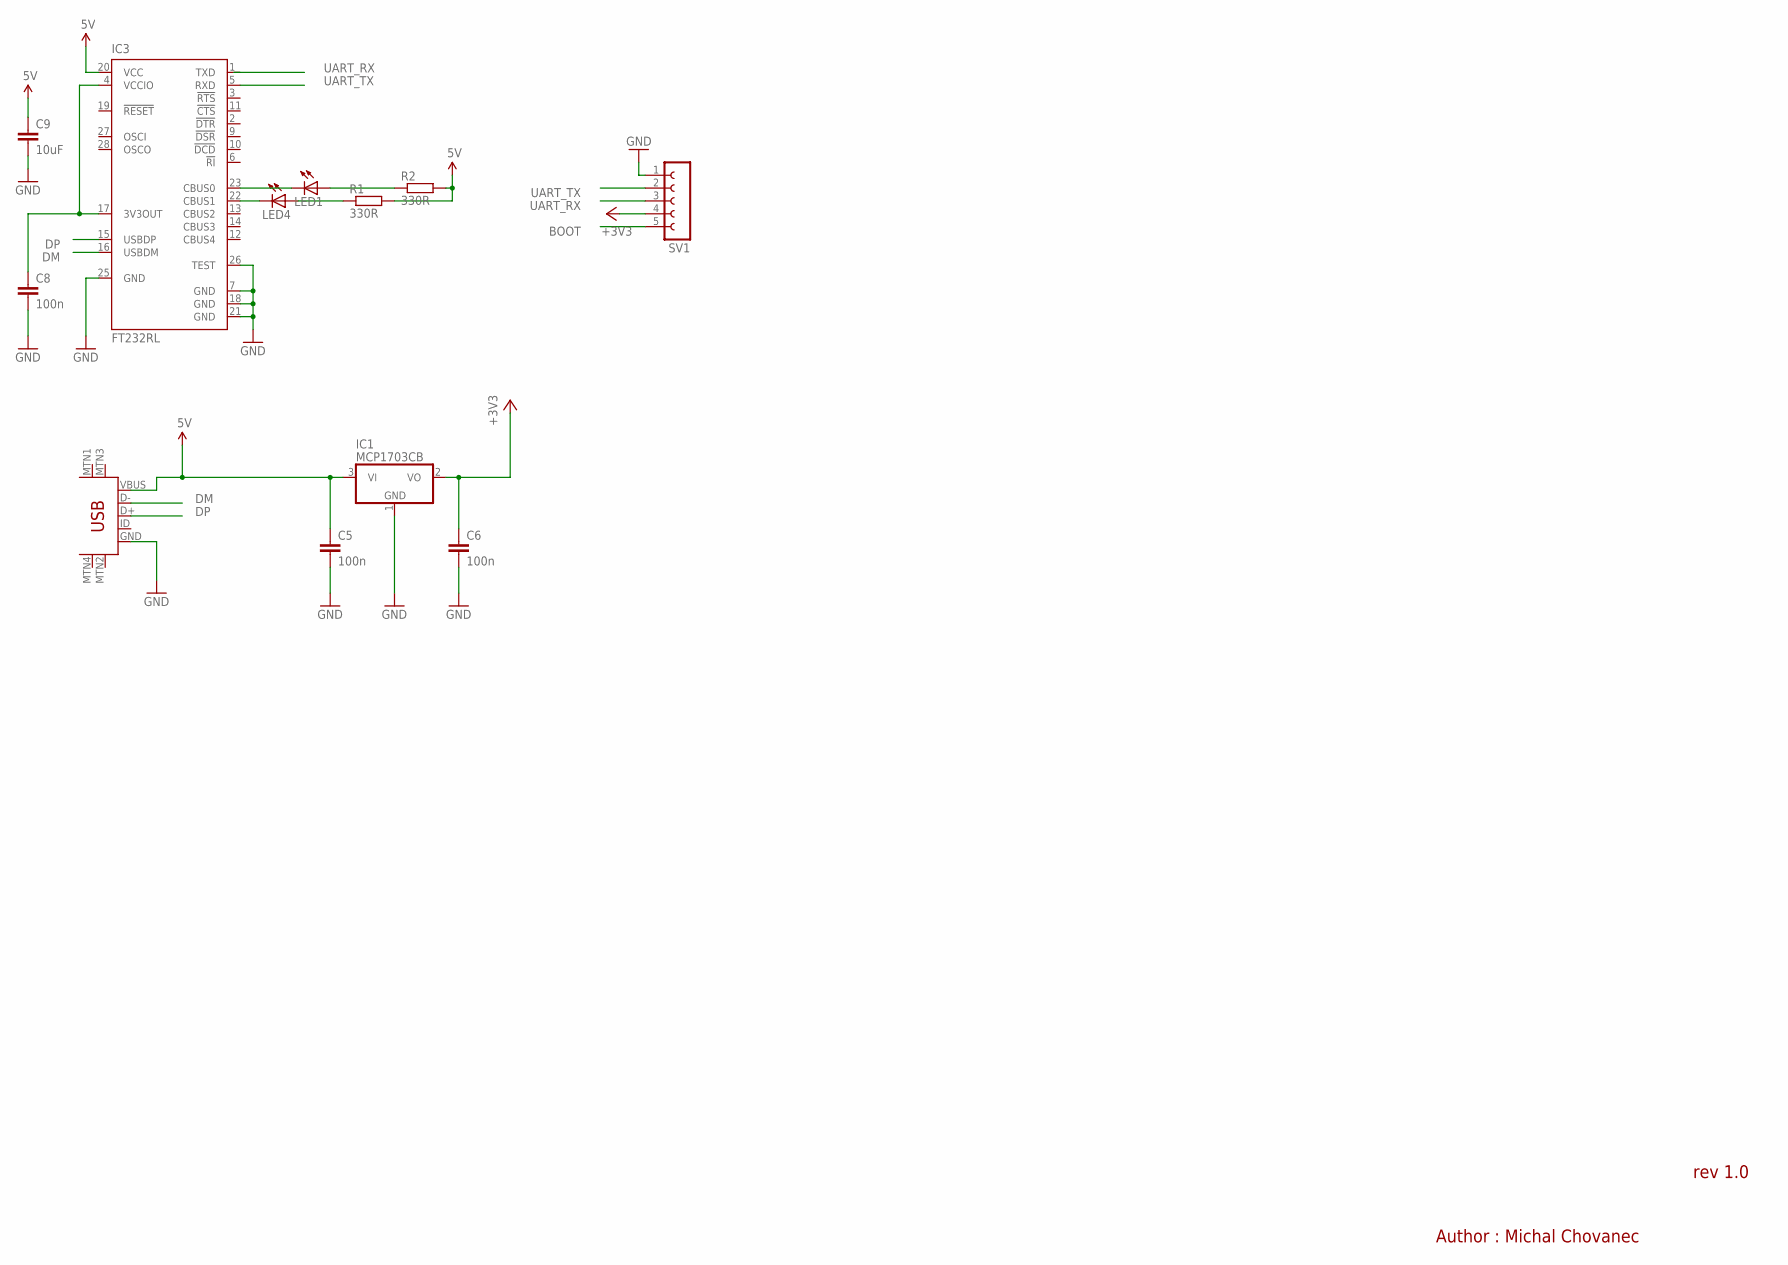
[picture p96: schematic main.sch]

Parts:
C5, C6, C8: 100n; C0805
C9: 10uF; C0805
IC1: MCP1703CB; SOT23
IC3: FT232RL; SSOP28
LED1, LED4: LEDCHIPLED_1206; CHIPLED_1206
R1, R2: 330R; M0805
SV1: FE05-1
U$1: USB-MINIB-5PIN; USB-MINIB

Connections:
5V: C5.1, C9.1, IC1.3 (VI), IC3.20 (VCC), R1.2, R2.2, U$1.VBUS
+3V3: C6.1, IC1.2 (VO), SV1.4
BOOT: SV1.5
DM: IC3.16 (USBDM), U$1.D-
DP: IC3.15 (USBDP), U$1.D+
GND: C5.2, C6.2, C8.2, C9.2, IC1.1 (GND), IC3.7 (GND), IC3.18 (GND), IC3.21 (GND), IC3.25 (GND), IC3.26 (TEST), SV1.1, U$1.GND
unnamed: IC3.23 (CBUS0), LED1.C
unnamed: C8.1, IC3.4 (VCCIO), IC3.17 (3V3OUT)
unnamed: IC3.22 (CBUS1), LED4.C
unnamed: LED4.A, R1.1
unnamed: LED1.A, R2.1
UART_RX: SV1.3
UART_TX: IC3.5 (RXD), SV1.2

Notes on the sheet:
rev 1.0
Author : Michal Chovanec

Board: 2 copper layers, 12 parts (0 on the bottom side), 11 nets, no tracks yet.
