richese/aeris/embedded/hardware_2.0/rev_1.0/main_board/main.brd

## EAGLE design embedded/hardware_2.0/rev_1.0/main_board/main.brd (2016-02-19)

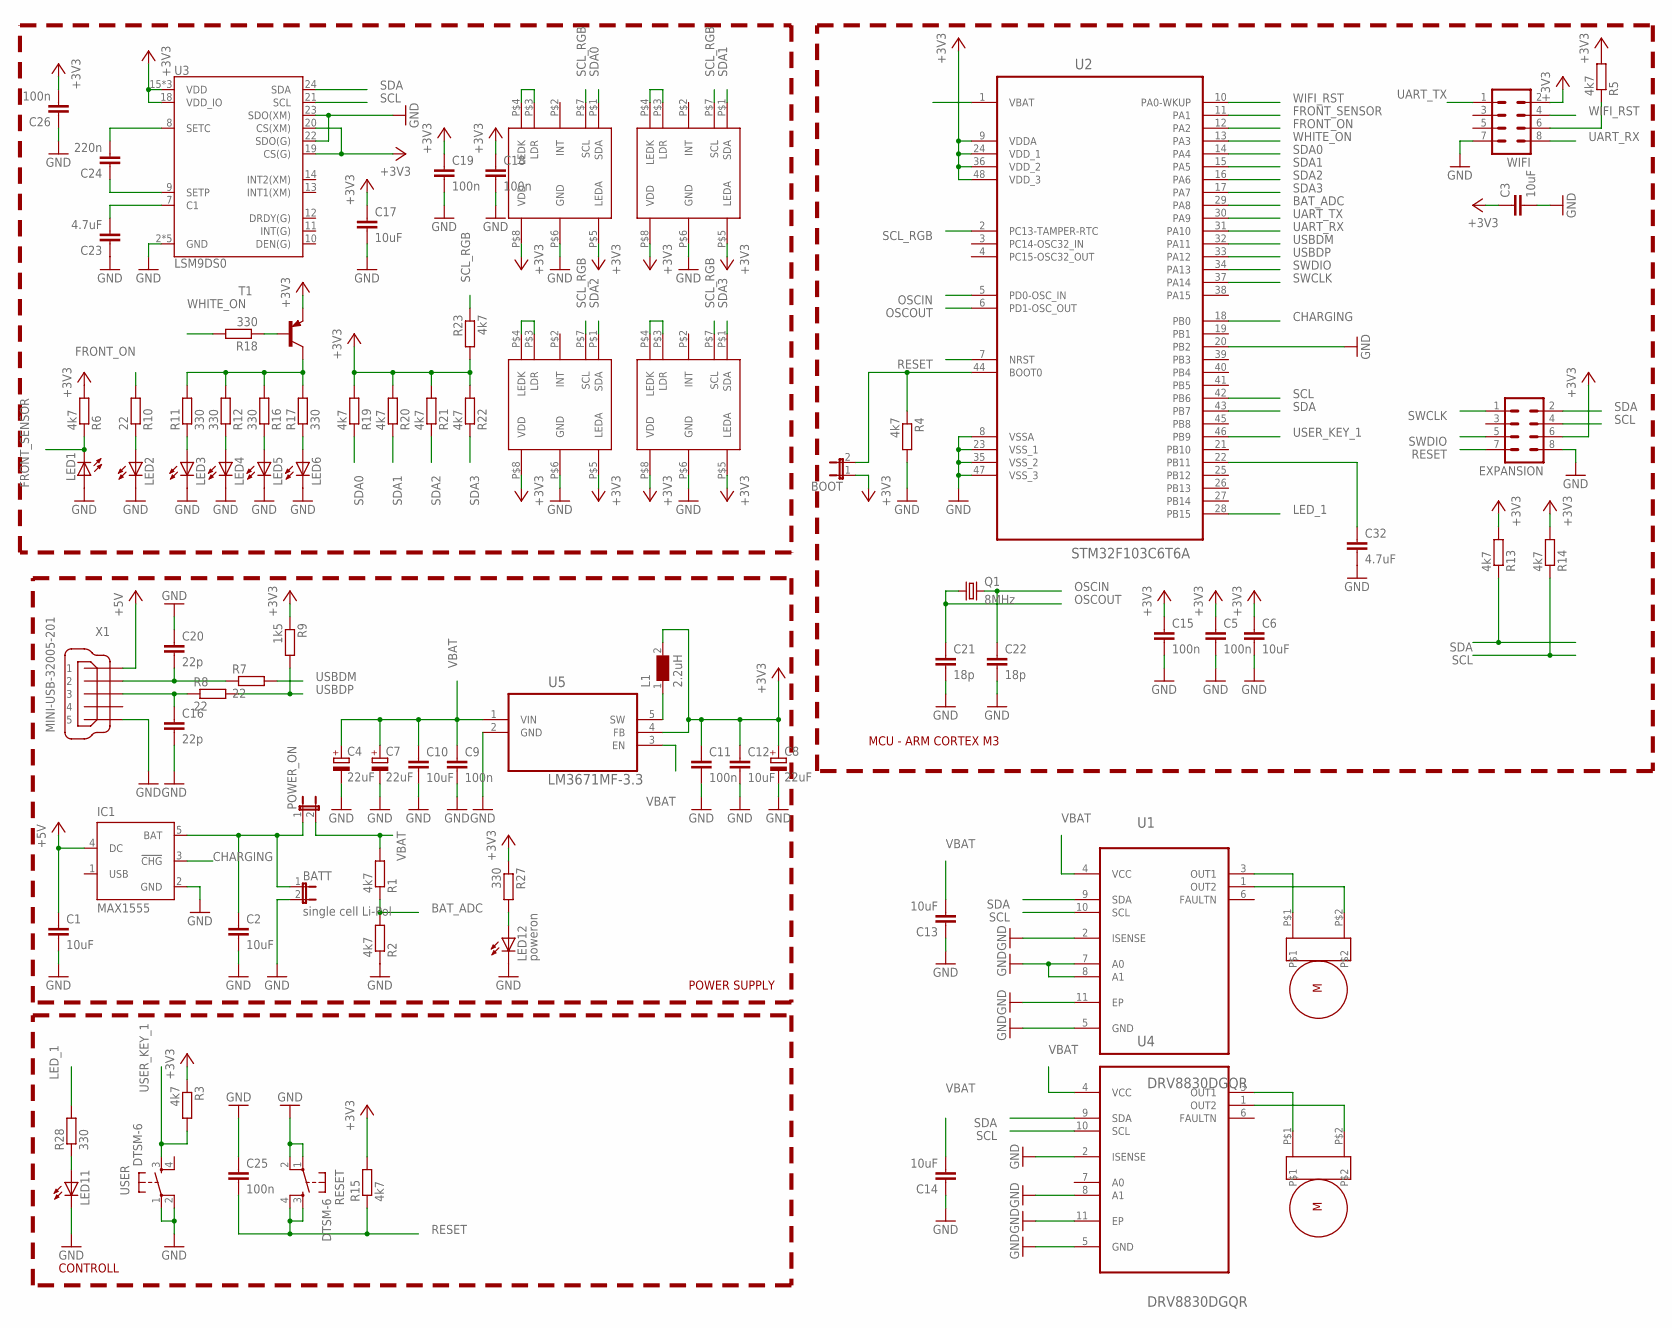
[picture p97: schematic main.sch]

Parts:
BATT: single cell Li-Pol; JP1
BOOT: JP1E; JP1
C1, C2, C3, C6, C10, C12, C13, C14, C17: 10uF; C0805
C4, C7, C8: 22uF; 153CLV-0505
C5, C9, C11, C15, C18, C19, C25, C26: 100n; C0805
C16, C20: 22p; C0805
C21, C22: 18p; C0805
C23, C32: 4.7uF; C0805
C24: 220n; C0805
EXPANSION: MA04-2
IC1: MAX1555; SOT23-5L
L1: 2.2uH; WE-LQ_M
LED1, LED2: LED5MM
LED3, LED4, LED5, LED6, LED11: LEDCHIPLED_1206; CHIPLED_1206
LED12: poweron; CHIPLED_1206
POWER_ON: JP1E; JP1
Q1: 8MHz; CTS406
R1, R2, R3, R4, R5, R6, R13, R14, R15, R19, R20, R21, R22, R23: 4k7; M0805
R7, R8, R10: 22; M0805
R9: 1k5; M0805
R11, R12, R16, R17, R18, R27, R28: 330; M0805
RESET: DTSM-6
T1: BC857A-PNP-SOT23-BEC; SOT23-BEC
U1, U4: DRV8830DGQR; SOP65P640X110-15N
U2: STM32F103C6T6A; QFP50P900X900X160-48N
U3: LSM9DS0; LGA-24
U5: LM3671MF-3.3; SOT95P284X122-5N
U$1, U$2, U$3, U$4: APDS9950
U$5, U$6: MICRO_METAL_GEAR_MOTOR
USER: DTSM-6
WIFI: MA04-2
X1: MINI-USB-32005-201; 32005-201

Connections:
+3V3: BOOT.1, C3.1, C5.1, C6.1, C8.+, C11.1, C12.1, C15.1, C17.1, C18.1, C19.1, C26.2, EXPANSION.6, L1.2, R3.1, R5.2, R6.2, R9.1, R13.2, R14.2, R15.2, R19.2, R20.2, R21.2, R22.2, R23.2, R27.1, T1.E, U2.9 (VDDA), U2.24 (VDD_1), U2.36 (VDD_2), U2.48 (VDD_3), U3.15 (VDD), U3.16 (VDD), U3.17 (VDD), U3.18 (VDD_IO), U3.19 (CS(G)), U3.20 (CS(XM)), U5.4 (FB), U$1.P$5 (LEDA), U$1.P$8 (VDD), U$2.P$5 (LEDA), U$2.P$8 (VDD), U$3.P$5 (LEDA), U$3.P$8 (VDD), U$4.P$5 (LEDA), U$4.P$8 (VDD), WIFI.2
+5V: C1.1, IC1.4 (DC), X1.1
BAT_ADC: R1.1, R2.2, U2.29 (PA8)
CHARGING: IC1.3 (!CHG), U2.18 (PB0)
FRONT_ON: R10.2, U2.12 (PA2)
FRONT_SENSOR: LED1.K (C), R6.1, U2.11 (PA1)
GND: BATT.2, C1.2, C2.2, C3.2, C4.-, C5.2, C6.2, C7.-, C8.-, C9.2, C10.2, C11.2, C12.2, C13.1, C14.1, C15.2, C16.2, C17.2, C18.2, C19.2, C20.1, C21.2, C22.2, C23.1, C25.1, C26.1, C32.2, EXPANSION.8, IC1.2 (GND), LED1.A, LED2.K (C), LED3.C, LED4.C, LED5.C, LED6.C, LED11.C, LED12.C, R2.1, R4.2, RESET.1, RESET.2, U1.2 (ISENSE), U1.5 (GND), U1.7 (A0), U1.8 (A1), U1.11 (EP), U2.8 (VSSA), U2.20 (PB2), U2.23 (VSS_1), U2.35 (VSS_2), U2.47 (VSS_3), U3.2 (GND), U3.3 (GND), U3.4 (GND), U3.5 (GND), U3.6 (GND), U3.22 (SDO(G)), U3.23 (SDO(XM)), U4.2 (ISENSE), U4.5 (GND), U4.8 (A1), U4.11 (EP), U5.2 (GND), U$1.P$6 (GND), U$2.P$6 (GND), U$3.P$6 (GND), U$4.P$6 (GND), USER.1, USER.2, WIFI.7, X1.5
LED_1: R28.2, U2.28 (PB15)
unnamed: R5.1, WIFI.6
unnamed: BATT.1, C2.1, IC1.5 (BAT), POWER_ON.1
unnamed: U1.1 (OUT2), U$5.P$2
unnamed: U1.3 (OUT1), U$5.P$1
unnamed: U4.1 (OUT2), U$6.P$2
unnamed: C23.2, U3.7 (C1)
unnamed: C24.2, U3.8 (SETC)
unnamed: U4.3 (OUT1), U$6.P$1
unnamed: L1.1, U5.5 (SW)
unnamed: C24.1, U3.9 (SETP)
unnamed: C32.1, U2.22 (PB11)
unnamed: LED3.A, R11.1
unnamed: BOOT.2, R4.1, U2.44 (BOOT0)
unnamed: U$1.P$3 (LDR), U$1.P$4 (LEDK)
unnamed: U$2.P$3 (LDR), U$2.P$4 (LEDK)
unnamed: U$3.P$3 (LDR), U$3.P$4 (LEDK)
unnamed: U$4.P$3 (LDR), U$4.P$4 (LEDK)
unnamed: LED2.A, R10.1
unnamed: LED4.A, R12.1
unnamed: LED12.A, R27.2
unnamed: LED5.A, R16.1
unnamed: LED6.A, R17.1
unnamed: R11.2, R12.2, R16.2, R17.2, T1.C
unnamed: R18.1, T1.B
unnamed: LED11.A, R28.1
unnamed: C20.2, R7.1, X1.2
unnamed: C16.1, R8.1, X1.3
NC: U2.1 (VBAT)
OSCIN: C22.1, Q1.3 (2), U2.5 (PD0-OSC_IN)
OSCOUT: C21.1, Q1.1, U2.6 (PD1-OSC_OUT)
RESET: C25.2, EXPANSION.7, R15.1, RESET.3, RESET.4, U2.7 (NRST)
SCL: EXPANSION.4, R14.1, U1.10 (SCL), U2.42 (PB6), U3.21 (SCL), U4.10 (SCL)
SCL_RGB: R23.1, U2.2 (PC13-TAMPER-RTC), U$1.P$7 (SCL), U$2.P$7 (SCL), U$3.P$7 (SCL), U$4.P$7 (SCL)
SDA: EXPANSION.2, R13.1, U1.9 (SDA), U2.43 (PB7), U3.24 (SDA), U4.9 (SDA)
SDA0: R19.1, U2.14 (PA4), U$1.P$1 (SDA)
SDA1: R20.1, U2.15 (PA5), U$2.P$1 (SDA)
SDA2: R21.1, U2.16 (PA6), U$3.P$1 (SDA)
SDA3: R22.1, U2.17 (PA7), U$4.P$1 (SDA)
SWCLK: EXPANSION.1, U2.37 (PA14)
SWDIO: EXPANSION.5, U2.34 (PA13)
UART_RX: U2.31 (PA10), WIFI.8
UART_TX: U2.30 (PA9), WIFI.1
USBDM: R7.2, U2.32 (PA11)
USBDP: R8.2, R9.2, U2.33 (PA12)
USER_KEY_1: R3.2, U2.46 (PB9), USER.3
VBAT: C4.+, C7.+, C9.1, C10.1, C13.2, C14.2, POWER_ON.2, R1.2, U1.4 (VCC), U4.4 (VCC), U5.1 (VIN), U5.3 (EN)
WHITE_ON: R18.2, U2.13 (PA3)
WIFI_RST: U2.10 (PA0-WKUP), WIFI.4

Notes on the sheet:
POWER SUPPLY
CONTROLL
MCU - ARM CORTEX M3

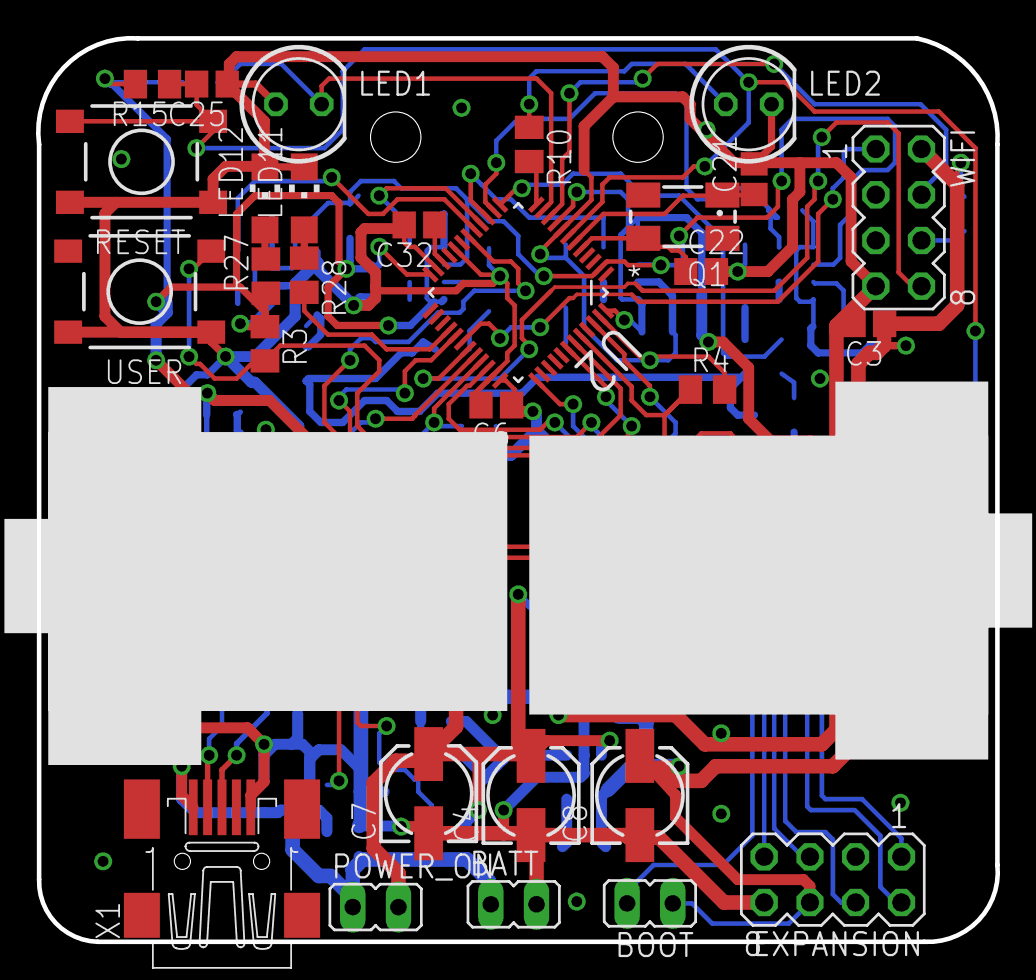
[picture p98: board embedded/hardware_2.0/rev_1.0/main_board/main.brd from above]

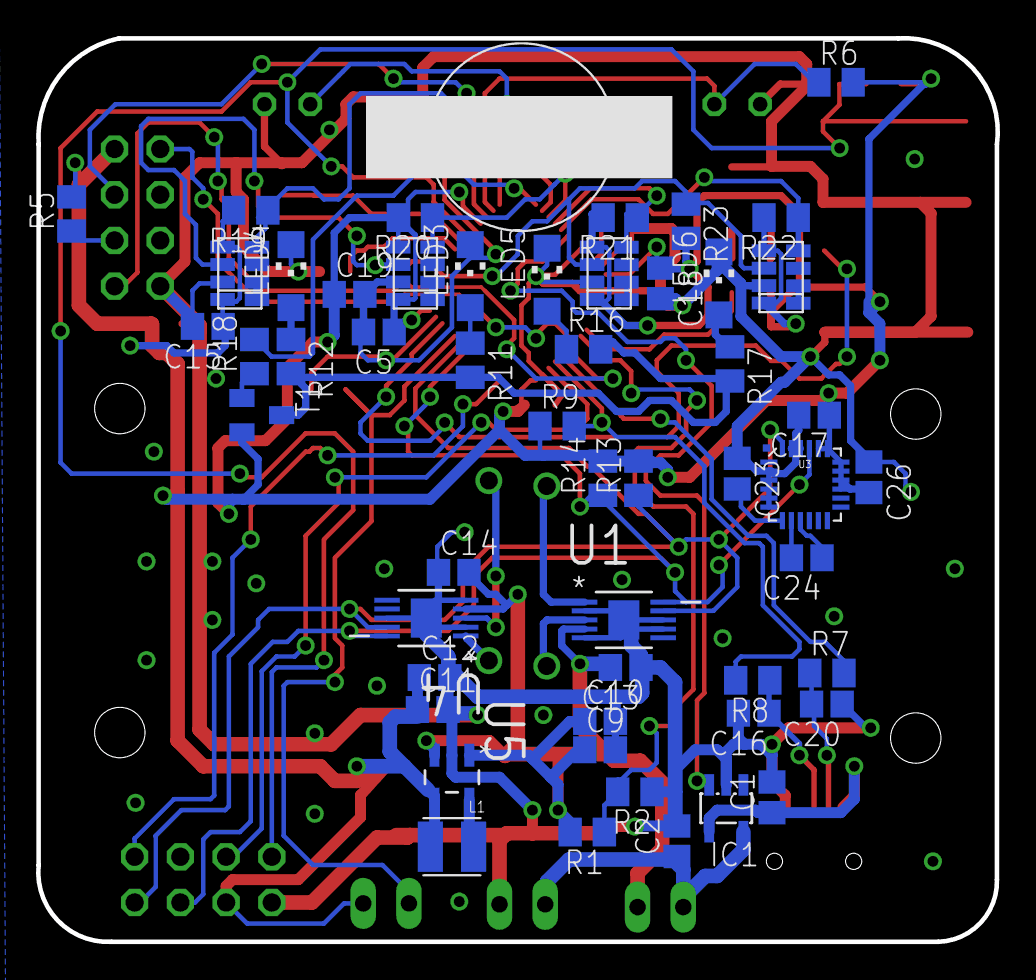
[picture p99: board embedded/hardware_2.0/rev_1.0/main_board/main.brd from below]

Board: 2 copper layers, 53.3 x 50.2 mm, 84 parts (53 on the bottom side), 55 nets.

Other parts of the board:
U$7: BALL_3/8
