richese/aeris/embedded/hardware_2.0/rev_1.0/mcu_board/main.brd

## EAGLE design embedded/hardware_2.0/rev_1.0/mcu_board/main.brd (2016-02-19)

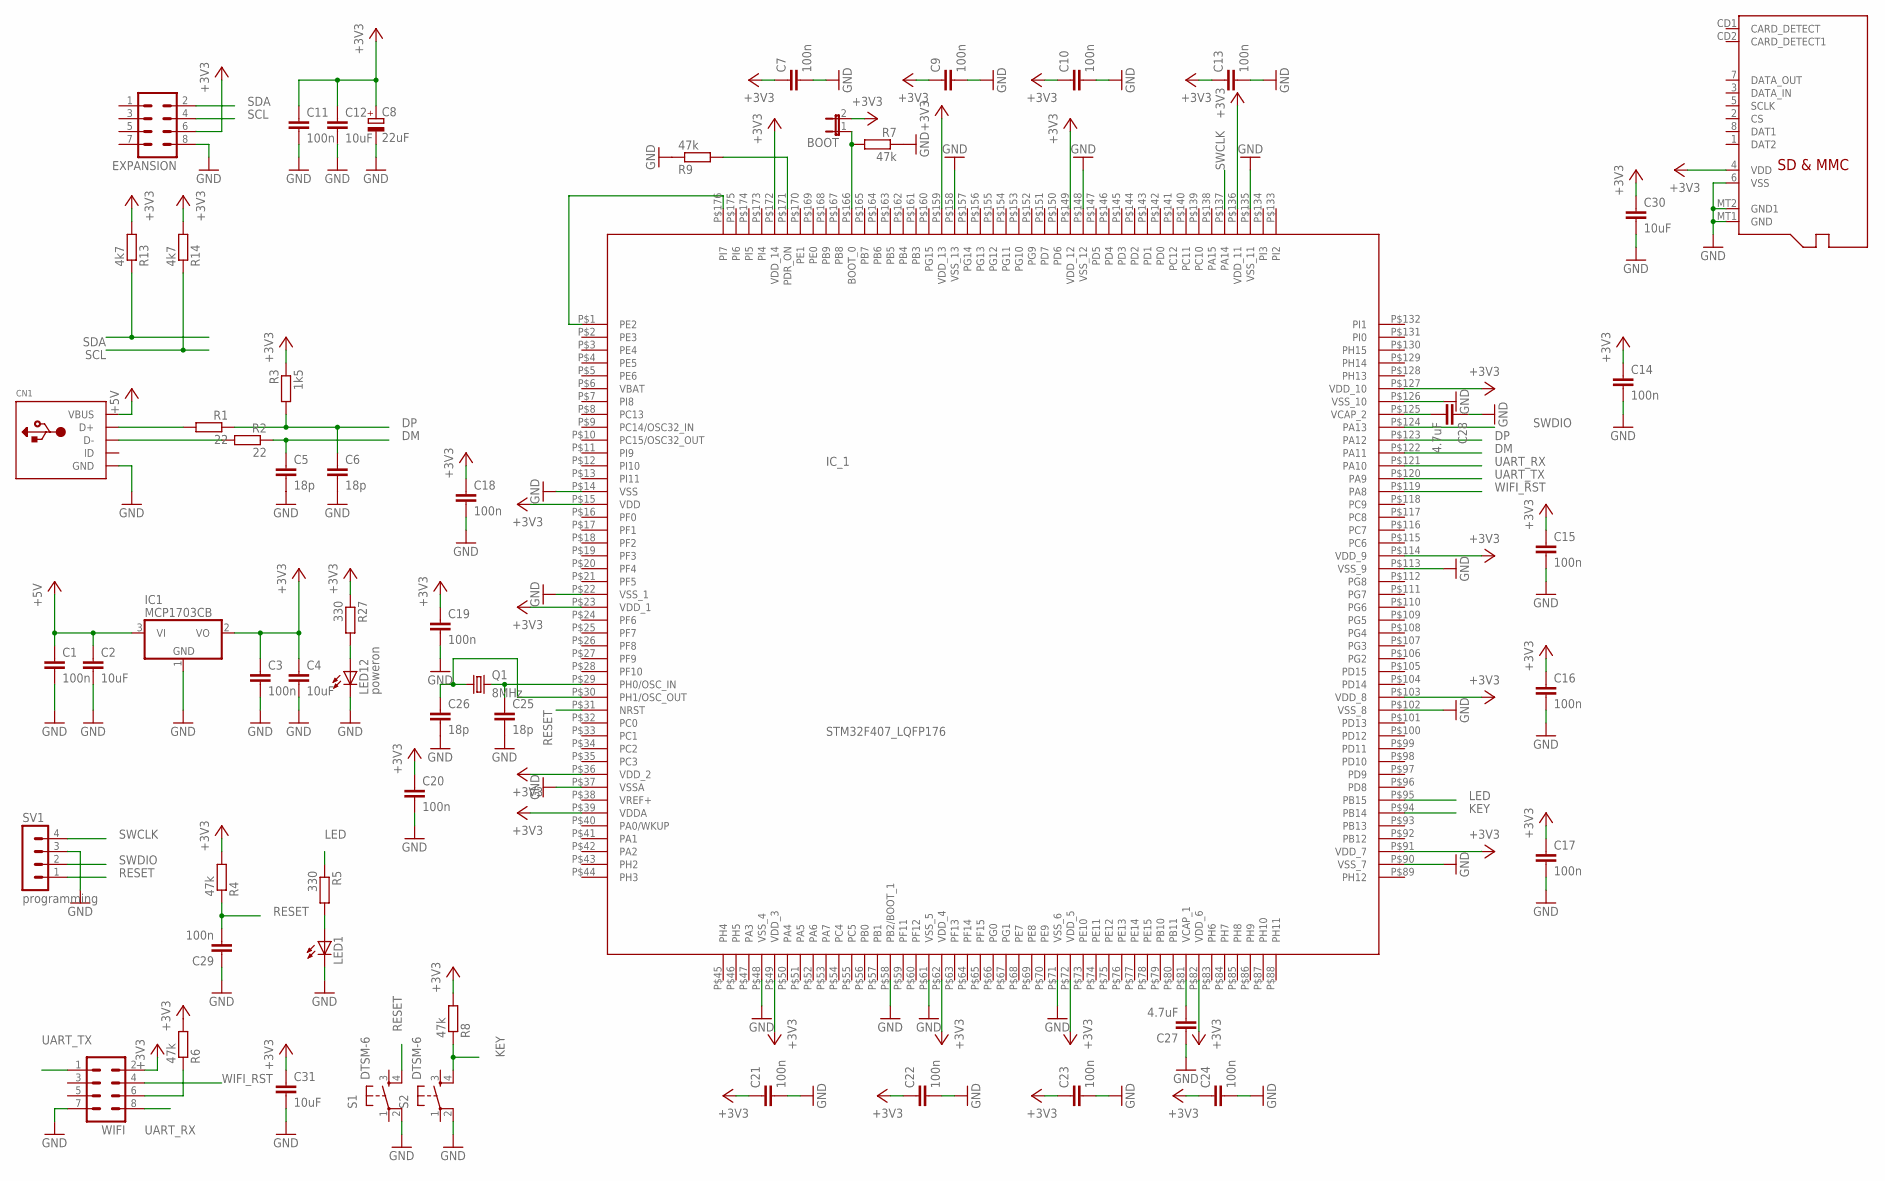
[picture p100: schematic main.sch]

Parts:
BOOT: JP1E; JP1
C1, C3, C7, C9, C10, C11, C13, C14, C15, C16, C17, C18, C19, C20, C21, C22, C23, C24, C29: 100n; C0805
C2, C4, C12, C30, C31: 10uF; C0805
C5, C6, C25, C26: 18p; C0805
C8: 22uF; 153CLV-0505
C27, C28: 4.7uF; C0805
CN1: USBMINIB; USB-MINIB
EXPANSION: MA04-2
IC1: MCP1703CB; SOT23
IC_1: STM32F407_LQFP176
LED1: LEDCHIPLED_1206; CHIPLED_1206
LED12: poweron; CHIPLED_1206
Q1: 8MHz; CTS406
R1, R2: 22; M0805
R3: 1k5; M0805
R4, R6, R7, R8, R9: 47k; M0805
R5, R27: 330; M0805
R13, R14: 4k7; M0805
S1, S2: DTSM-6
SV1: programming; MA04-1
U$1: MICROSD
WIFI: MA04-2

Connections:
+3V3: BOOT.2, C3.1, C4.1, C7.1, C8.+, C9.1, C10.1, C11.1, C12.1, C13.1, C14.1, C15.1, C16.1, C17.1, C18.1, C19.1, C20.1, C21.1, C22.1, C23.1, C24.1, C30.1, C31.1, EXPANSION.6, IC1.2 (VO), IC_1.P$15 (VDD), IC_1.P$23 (VDD_1), IC_1.P$36 (VDD_2), IC_1.P$39 (VDDA), IC_1.P$49 (VDD_3), IC_1.P$62 (VDD_4), IC_1.P$72 (VDD_5), IC_1.P$82 (VDD_6), IC_1.P$91 (VDD_7), IC_1.P$103 (VDD_8), IC_1.P$114 (VDD_9), IC_1.P$127 (VDD_10), IC_1.P$136 (VDD_11), IC_1.P$149 (VDD_12), IC_1.P$159 (VDD_13), IC_1.P$172 (VDD_14), R3.1, R4.2, R6.2, R8.2, R13.2, R14.2, R27.1, U$1.4 (VDD), WIFI.2
+5V: C1.1, C2.1, CN1.VBUS, IC1.3 (VI)
DM: C5.1, IC_1.P$122 (PA11), R2.1
DP: C6.1, IC_1.P$123 (PA12), R1.1, R3.2
GND: C1.2, C2.2, C3.2, C4.2, C5.2, C6.2, C7.2, C8.-, C9.2, C10.2, C11.2, C12.2, C13.2, C14.2, C15.2, C16.2, C17.2, C18.2, C19.2, C20.2, C21.2, C22.2, C23.2, C24.2, C25.2, C26.2, C27.1, C28.1, C29.1, C30.2, C31.2, CN1.GND, EXPANSION.8, IC1.1 (GND), IC_1.P$14 (VSS), IC_1.P$22 (VSS_1), IC_1.P$37 (VSSA), IC_1.P$48 (VSS_4), IC_1.P$58 (PB2/BOOT_1), IC_1.P$61 (VSS_5), IC_1.P$71 (VSS_6), IC_1.P$90 (VSS_7), IC_1.P$102 (VSS_8), IC_1.P$113 (VSS_9), IC_1.P$126 (VSS_10), IC_1.P$135 (VSS_11), IC_1.P$148 (VSS_12), IC_1.P$158 (VSS_13), LED1.C, LED12.C, R7.1, R9.1, S1.2, S2.2, SV1.3, U$1.6 (VSS), U$1.MT1 (GND), U$1.MT2 (GND1), WIFI.7
KEY: IC_1.P$94 (PB14), R8.1, S2.4
LED: IC_1.P$95 (PB15), R5.1
unnamed: CN1.D+, R1.2
unnamed: CN1.D-, R2.2
unnamed: C25.1, IC_1.P$29 (PH0/OSC_IN), Q1.3 (2)
unnamed: C26.1, IC_1.P$30 (PH1/OSC_OUT), Q1.1
unnamed: C27.2, IC_1.P$81 (VCAP_1)
unnamed: C28.2, IC_1.P$125 (VCAP_2)
unnamed: LED1.A, R5.2
unnamed: R6.1, WIFI.6
unnamed: BOOT.1, IC_1.P$166 (BOOT_0), R7.2
unnamed: IC_1.P$171 (PDR_ON), R9.2
unnamed: IC_1.P$1 (PE2), IC_1.P$176 (PI7)
unnamed: LED12.A, R27.2
RESET: C29.2, IC_1.P$31 (NRST), R4.1, S1.4, SV1.1
SCL: EXPANSION.4, R14.1
SDA: EXPANSION.2, R13.1
SWCLK: IC_1.P$137 (PA14), SV1.4
SWDIO: IC_1.P$124 (PA13), SV1.2
UART_RX: IC_1.P$121 (PA10), WIFI.8
UART_TX: IC_1.P$120 (PA9), WIFI.1
VBAT: IC_1.P$6 (VBAT)
VREF+: IC_1.P$38 (VREF+)
WIFI_RST: IC_1.P$119 (PA8), WIFI.4
