richese/aeris/embedded/hardware_2.0/rev_1.0/mcu_board/main.brd

## EAGLE design embedded/hardware_2.0/rev_1.0/mcu_board/main.brd (continued)

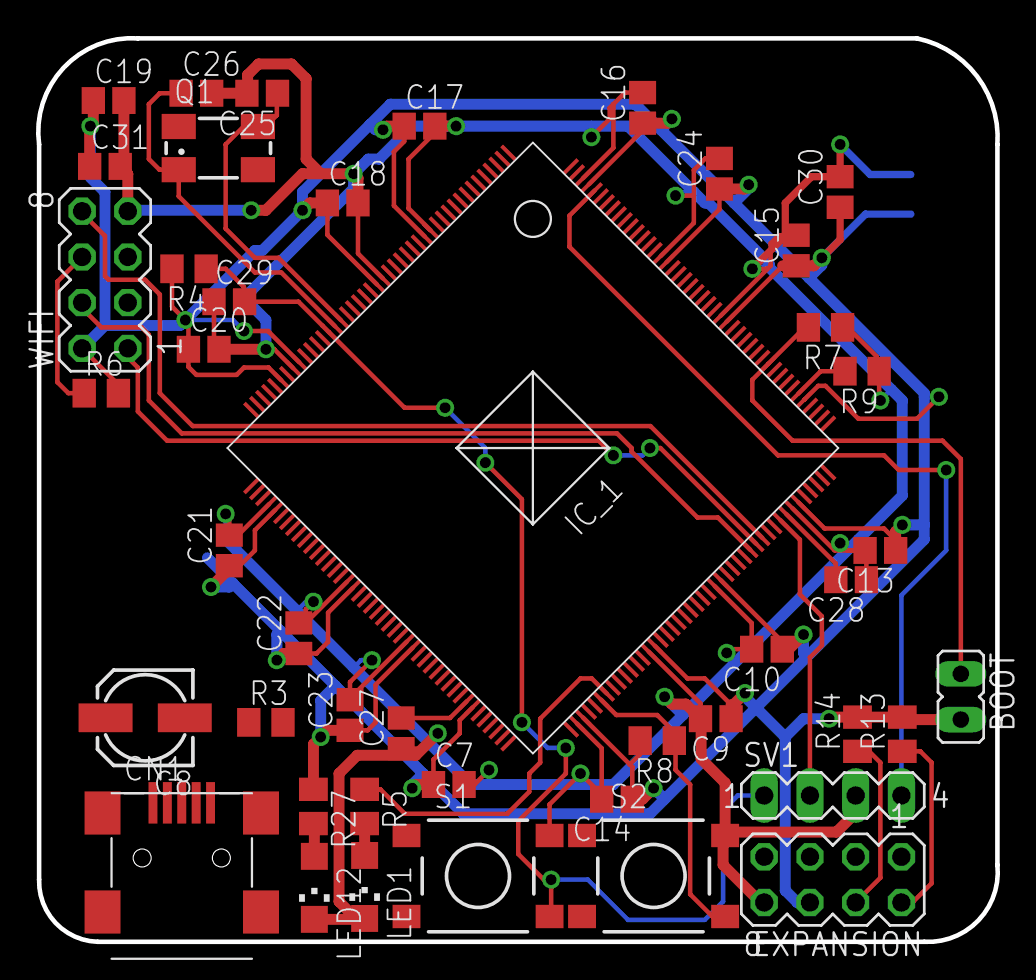
[picture p101: board embedded/hardware_2.0/rev_1.0/mcu_board/main.brd from above]

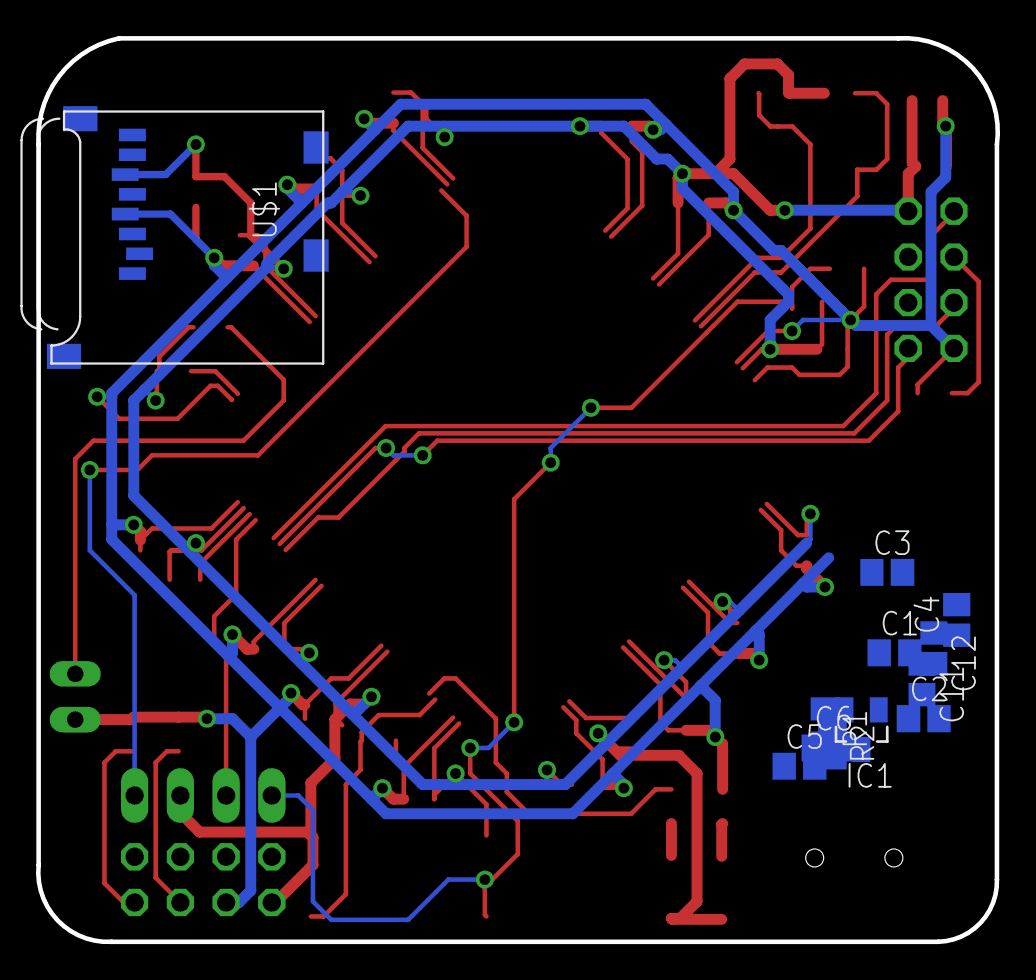
[picture p102: board embedded/hardware_2.0/rev_1.0/mcu_board/main.brd from below]

Board: 2 copper layers, 53.3 x 50.2 mm, 56 parts (12 on the bottom side), 27 nets.
