richese/aeris/embedded/hardware_2.0/rev_1.0/sensor_board/sensor_board.brd

## EAGLE design embedded/hardware_2.0/rev_1.0/sensor_board/sensor_board.brd (2016-02-08)

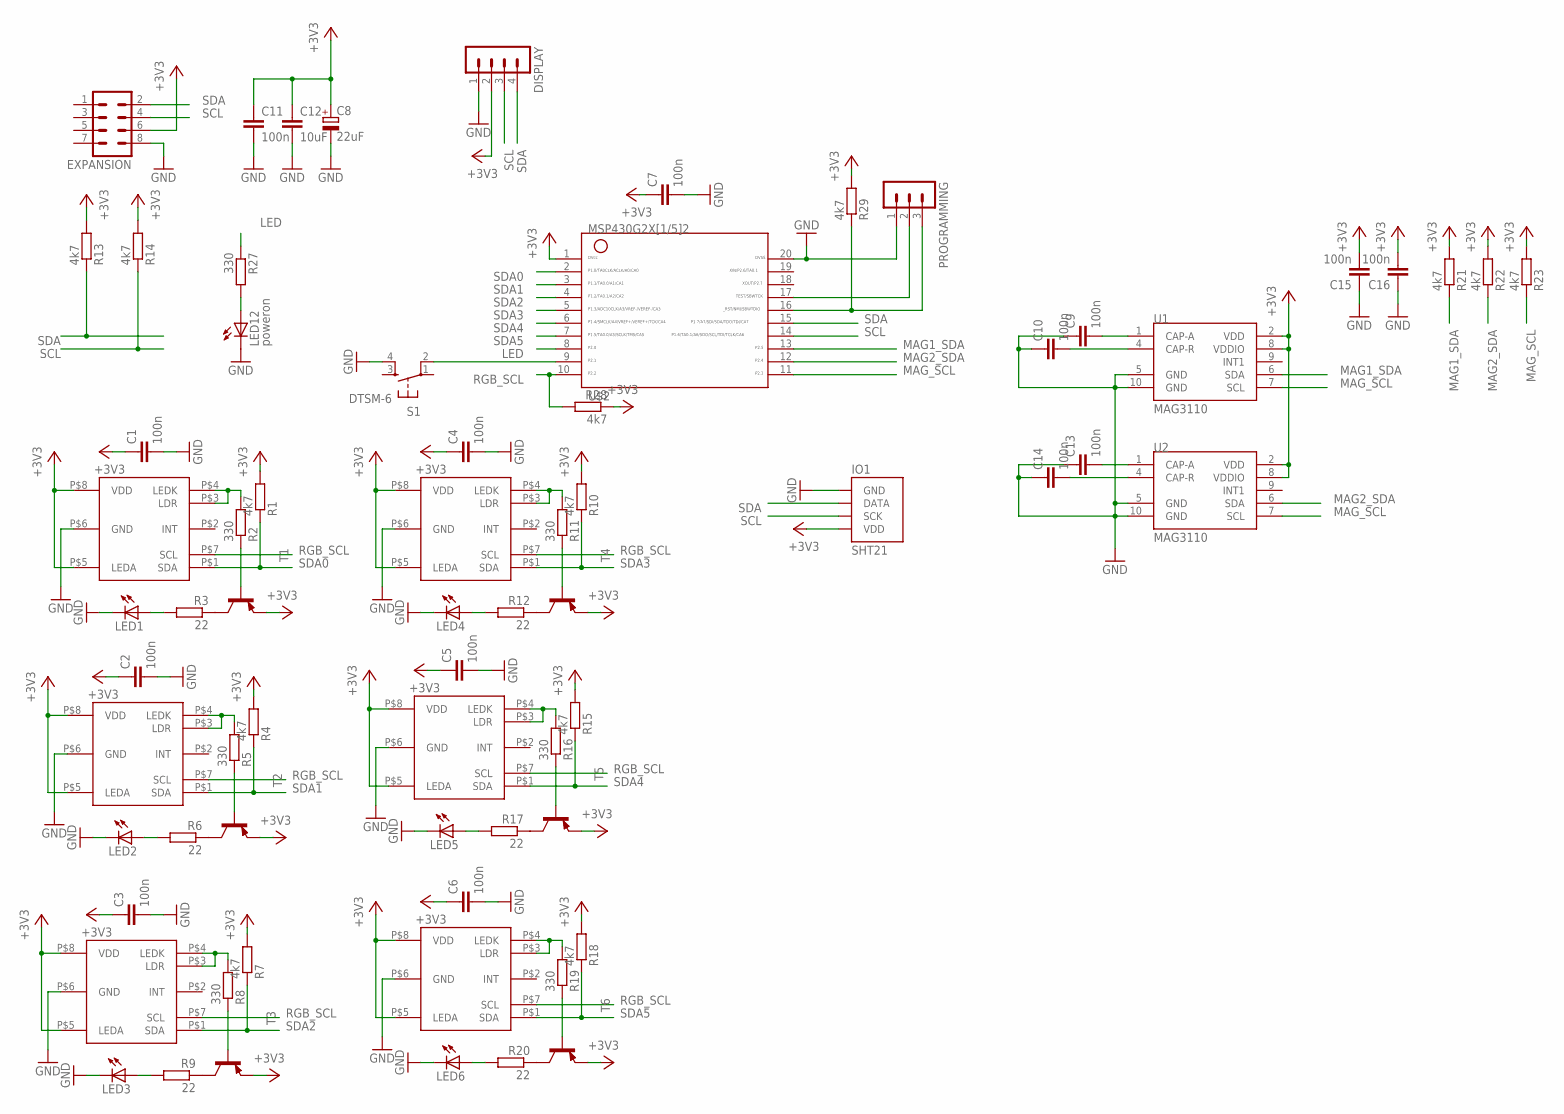
[picture p103: schematic sensor_board.sch]

Parts:
C1, C2, C3, C4, C5, C6, C7, C9, C10, C11, C13, C14, C15, C16: 100n; C0805
C8: 22uF; 153CLV-0505
C12: 10uF; C0805
DISPLAY: MA04-1
EXPANSION: MA04-2
IO1: SHT21; SHT2X
LED1, LED2, LED3, LED4, LED5, LED6: LED5MM
LED12: poweron; CHIPLED_1206
PROGRAMMING: MA03-1
R1, R4, R7, R10, R13, R14, R15, R18, R21, R22, R23, R28, R29: 4k7; M0805
R2, R5, R8, R11, R16, R19, R27: 330; M0805
R3, R6, R9, R12, R17, R20: 22; M0805
S1: DTSM-6
T1, T2, T3, T4, T5, T6: BC857A-PNP-SOT23-BEC; SOT23-BEC
U1, U2: MAG3110; DFN-10
U$1, U$3, U$4, U$5, U$6, U$7: APDS9950_EDGE
U$2: G2X[1/5]2---PW20; PW20

Connections:
+3V3: C1.1, C2.1, C3.1, C4.1, C5.1, C6.1, C7.1, C8.+, C11.1, C12.1, C15.2, C16.2, DISPLAY.2, EXPANSION.6, IO1.5 (VDD), R1.2, R4.2, R7.2, R10.2, R13.2, R14.2, R15.2, R18.2, R21.2, R22.2, R23.2, R28.1, R29.2, T1.E, T2.E, T3.E, T4.E, T5.E, T6.E, U1.2 (VDD), U1.8 (VDDIO), U2.2 (VDD), U2.8 (VDDIO), U$1.P$5 (LEDA), U$1.P$8 (VDD), U$2.1, U$3.P$5 (LEDA), U$3.P$8 (VDD), U$4.P$5 (LEDA), U$4.P$8 (VDD), U$5.P$5 (LEDA), U$5.P$8 (VDD), U$6.P$5 (LEDA), U$6.P$8 (VDD), U$7.P$5 (LEDA), U$7.P$8 (VDD)
GND: C1.2, C2.2, C3.2, C4.2, C5.2, C6.2, C7.2, C8.-, C9.1, C10.1, C11.2, C12.2, C13.1, C14.1, C15.1, C16.1, DISPLAY.1, EXPANSION.8, IO1.2 (GND), LED1.K (C), LED2.K (C), LED3.K (C), LED4.K (C), LED5.K (C), LED6.K (C), LED12.C, PROGRAMMING.1, S1.4, U1.5 (GND), U1.10 (GND), U2.5 (GND), U2.10 (GND), U$1.P$6 (GND), U$2.20, U$3.P$6 (GND), U$4.P$6 (GND), U$5.P$6 (GND), U$6.P$6 (GND), U$7.P$6 (GND)
LED: R27.1, U$2.8
MAG1_SDA: R21.1, U1.6 (SDA), U$2.13
MAG2_SDA: R22.1, U2.6 (SDA), U$2.12
MAG_SCL: R23.1, U1.7 (SCL), U2.7 (SCL), U$2.11
unnamed: R2.2, U$1.P$3 (LDR), U$1.P$4 (LEDK)
unnamed: PROGRAMMING.3, R29.1, U$2.16
unnamed: PROGRAMMING.2, U$2.17
unnamed: C10.2, U1.4 (CAP-R)
unnamed: C9.2, U1.1 (CAP-A)
unnamed: R2.1, T1.B
unnamed: R3.1, T1.C
unnamed: LED1.A, R3.2
unnamed: R5.2, U$3.P$3 (LDR), U$3.P$4 (LEDK)
unnamed: R5.1, T2.B
unnamed: R6.1, T2.C
unnamed: LED2.A, R6.2
unnamed: R8.2, U$4.P$3 (LDR), U$4.P$4 (LEDK)
unnamed: R8.1, T3.B
unnamed: R9.1, T3.C
unnamed: LED3.A, R9.2
unnamed: R11.2, U$5.P$3 (LDR), U$5.P$4 (LEDK)
unnamed: R11.1, T4.B
unnamed: R12.1, T4.C
unnamed: LED12.A, R27.2
unnamed: LED4.A, R12.2
unnamed: R16.2, U$6.P$3 (LDR), U$6.P$4 (LEDK)
unnamed: R16.1, T5.B
unnamed: R17.1, T5.C
unnamed: LED5.A, R17.2
unnamed: R19.2, U$7.P$3 (LDR), U$7.P$4 (LEDK)
unnamed: R19.1, T6.B
unnamed: R20.1, T6.C
unnamed: LED6.A, R20.2
unnamed: S1.2, U$2.9
unnamed: C13.2, U2.1 (CAP-A)
unnamed: C14.2, U2.4 (CAP-R)
RGB_SCL: R28.2, U$1.P$7 (SCL), U$2.10, U$3.P$7 (SCL), U$4.P$7 (SCL), U$5.P$7 (SCL), U$6.P$7 (SCL), U$7.P$7 (SCL)
SCL: DISPLAY.3, EXPANSION.4, IO1.4 (SCK), R14.1, U$2.14
SDA: DISPLAY.4, EXPANSION.2, IO1.1 (DATA), R13.1, U$2.15
SDA0: R1.1, U$1.P$1 (SDA), U$2.2
SDA1: R4.1, U$2.3, U$3.P$1 (SDA)
SDA2: R7.1, U$2.4, U$4.P$1 (SDA)
SDA3: R10.1, U$2.5, U$5.P$1 (SDA)
SDA4: R15.1, U$2.6, U$6.P$1 (SDA)
SDA5: R18.1, U$2.7, U$7.P$1 (SDA)

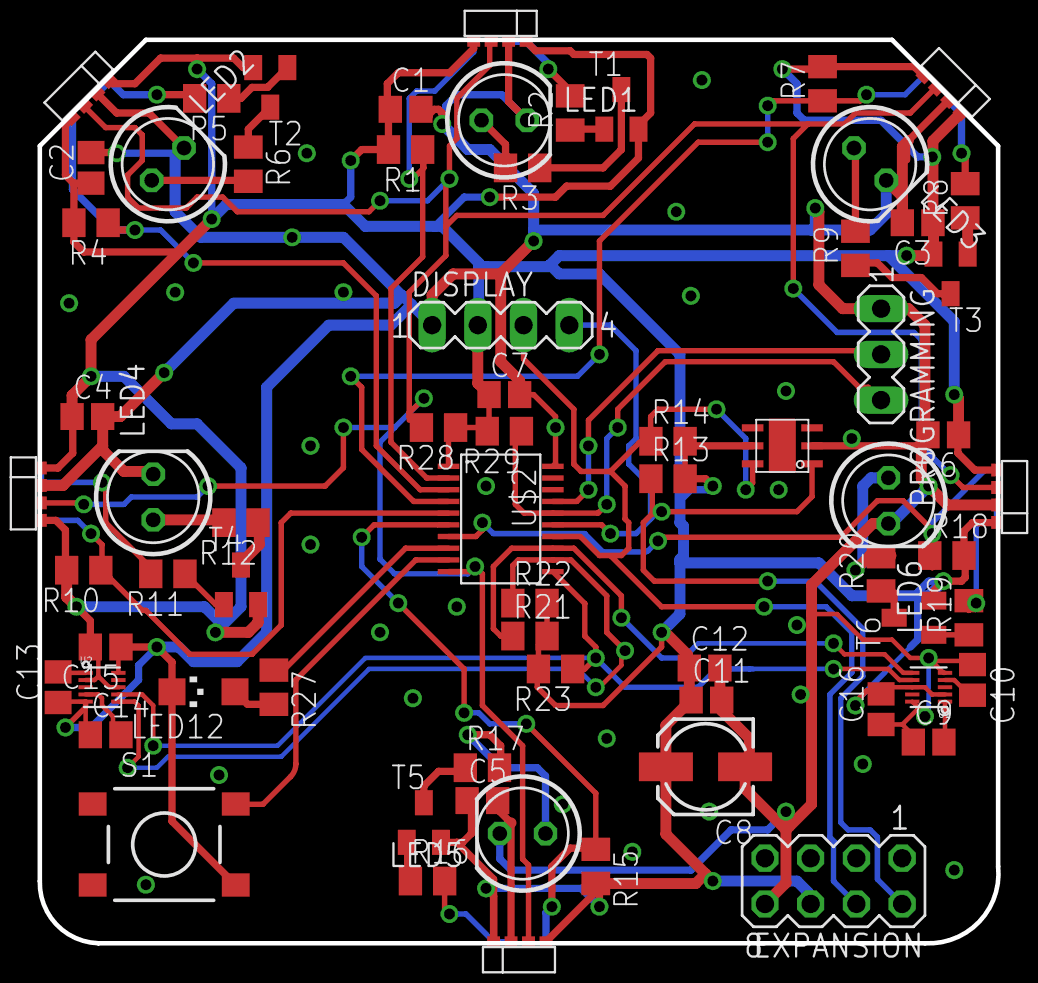
[picture p104: board sensor_board.brd from above]

Board: 2 copper layers, 53.3 x 50.2 mm, 69 parts (0 on the bottom side), 47 nets.
