richese/aeris/embedded/src/2.1.0/bin/main.asm

bin/main.elf:     file format elf32-littlearm


Disassembly of section .text:

08000188 <thread_ending>:
 8000188:	b672      	cpsid	i
 800018a:	4b05      	ldr	r3, [pc, #20]	; (80001a0 <thread_ending+0x18>)
 800018c:	4a05      	ldr	r2, [pc, #20]	; (80001a4 <thread_ending+0x1c>)
 800018e:	681b      	ldr	r3, [r3, #0]
 8000190:	210c      	movs	r1, #12
 8000192:	fb01 2303 	mla	r3, r1, r3, r2
 8000196:	2200      	movs	r2, #0
 8000198:	605a      	str	r2, [r3, #4]
 800019a:	b662      	cpsie	i
 800019c:	bf00      	nop
 800019e:	e7fd      	b.n	800019c <thread_ending+0x14>
 80001a0:	20000098 	.word	0x20000098
 80001a4:	20000050 	.word	0x20000050

080001a8 <null_thread>:
 80001a8:	b508      	push	{r3, lr}
 80001aa:	f002 f8c1 	bl	8002330 <sleep>
 80001ae:	e7fc      	b.n	80001aa <null_thread+0x2>

080001b0 <scheduler>:
 80001b0:	b570      	push	{r4, r5, r6, lr}
 80001b2:	2200      	movs	r2, #0
 80001b4:	4611      	mov	r1, r2
 80001b6:	4b15      	ldr	r3, [pc, #84]	; (800020c <scheduler+0x5c>)
 80001b8:	200c      	movs	r0, #12
 80001ba:	fb00 f501 	mul.w	r5, r0, r1
 80001be:	195e      	adds	r6, r3, r5
 80001c0:	6874      	ldr	r4, [r6, #4]
 80001c2:	f014 0f02 	tst.w	r4, #2
 80001c6:	461c      	mov	r4, r3
 80001c8:	d10a      	bne.n	80001e0 <scheduler+0x30>
 80001ca:	6876      	ldr	r6, [r6, #4]
 80001cc:	07f6      	lsls	r6, r6, #31
 80001ce:	d507      	bpl.n	80001e0 <scheduler+0x30>
 80001d0:	4350      	muls	r0, r2
 80001d2:	5b5d      	ldrh	r5, [r3, r5]
 80001d4:	5a18      	ldrh	r0, [r3, r0]
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
 8001dc2:	f023 0301 	bic.w	r3, r3, #1
 8001dc6:	6003      	str	r3, [r0, #0]
 8001dc8:	4770      	bx	lr

08001dca <USART_ReceiveData>:
 8001dca:	bf00      	nop
 8001dcc:	8c80      	ldrh	r0, [r0, #36]	; 0x24
 8001dce:	f3c0 0008 	ubfx	r0, r0, #0, #9
 8001dd2:	4770      	bx	lr

08001dd4 <USART_ITConfig>:
 8001dd4:	b510      	push	{r4, lr}
 8001dd6:	bf00      	nop
 8001dd8:	bf00      	nop
 8001dda:	bf00      	nop
 8001ddc:	f3c1 2307 	ubfx	r3, r1, #8, #8
 8001de0:	2401      	movs	r4, #1
 8001de2:	b2c9      	uxtb	r1, r1
 8001de4:	2b02      	cmp	r3, #2
 8001de6:	fa04 f101 	lsl.w	r1, r4, r1
 8001dea:	d101      	bne.n	8001df0 <USART_ITConfig+0x1c>
 8001dec:	3004      	adds	r0, #4
 8001dee:	e002      	b.n	8001df6 <USART_ITConfig+0x22>
 8001df0:	2b03      	cmp	r3, #3
 8001df2:	bf08      	it	eq
 8001df4:	3008      	addeq	r0, #8
 8001df6:	6803      	ldr	r3, [r0, #0]
 8001df8:	b10a      	cbz	r2, 8001dfe <USART_ITConfig+0x2a>
 8001dfa:	4319      	orrs	r1, r3
 8001dfc:	e001      	b.n	8001e02 <USART_ITConfig+0x2e>
 8001dfe:	ea23 0101 	bic.w	r1, r3, r1
 8001e02:	6001      	str	r1, [r0, #0]
 8001e04:	bd10      	pop	{r4, pc}
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
