richese/aeris/embedded/src/0.0.3/bin/main.asm

bin/main.elf:     file format elf32-littlearm


Disassembly of section .text:

08000188 <thread_ending>:
 8000188:	b672      	cpsid	i
 800018a:	4b05      	ldr	r3, [pc, #20]	; (80001a0 <thread_ending+0x18>)
 800018c:	4a05      	ldr	r2, [pc, #20]	; (80001a4 <thread_ending+0x1c>)
 800018e:	681b      	ldr	r3, [r3, #0]
 8000190:	210c      	movs	r1, #12
 8000192:	fb01 2303 	mla	r3, r1, r3, r2
 8000196:	2200      	movs	r2, #0
 8000198:	605a      	str	r2, [r3, #4]
 800019a:	b662      	cpsie	i
 800019c:	bf00      	nop
 800019e:	e7fd      	b.n	800019c <thread_ending+0x14>
 80001a0:	20000074 	.word	0x20000074
 80001a4:	20000014 	.word	0x20000014

080001a8 <null_thread>:
 80001a8:	b508      	push	{r3, lr}
 80001aa:	f001 fb33 	bl	8001814 <sleep>
 80001ae:	e7fc      	b.n	80001aa <null_thread+0x2>

080001b0 <scheduler>:
 80001b0:	b570      	push	{r4, r5, r6, lr}
 80001b2:	2200      	movs	r2, #0
 80001b4:	4611      	mov	r1, r2
 80001b6:	4b15      	ldr	r3, [pc, #84]	; (800020c <scheduler+0x5c>)
 80001b8:	200c      	movs	r0, #12
 80001ba:	fb00 f501 	mul.w	r5, r0, r1
 80001be:	195e      	adds	r6, r3, r5
 80001c0:	6874      	ldr	r4, [r6, #4]
 80001c2:	f014 0f02 	tst.w	r4, #2
 80001c6:	461c      	mov	r4, r3
 80001c8:	d10a      	bne.n	80001e0 <scheduler+0x30>
 80001ca:	6876      	ldr	r6, [r6, #4]
 80001cc:	07f6      	lsls	r6, r6, #31
 80001ce:	d507      	bpl.n	80001e0 <scheduler+0x30>
 80001d0:	4350      	muls	r0, r2
 80001d2:	5b5d      	ldrh	r5, [r3, r5]
 80001d4:	5a18      	ldrh	r0, [r3, r0]
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
 8001e50:	33322070 	.word	0x33322070
 8001e54:	31303220 	.word	0x31303220
 8001e58:	39302035 	.word	0x39302035
 8001e5c:	3a38323a 	.word	0x3a38323a
 8001e60:	000a3731 	.word	0x000a3731

08001e64 <__EH_FRAME_BEGIN__>:
 8001e64:	00000000                                ....
