richese/aeris/embedded/src/2.0.0/usr/sensors.c

#include "sensors.h"

volatile u8 device_sleep_flag = 0;


void device_sleep()
{
	device_sleep_flag = 0xff;
}

void device_wake_up()
{
	device_sleep_flag = 0;
}


void device_i2c_thread()
{
	u32 state = 0;
	u32 init_res;

 	event_timer_set_period(EVENT_TIMER_0_ID, I2C_SAMPLIG_PERIOD);


 	while (1)
 	{
		switch (state)
		{
			//init state
			case 0:
							init_res = lsm9ds0_init();					/*IMU*/
							motors_init();

							if (init_res != 0)
							{
								lsm9ds0_uninit();
								motors_uninit();
								abort_error_(ERROR_IMU, init_res);	/*init IMU error*/
							}

							state = 1;
							break;

			//common reading mode
			case 1:
							event_timer_wait(EVENT_TIMER_0_ID);
							lsm9ds0_read();
							motors_update();

							if (device_sleep_flag)
								state = 2;
							break;

			case 2:
							lsm9ds0_uninit();
							motors_uninit();

							timer_delay_ms(100);

							if (device_sleep_flag == 0)
								state = 0;
							break;
		}
 	}
}

void device_rgb_sensors_thread()
{
	u32 state = 0;
	u32 init_res;

	event_timer_set_period(EVENT_TIMER_1_ID, RGB_SAMPLIG_PERIOD);

	while (1)
	{
		event_timer_wait(EVENT_TIMER_1_ID);
		rgb_sensor_read();


		switch (state)
		{
			//init state
			case 0:
							init_res = rgb_sensor_init();							/*RGB init*/
							if (init_res != 0)
							{
								rgb_sensor_uninit();
								abort_error_(ERROR_RGB_SENSOR, init_res);	/*rgb sensors init error*/
							}
							state = 1;
							break;

			//common reading mode
			case 1:
							event_timer_wait(EVENT_TIMER_1_ID);
							rgb_sensor_read();

							if (device_sleep_flag != 0)
								state = 2;
							break;

			case 2:
							rgb_sensor_uninit();

							timer_delay_ms(100);

							if (device_sleep_flag == 0)
								state = 0;
							break;
		}
	}
}
