richese/aeris/(commit log)

2015-04-25 veriosn 1.0.2 added
    [config.txt, configuration.h]
2015-04-25 version 1.0.0 added
    [configuration.h, doxygen.cfg]
2015-04-25 common commit
    [config.txt, configuration.h]
2015-04-26 full pheromones support added and collective brain loading from files
    [config.txt, configuration.h]
2015-04-26 better pheromone spawning
    [config.txt, configuration.h]
2015-04-27 hardware release rev.1
    [aeris_main_board.kicad_pcb, aeris_main_board.sch, aeris_sensor_board.kicad_pcb, aeris_sensor_board.sch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]
2015-04-29 some work on Q learning
    [config.txt, configuration.h]
2015-05-01 work on wifi driver
2015-09-23 line follower
    [config.txt]
2016-02-08 new version
    [config.txt, configuration.h, configure.txt, main.brd, main.sch, sensor_board.brd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]
2016-02-11 cpu board
    [main.brd, main.sch]
2016-02-20 wifi driver added
2016-02-26 work on IMU
2016-03-12 first version done
    [configure.txt]
2016-03-15 visualsiation + line follower example
    [configure.txt]
2016-04-06 color recognition
    [configure.txt]
2016-04-06 micro bot added
    [main.brd, main.sch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]
